hu-po/tatbot/README.md

<div align="center">
  <a href="https://tatbot.ai/">
    <picture>
      <source media="(prefers-color-scheme: dark)" srcset="docs/logos/dark.svg">
      tatbot
    </picture>
  </a>
</div>
<div align="center">
  
  
  <a href="https://poly.cam/capture/89a7df7a-9871-493c-aed9-289028c1e38e" target="_blank" rel="noopener noreferrer">
    
  </a>
  <a href="https://huggingface.co/tatbot/datasets">
    
  </a>
  <br>
  <a href="https://x.com/tatbots">
    
  </a>
  <a href="https://www.tiktok.com/@tatbottok">
    
  </a>
  <a href="https://www.instagram.com/tatbots/">
    
  </a>
  <a href="https://www.youtube.com/@tatbot">
    
  </a>
</div>

# **tatbot**: tattoo robot

Tatbot is an open robotics project exploring robot-assisted tattoo design and
placement. The repository contains the software, data formats, and examples
used by developers and artists contributing to the project.

📚 Read the [documentation](https://hu-po.github.io/tatbot/)

🎥 Watch the [livestream](https://youtube.com/live/ym27ZHPMaec)

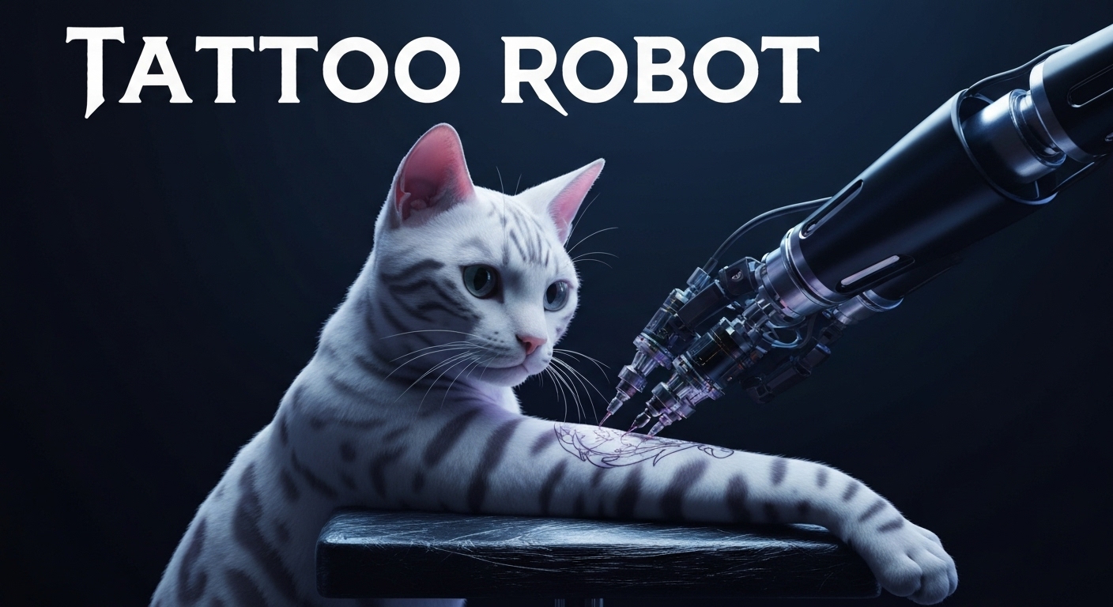
[picture p1: docs/images/thumbnail.jpg]
YouTube Video (https://youtube.com/live/ym27ZHPMaec)


## Citation

```
@misc{tatbot-2025,
  title={tatbot},
  author={Hugo Ponte},
  year={2025},
  url={https://github.com/hu-po/tatbot}
}
```
