hu-po/tatbot/scripts/vision/requirements-observer.txt

# The stencil observer's interpreter on the camera node (`stencild`).
#
# fleet_deploy.py builds `<release>/observer-venv` from this file for the
# node that runs tatbot-stencild.service. The observer runs
# scripts/vision/stencil_observer.py: the fiducial-tile reading
# (fiducials.stencil, numpy and OpenCV only) and the digest-bound capture
# readers under scripts/lib and scripts/vision. No RealSense wheel: distortion deprojection is the numpy
# port pinned by the checked-in SDK table. scipy is deliberately absent: only
# the session scan-binding path reaches it, and the fleet observer never
# binds a scan.
numpy==2.5.4
opencv-python-headless==5.0.0.93
