hu-po/tatbot/docs/index.md

---
summary: Public Tatbot developer and artist documentation
tags: [index, public]
updated: 2026-09-03
audience: [dev, artist, contributor]
---

# Tatbot

Tatbot is an open robotics project for exploring robot-assisted tattoo design
and placement. This site documents public technical interfaces:
teleoperation, vision concepts, Inkmap, contribution workflow, and safety scope.

```{admonition} Scope
:class: warning

The public project is a research and software collaboration, not a tattooing
service or a medical device. The drawing stack tattoos practice skin and human
skin behind the interlocks in [safety scope](safety.md); replay and the mock
arm are the quickest way to develop.
```

## Start here

- [Overview and installation](development.md)
- [For artists: design and placement data](design-format.md)
- [Turn placement words into a body location with InkLang](inklang.md)
- [For developers: architecture](architecture.md)
- [Contributing](contributing.md)
- [Work: worktrees, landing, the sweeper](work.md)

## Public systems

- [Robot model and kinematics](robot.md)
- [Teleoperation](teleop_tuning.md)
- [Vision and fiducials](vision.md)
- [The skin stencil: fiducial tiles](stencil-frames.md)
- [Rig sleep and wake](rig.md)
- [Fleet deploy, releases and services](fleet.md)
- [Imitation-learning interfaces](imitation_learning.md)
- [Inkmap preview](inkmap.md)
- [DrawingBotV3 stroke experiments](drawingbot.md)
- [Tools and configuration](tools.md)
- [Bill of materials](bill-of-materials.md)
- [Run-log format](run_logs.md)

## Safety and reference

- [Safety scope](safety.md)
- [Hardware e-stop contract](estop.md)
- [Command-line reference](cli.md)
- [Configuration](configuration.md)
- [Documentation style](style_guide.md)
- [Release notes](release-notes.md)

```{toctree}
:maxdepth: 2
:caption: Contents
:hidden:

development
design-format
architecture
contributing
work
robot
teleop_tuning
fleet
surface-formats
vision
stencil-frames
rig
demo-stack
fiducials
ordered_fiducials
ee_fiducial_tracking
imitation_learning
inkmap
human-representation
drawingbot
research
inklang
ink
palette
tools
bill-of-materials
run_logs
safety
estop
cli
configuration
style_guide
release-notes
logos/index
```
