hu-po/tatbot/docs/cli.md

# `tatbot` command reference

<!-- GENERATED by `scripts/tatbot schema --md > docs/cli.md`. Do not edit; `scripts/check cli` fails when stale. -->

Offline CLI workflows for public development and replay. Maintainers can inspect the complete machine-readable schema with `tatbot schema --json`.

```
tatbot [global flags] <noun> [verb] [args] [-- passthrough args]
```

Global flags may appear anywhere before the first `--`, as `--flag value` or `--flag=value`, unless a declared command option owns that spelling: `--json`, `--dry-run`, `--explain`, `-q`, `-v`. Stating one twice with different values is a usage error.

`--json` execution is supported only by commands declaring structured output in `schema --json`; all commands support JSON plans and explanations. Backend flags on structured commands require `--`; tokens after it are preserved.

CLI-owned exit codes are below. Executed backends and SSH retain their own exit codes and error output; backend failures are not remapped to 1.

## Exit codes

| code | meaning |
| --- | --- |
| 0 | ok |
| 1 | underlying tool failed |
| 2 | usage error |
| 3 | safety gate refused |
| 4 | wrong node for this verb |
| 5 | hardware unreachable |
| 6 | busy |

## Safety tiers

| tier | meaning | gates |
| --- | --- | --- |
| `offline` | files only | — |

## Verbs

### `tatbot completion` — generate opt-in shell completion

| verb | tier | runs on | wraps | summary |
| --- | --- | --- | --- | --- |
| `completion bash` | `offline` | this checkout | native | print Bash completion generated from canonical command metadata |

### `tatbot body` — immutable human body model assets and cache audit

| verb | tier | runs on | wraps | summary |
| --- | --- | --- | --- | --- |
| `body bootstrap` | `offline` | this checkout | native | copy a pinned, pre-downloaded MHR and SOMA allowlist into an explicit verified cache |
| `body audit` | `offline` | this checkout | native | read and hash every byte in an explicit MHR and SOMA cache without deserializing it |

### `tatbot teleop` — leader→follower teleoperation

| verb | tier | runs on | wraps | summary |
| --- | --- | --- | --- | --- |
| `teleop poses` | `offline` | this checkout | `scripts/vision/teleop_poses.py` | export measured follower tip poses and host read timestamps from a flight log (`--ee-tool`) |
| `teleop analyze` | `offline` | this checkout | `cpp/teleop/analyze_log.py` | loop-timing stats from a .wxtl without a GUI |

### `tatbot rollout` — offline checks of a trained policy: its contract, its action plausibility

| verb | tier | runs on | wraps | summary |
| --- | --- | --- | --- | --- |
| `rollout bench` | `offline` | this checkout | `scripts/eval/trajectory_plausibility.py` | no-robot plausibility check of a policy's action chunks (`--` → trajectory_plausibility.py) |
| `rollout contract` | `offline` | this checkout | `scripts/eval/checkpoint_contract.py` | the input/action contract stored with a checkpoint (`--` → checkpoint_contract.py) |

### `tatbot calib` — native arm measurements and retained overhead registration

| verb | tier | runs on | wraps | summary |
| --- | --- | --- | --- | --- |
| `calib register-fit` | `offline` | this checkout | `scripts/vision/native_registration.py` | fit an unadopted overhead registration from original native holds and shared geometry |

### `tatbot vision` — offline vision processing and calibration

| verb | tier | runs on | wraps | summary |
| --- | --- | --- | --- | --- |
| `vision depth compare` | `offline` | this checkout | `scripts/vision/depth_compare.py` | compare filters on a retained raw scan burst |
| `vision stencil generate` | `offline` | this checkout | `scripts/lib/stencil_generate.py`, `scripts/lib/stencil_tile.py` | generate the skin stencil: a fiducial tile of AprilTag 16h5 markers with its 300 dpi print |
| `vision stencil reference` | `offline` | this checkout | `scripts/lib/stencil_reference.py` | export a tracking manifest for a generated fiducial tile, and install it where the observer reads |
| `vision tags print` | `offline` | this checkout | `scripts/vision/generate_wrist_tags.py` | render the wrist-tag print sheet (`--` → generate_wrist_tags.py) |
| `vision handeye d405` | `offline` | this checkout | `scripts/vision/d405_handeye_plane.py` | plane-route hand-eye for the wrist D405s: fit depth planes against the touched-off paper (`--` → d405_handeye_plane.py) |

### `tatbot drawingbot` — DrawingBotV3 stroke experiments and preference review

| verb | tier | runs on | wraps | summary |
| --- | --- | --- | --- | --- |
| `drawingbot generate` | `offline` | this checkout | `scripts/drawingbot.sh`, `scripts/drawingbot.py`, `scripts/lib/drawing_python.sh`, `scripts/lib/drawing_python.py`, `scripts/lib/drawingbot/artifacts.py`, `scripts/lib/drawingbot/bridge.py`, `scripts/lib/drawingbot/replay.py`, `scripts/lib/drawingbot/recipe.py`, `scripts/lib/drawingbot/container.py`, `scripts/lib/drawingbot/job.py`, `scripts/lib/drawingbot/pens.py` | generate one physical DBV3 drawing with verified settings and a saved native recipe |
| `drawingbot export` | `offline` | this checkout | `scripts/drawingbot.sh`, `scripts/drawingbot.py`, `scripts/lib/drawing_python.sh`, `scripts/lib/drawing_python.py`, `scripts/lib/drawingbot/artifacts.py`, `scripts/lib/drawingbot/bridge.py`, `scripts/lib/drawingbot/replay.py`, `scripts/lib/drawingbot/recipe.py`, `scripts/lib/drawingbot/container.py` | verify and replay native SVG acquisition only, without ROS compilation |
| `drawingbot container` | `offline` | this checkout | `scripts/drawingbot.sh`, `scripts/drawingbot.py`, `scripts/lib/drawing_python.sh`, `scripts/lib/drawing_python.py`, `scripts/lib/drawingbot/artifacts.py`, `scripts/lib/drawingbot/bridge.py`, `scripts/lib/drawingbot/replay.py`, `scripts/lib/drawingbot/recipe.py`, `scripts/lib/drawingbot/container.py` | build, smoke-test or run the private mounted-app acquisition container |

### `tatbot inkmap` — ground InkLang placements and preview tattoos on canonical bodies

| verb | tier | runs on | wraps | summary |
| --- | --- | --- | --- | --- |
| `inkmap dev` | `offline` | this checkout | `scripts/inkmap_dev.sh`, `web/inkmap/package.json` | the tattoo preview app on this machine (`--` → inkmap_dev.sh) |
| `inkmap resolve` | `offline` | this checkout | `web/inkmap/tools/resolve.ts`, `config/inkmap/inklang-resolution.schema.json`, `web/inkmap/package.json` | resolve InkLang placement text to a canonical rest-surface anchor as JSON |
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
