hu-po/tatbot/docs/development.md

---
summary: Public setup and developer workflows
tags: [setup, development]
updated: 2026-08-31
audience: [dev, contributor]
---

# Development

Tatbot is a collection of independently buildable components. You can work
on the web app, replay tools or the mock arm without access to robot hardware.

## Prerequisites

- Git
- Python 3.12 and `uv`
- A C++ toolchain and CMake for teleoperation work
- Rust and Cargo for the vision service
- Node.js 22 or newer for Inkmap
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
