hu-po/tatbot/docs/assets/stencil-coded/1/stencil.png

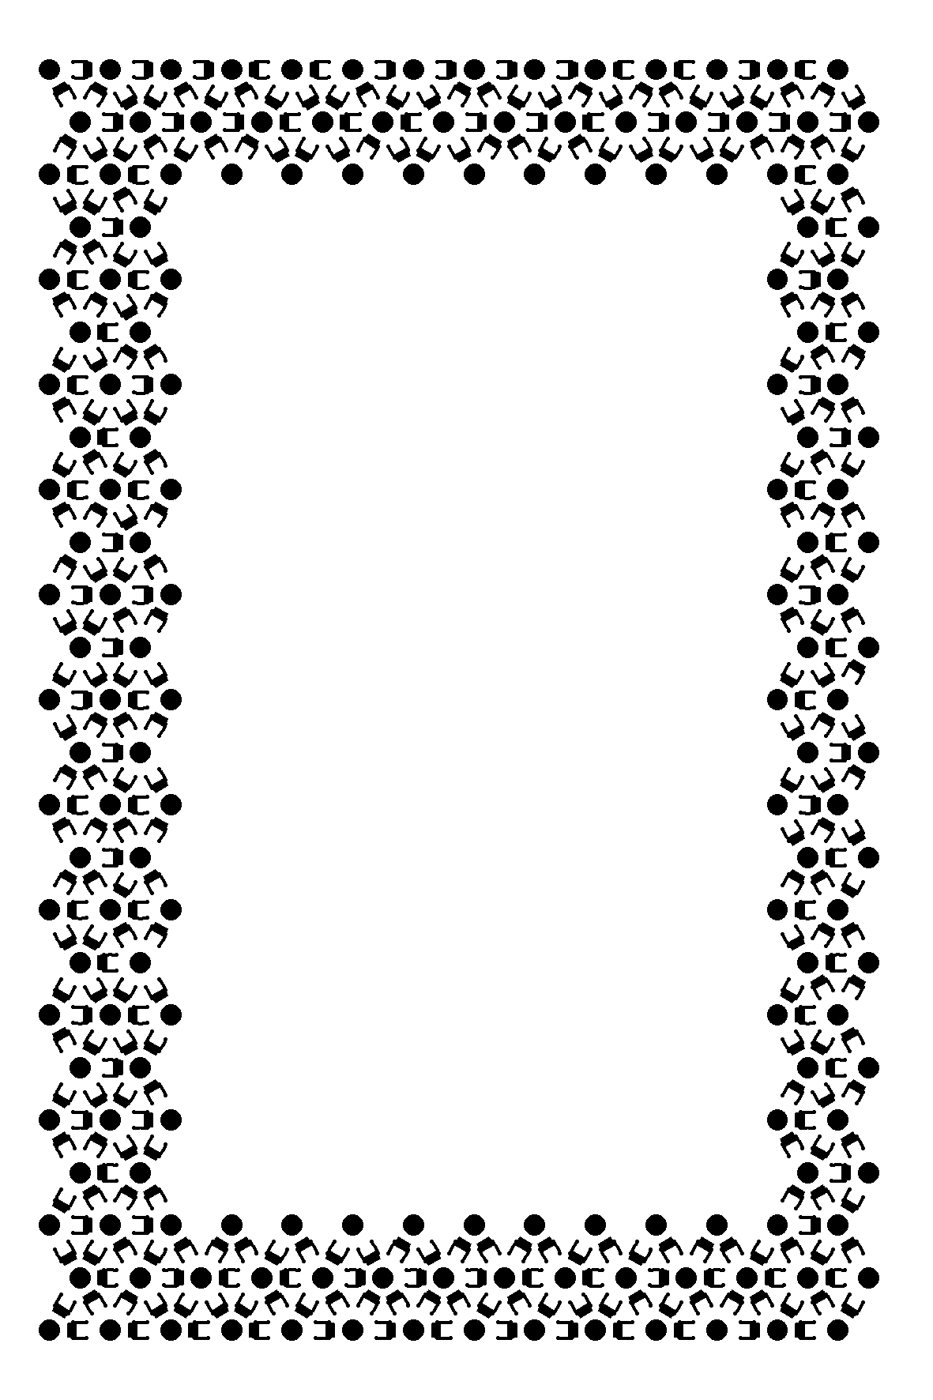
docs/assets/stencil-coded/1/stencil.png
