hu-po/tatbot/docs/assets/stencil-coded/3/stencil.png

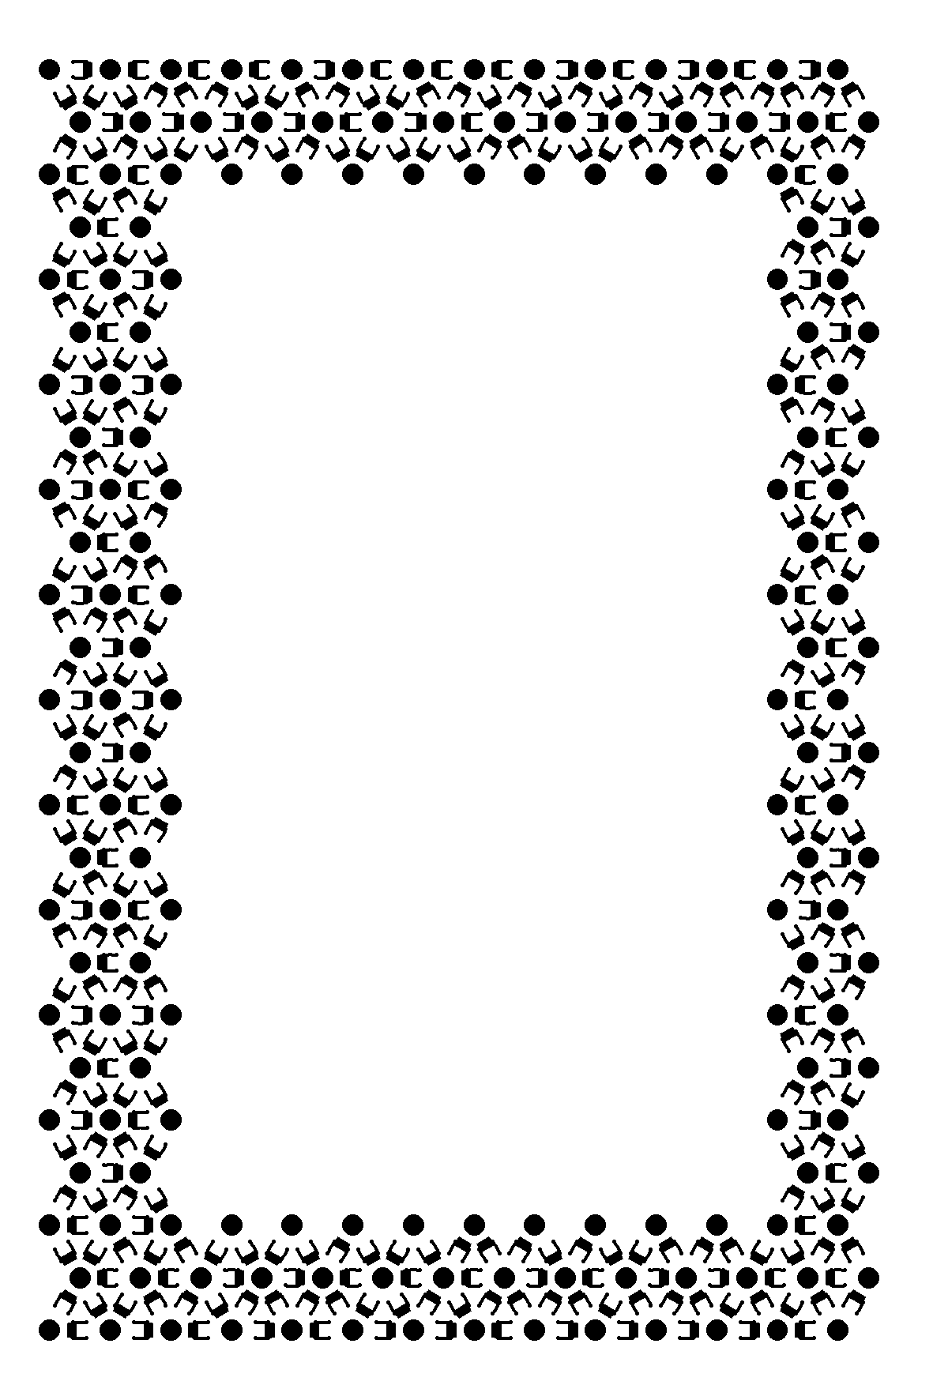
docs/assets/stencil-coded/3/stencil.png
