hu-po/tatbot/docs/assets/stencil-frames/tatbot-42/stencil.png

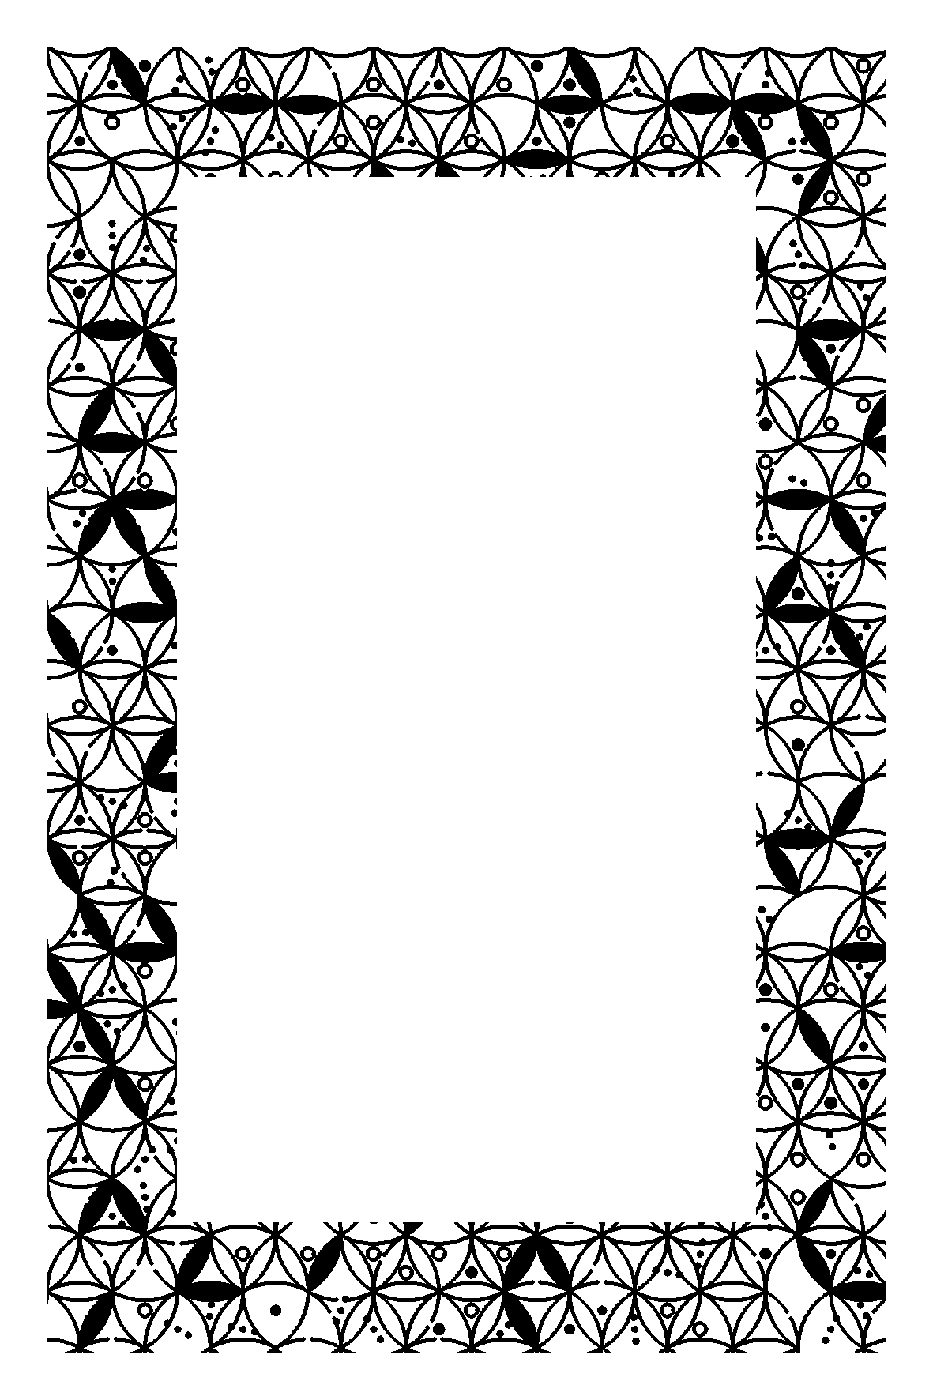
docs/assets/stencil-frames/tatbot-42/stencil.png
