hu-po/tatbot/docs/assets/stencil-frames/tatbot-43/stencil.png

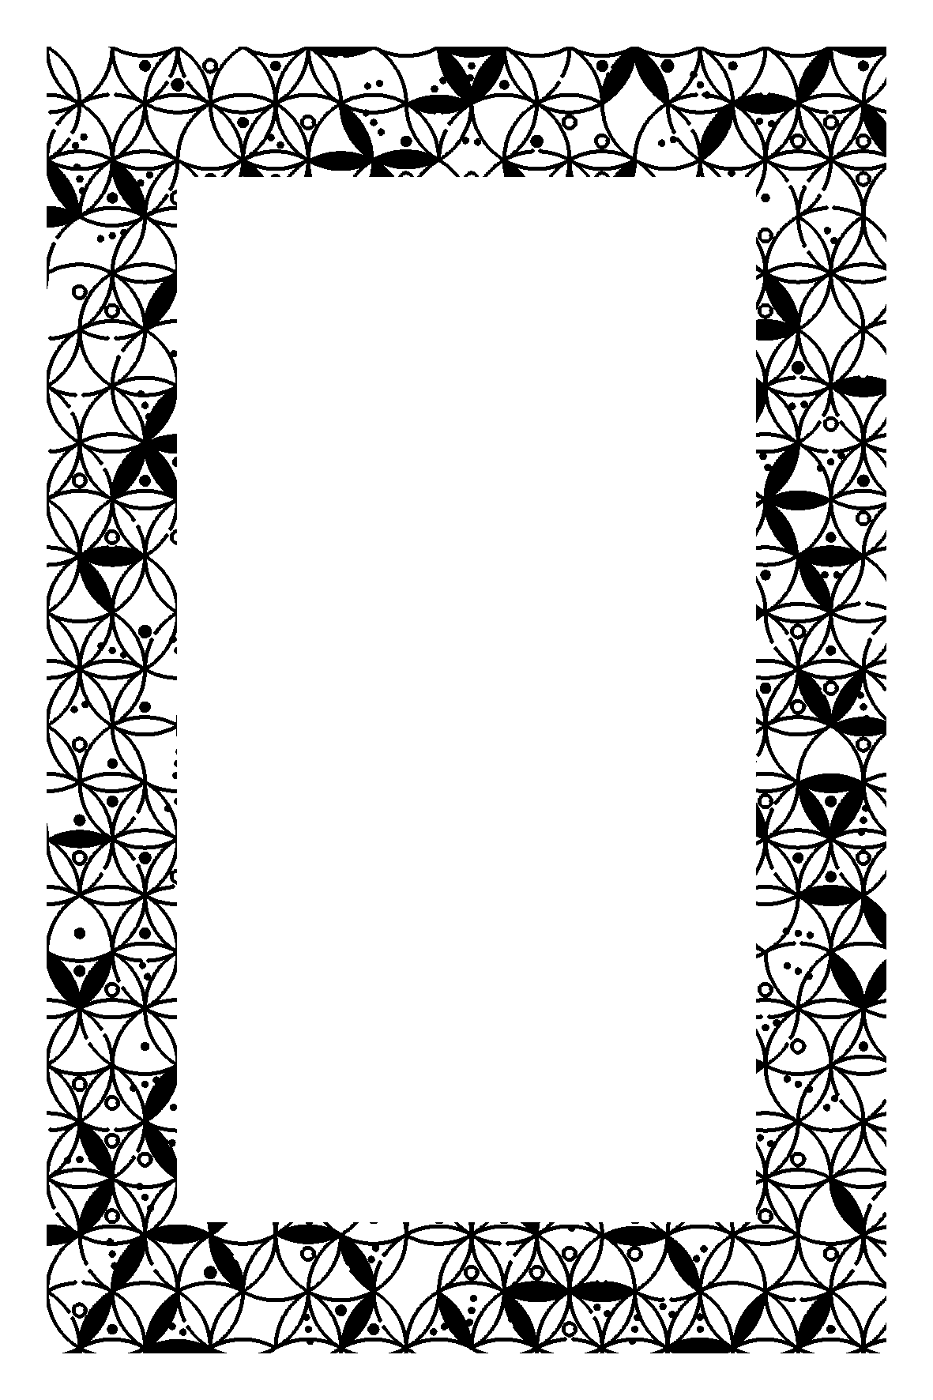
docs/assets/stencil-frames/tatbot-43/stencil.png
