hu-po/tatbot/docs/assets/stencil-frames/tatbot-44/stencil.png

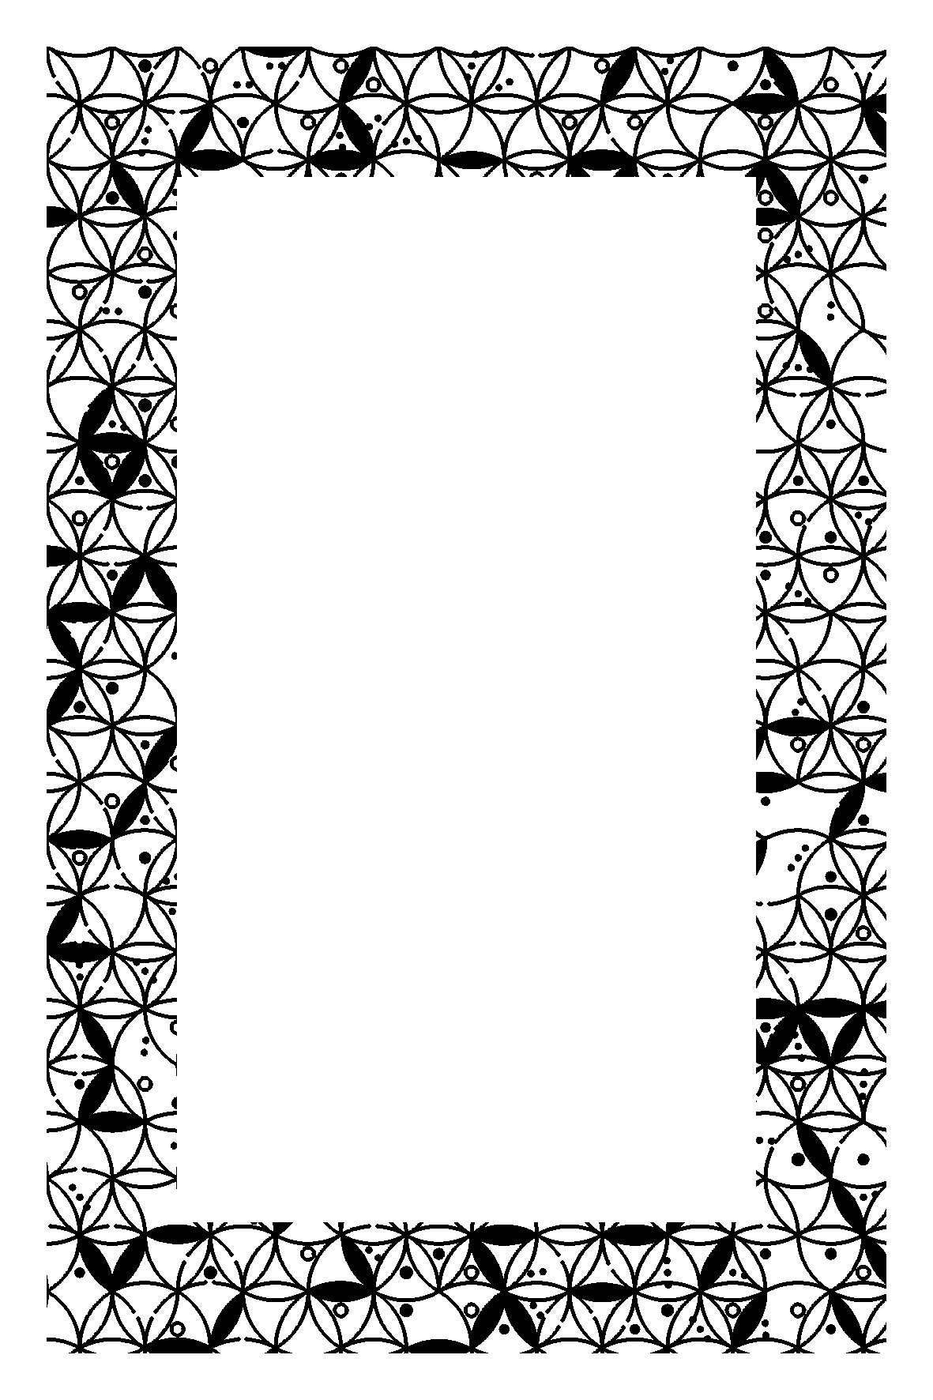
docs/assets/stencil-frames/tatbot-44/stencil.png
