hu-po/tatbot/docs/palette-tags-36h11.png

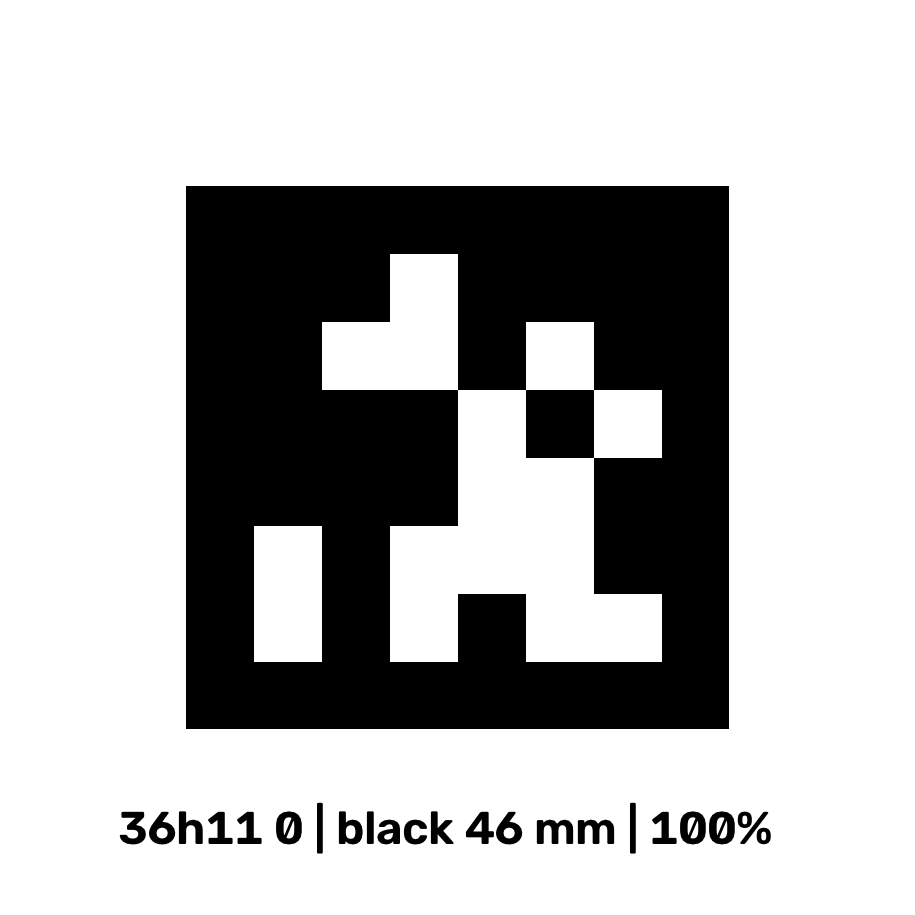
docs/palette-tags-36h11.png
