hu-po/tatbot/docs/wrist-tags-36h11.png

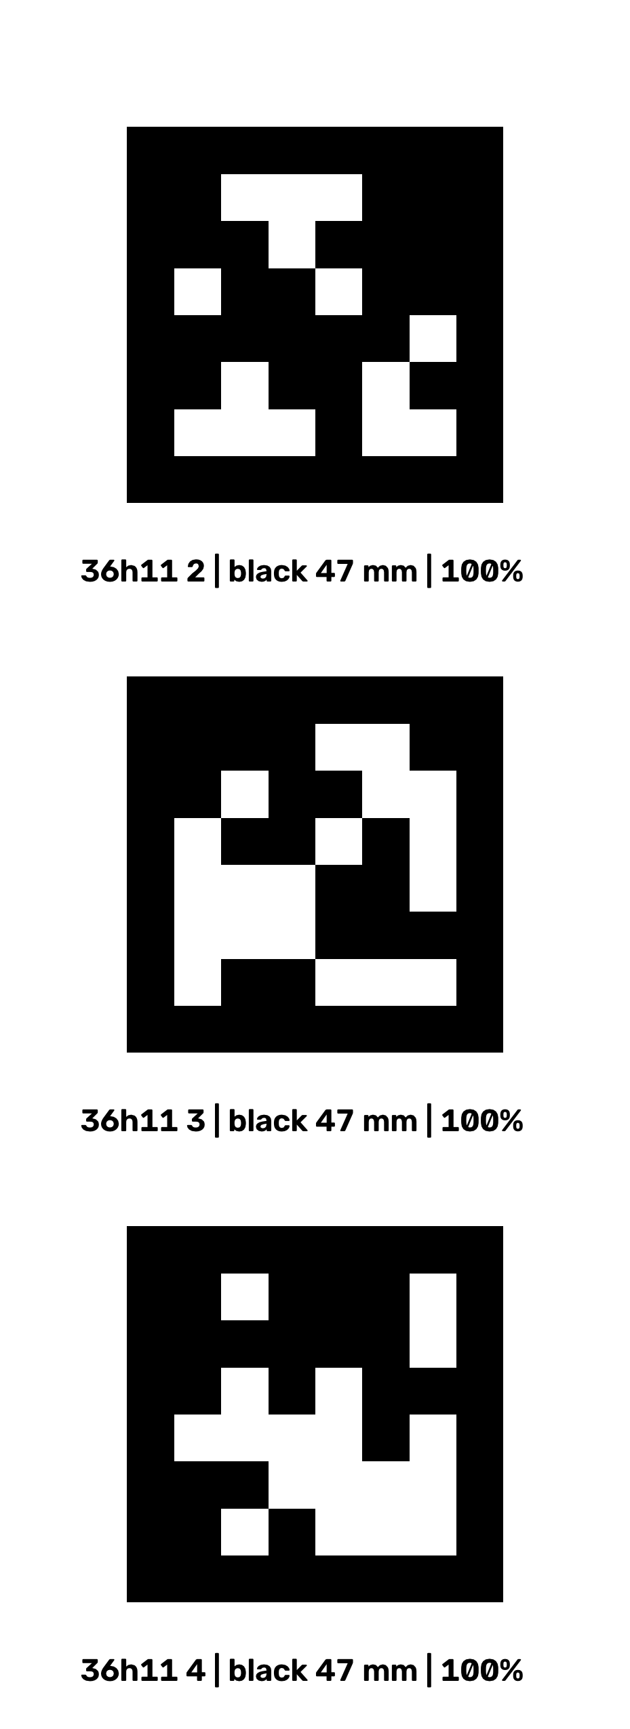
docs/wrist-tags-36h11.png
