hu-po/tatbot/docs/wrist_left-tags-36h11.png

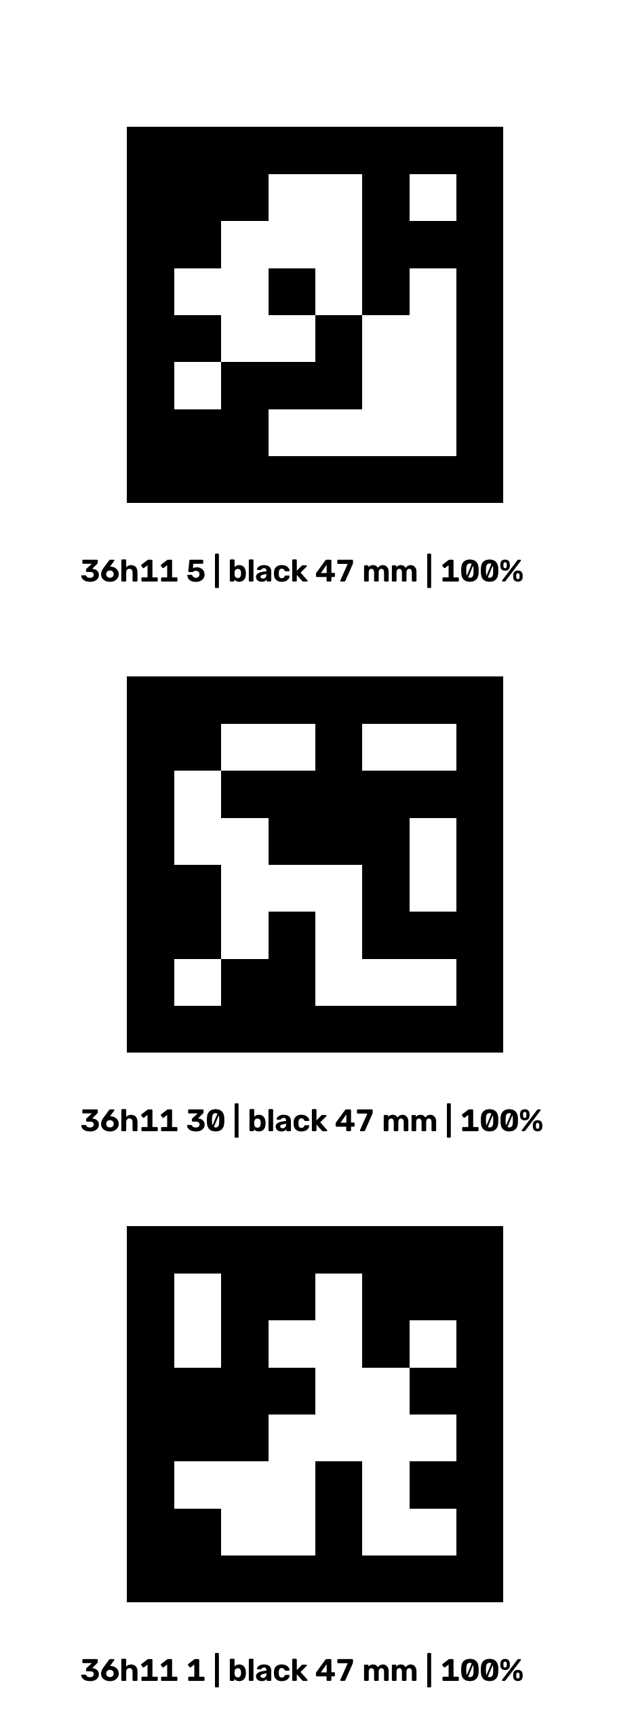
docs/wrist_left-tags-36h11.png
