hu-po/tatbot/python/tatbot_travel/src/tatbot_travel/data/selfview-left-a.png

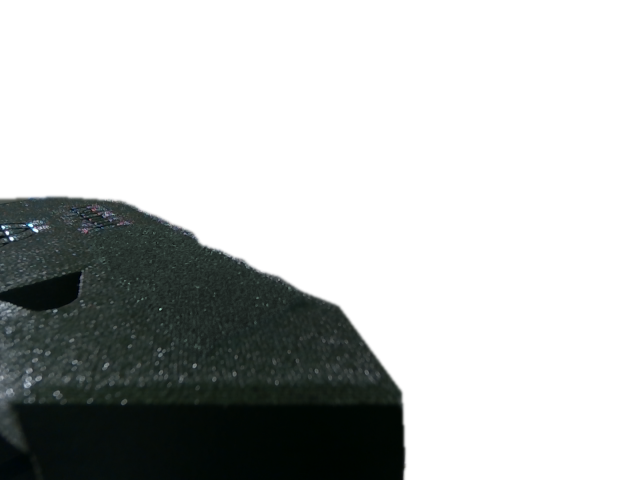
python/tatbot_travel/src/tatbot_travel/data/selfview-left-a.png
