hu-po/tatbot/python/tatbot_travel/src/tatbot_travel/data/selfview-left-b.png

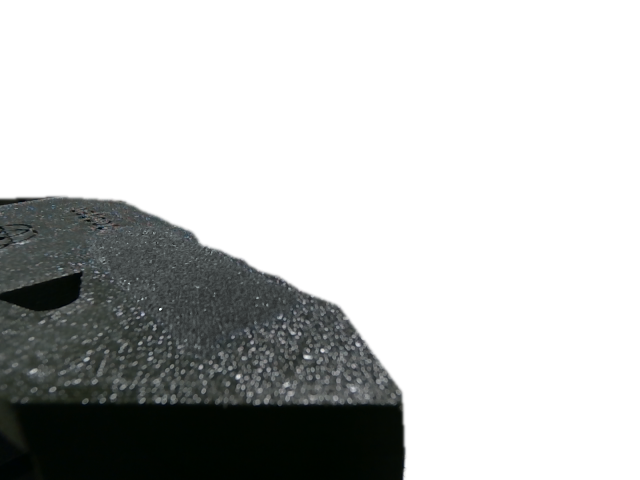
python/tatbot_travel/src/tatbot_travel/data/selfview-left-b.png
