hu-po/tatbot/urdf/meshes/tags/16h5_008_56mm/tag.png

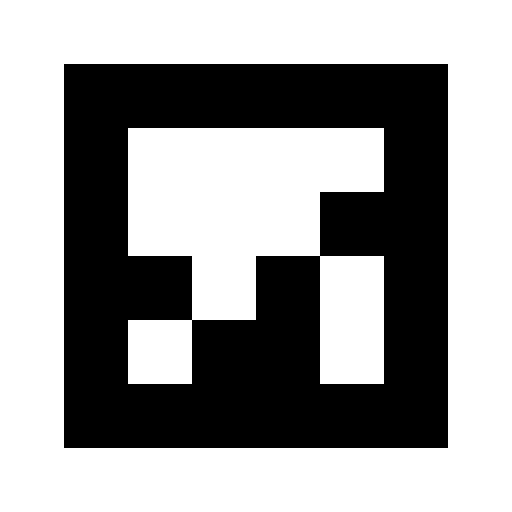
urdf/meshes/tags/16h5_008_56mm/tag.png
