hu-po/tatbot/urdf/meshes/tags/36h11_000_46mm/tag.png

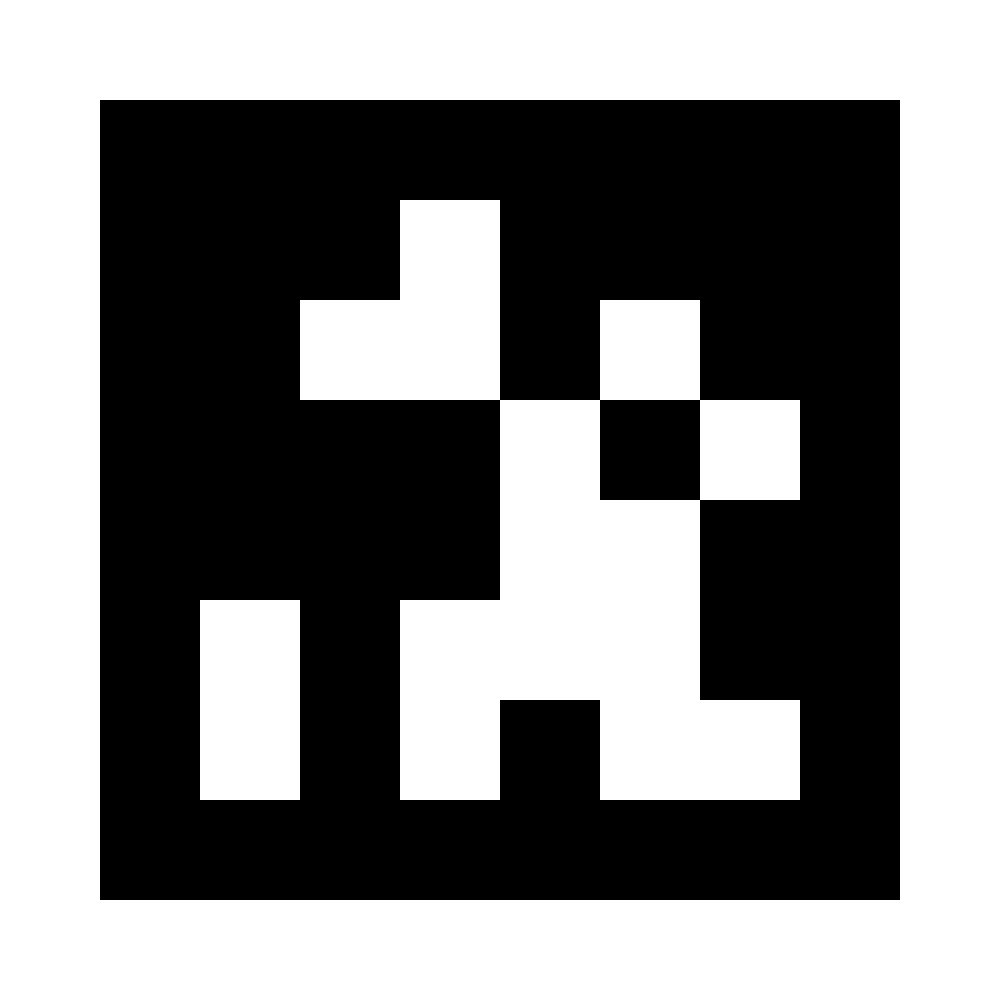
urdf/meshes/tags/36h11_000_46mm/tag.png
