hu-po/tatbot/urdf/meshes/tags/36h11_004_47mm/tag.png

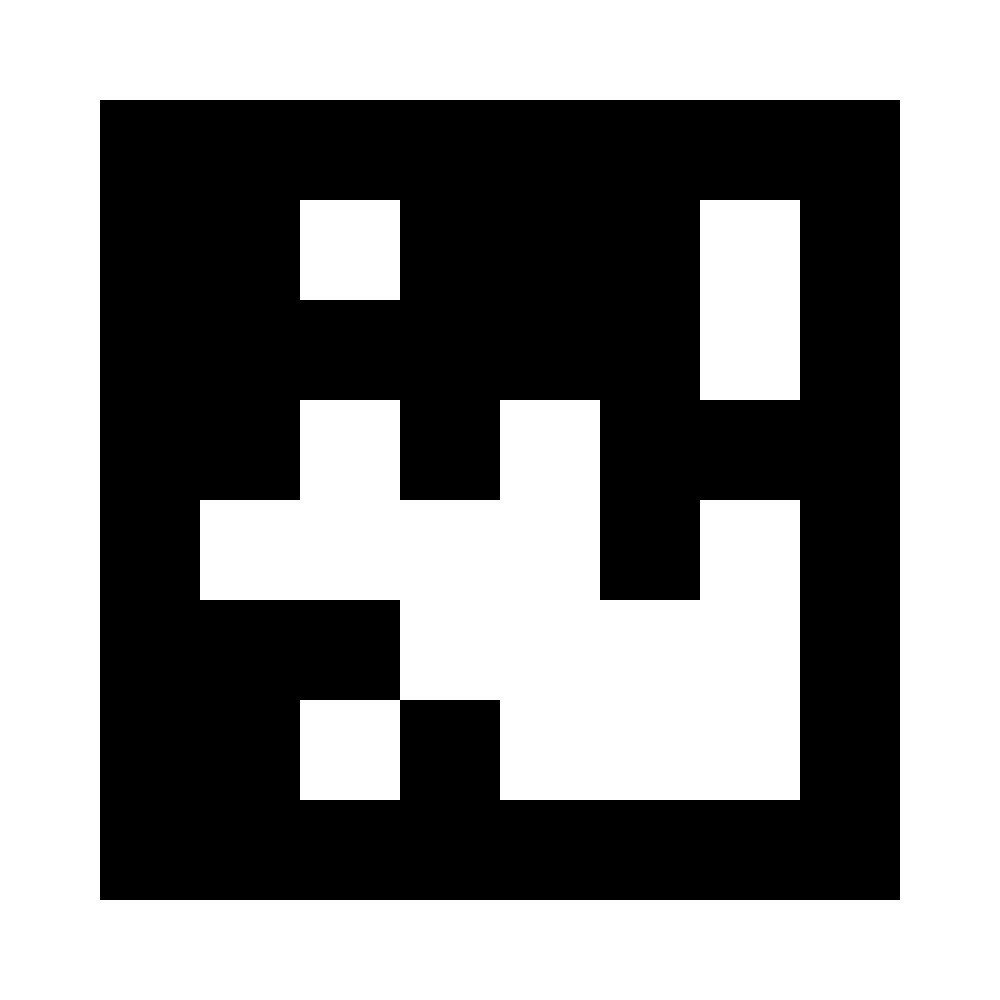
urdf/meshes/tags/36h11_004_47mm/tag.png
