hu-po/tatbot/urdf/meshes/tags/36h11_005_47mm/tag.png

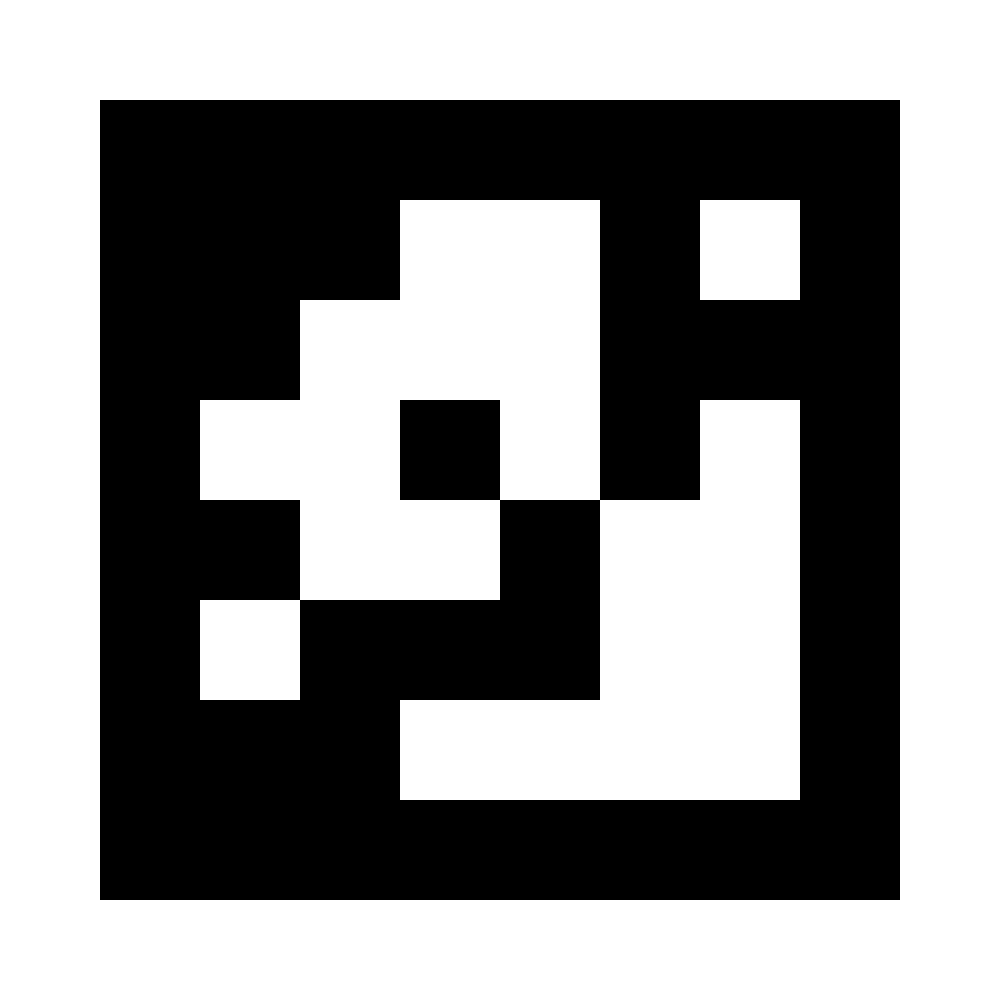
urdf/meshes/tags/36h11_005_47mm/tag.png
