hu-po/tatbot/urdf/meshes/tags/36h11_030_47mm/tag.png

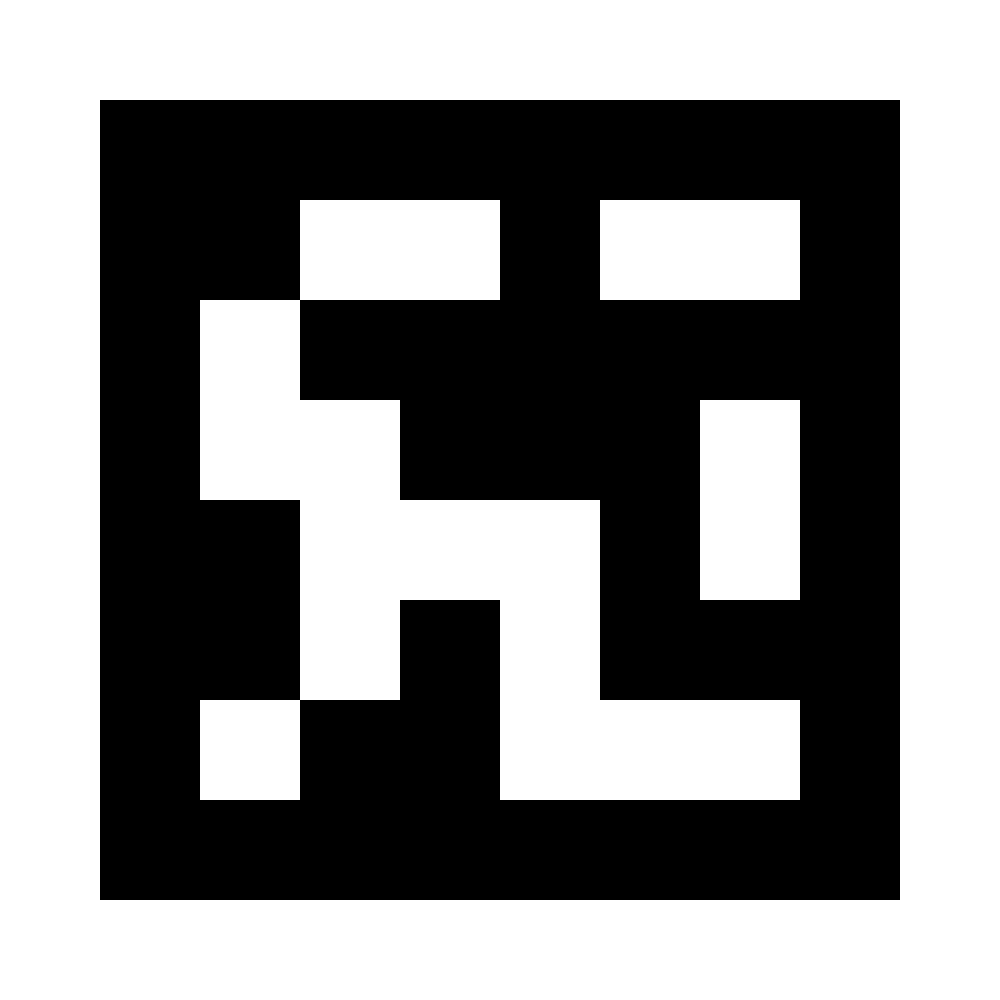
urdf/meshes/tags/36h11_030_47mm/tag.png
