hu-po/tatbot/docs/assets/ordered-fiducial-sheet.png

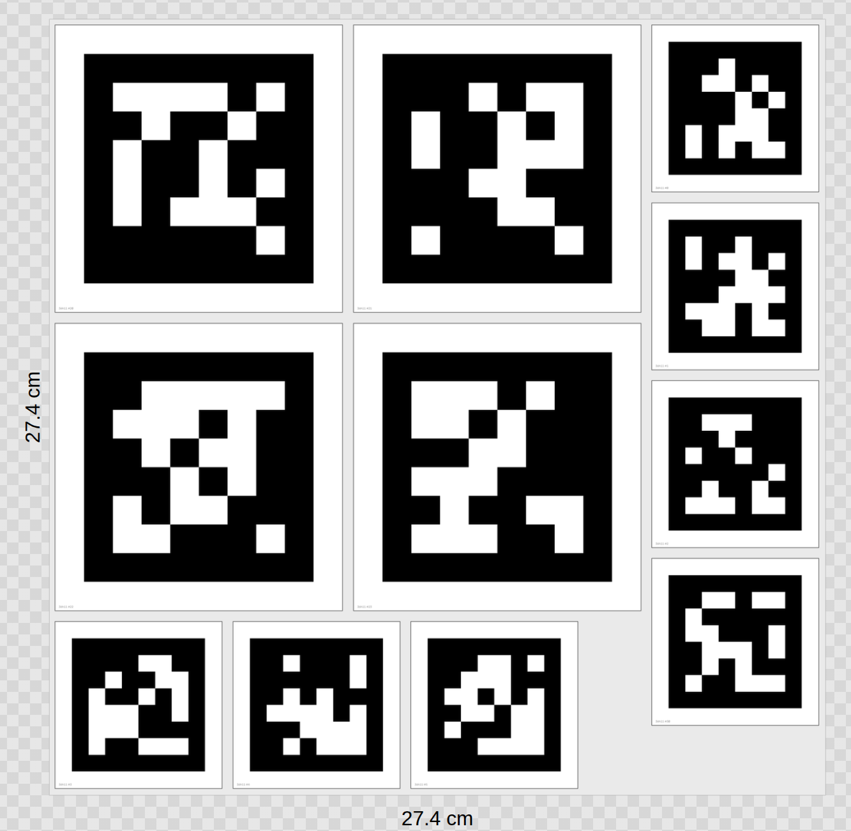
docs/assets/ordered-fiducial-sheet.png
