hu-po/tatbot/urdf/meshes/cameras/d405.stl

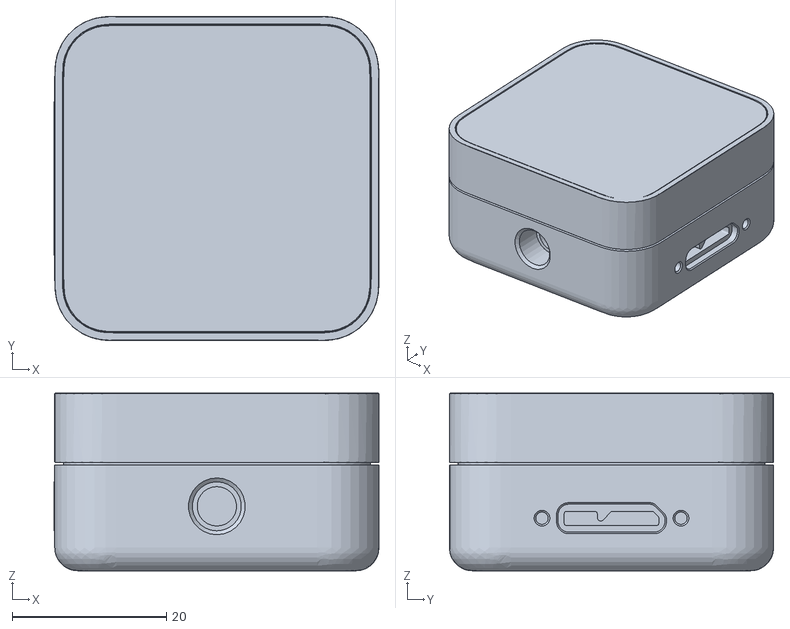
[picture p21: CAD file, 2026-09-01]
urdf/meshes/cameras/d405.stl
42.1 x 42.0 x 23.0
