hu-po/tatbot/urdf/meshes/ee/fiducial-cubes-47mm-rear/left_fiducial_cube_47mm.stl

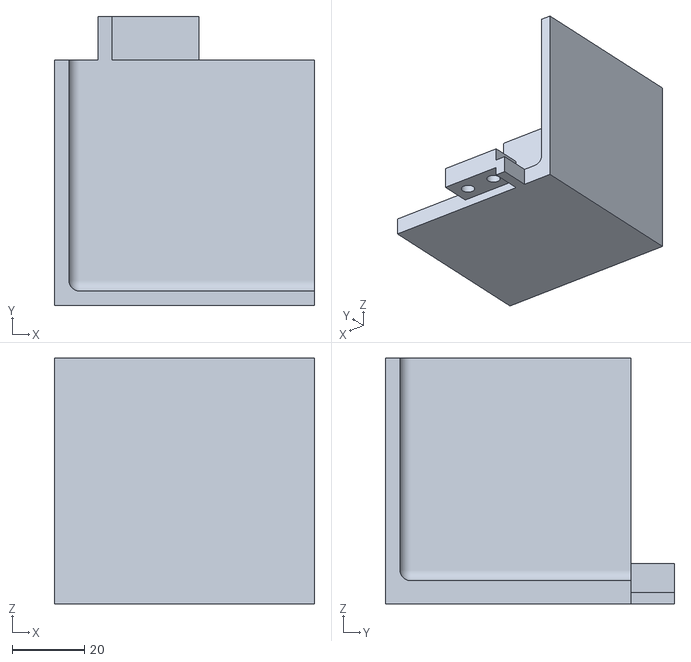
[picture p22: CAD file, 2026-10-06]
urdf/meshes/ee/fiducial-cubes-47mm-rear/left_fiducial_cube_47mm.stl
72.0 x 80.0 x 68.0
