hu-po/tatbot/urdf/meshes/ee/leader-laser-v5/02_oval_clamp_cap.stl

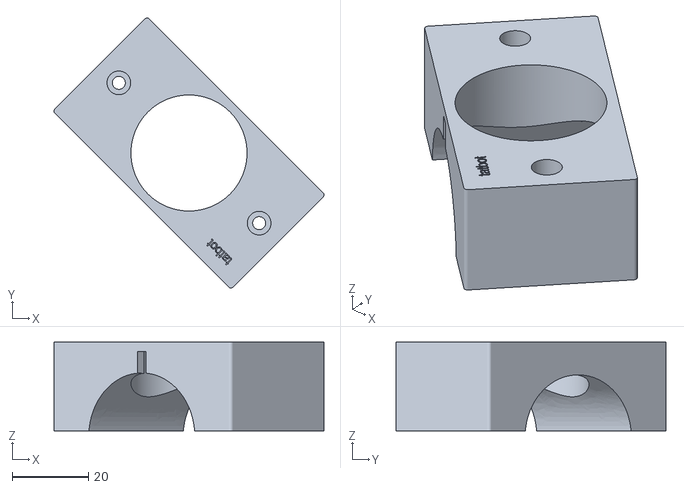
[picture p23: CAD file, 2026-10-06]
urdf/meshes/ee/leader-laser-v5/02_oval_clamp_cap.stl
70.8 x 70.8 x 23.2
