hu-po/tatbot/urdf/meshes/ee/pen_tip_v17.stl

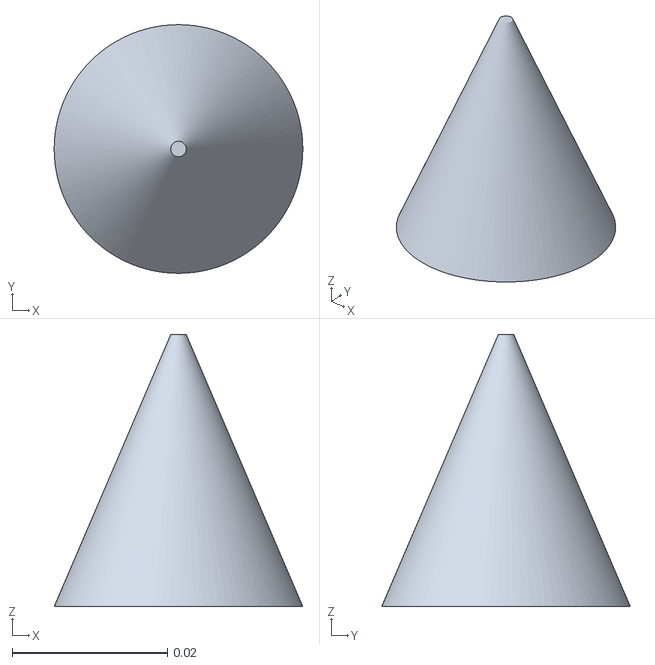
[picture p24: CAD file, 2026-10-06]
urdf/meshes/ee/pen_tip_v17.stl
0.032 x 0.032 x 0.035
