hu-po/tatbot/urdf/meshes/ee/v17/01_cradle_and_brace.stl

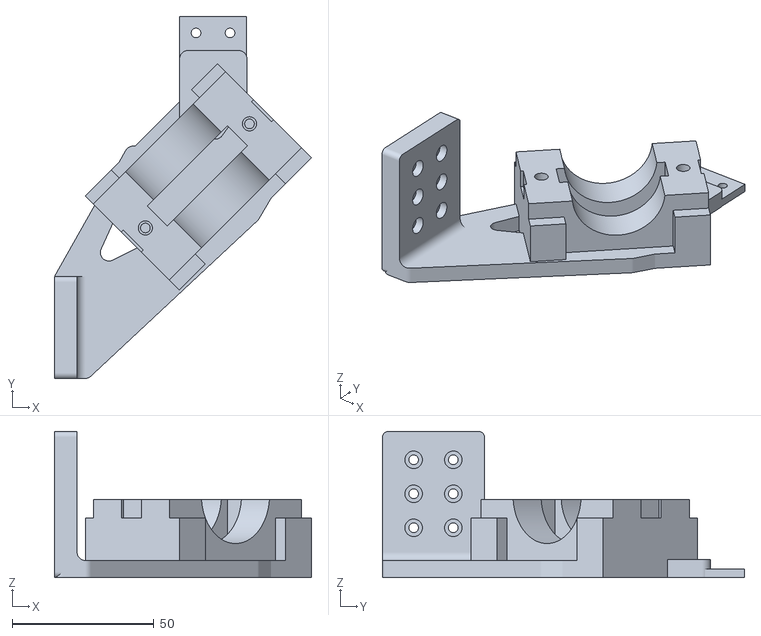
[picture p25: CAD file, 2026-10-06]
urdf/meshes/ee/v17/01_cradle_and_brace.stl
90.8 x 127.8 x 51.6
