hu-po/tatbot/urdf/meshes/frame/t2020_600mm.stl

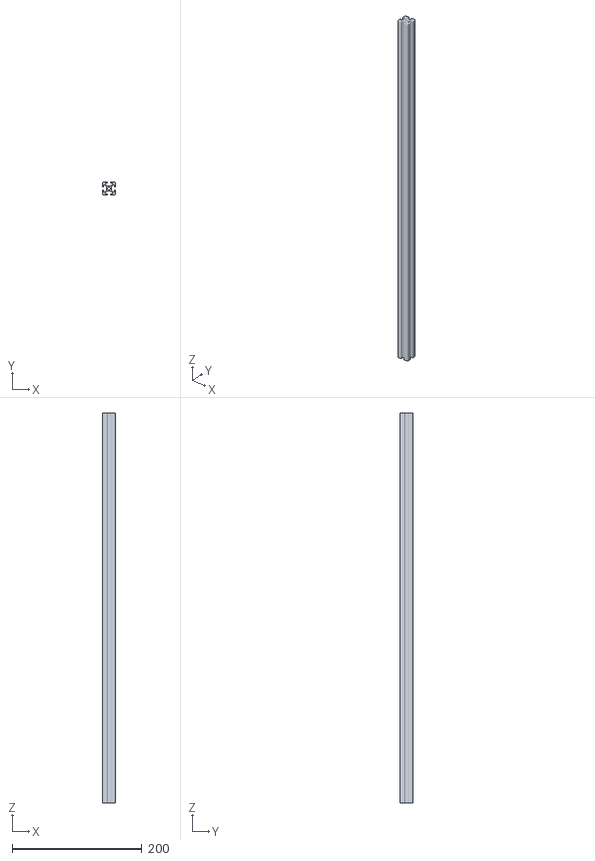
[picture p26: CAD file, 2026-09-01]
urdf/meshes/frame/t2020_600mm.stl
20.0 x 20.0 x 600.0
