hu-po/tatbot/urdf/meshes/palette/calibration_palette_v11.stl

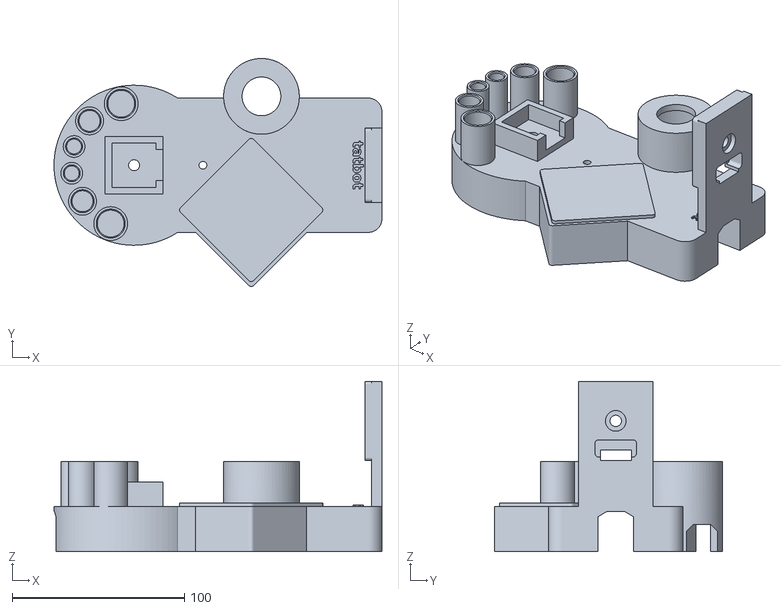
[picture p27: CAD file, 2026-10-06]
urdf/meshes/palette/calibration_palette_v11.stl
190.5 x 132.4 x 99.0
