hu-po/tatbot/urdf/meshes/tags/16h5_008_56mm/tag.obj

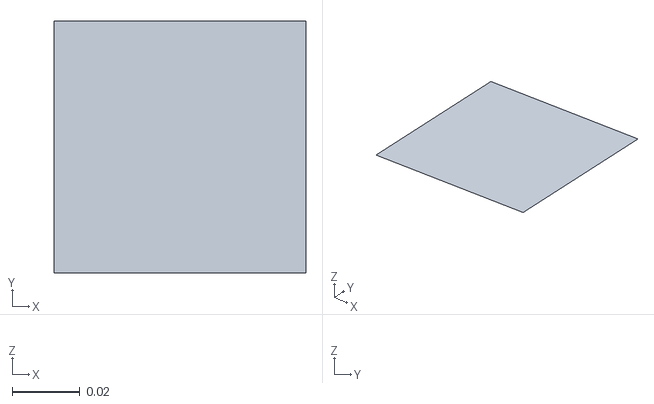
[picture p28: CAD file, 2026-10-06]
urdf/meshes/tags/16h5_008_56mm/tag.obj
0.0747 x 0.0747 x 0
