hu-po/tatbot/urdf/meshes/wxai/link_5.stl

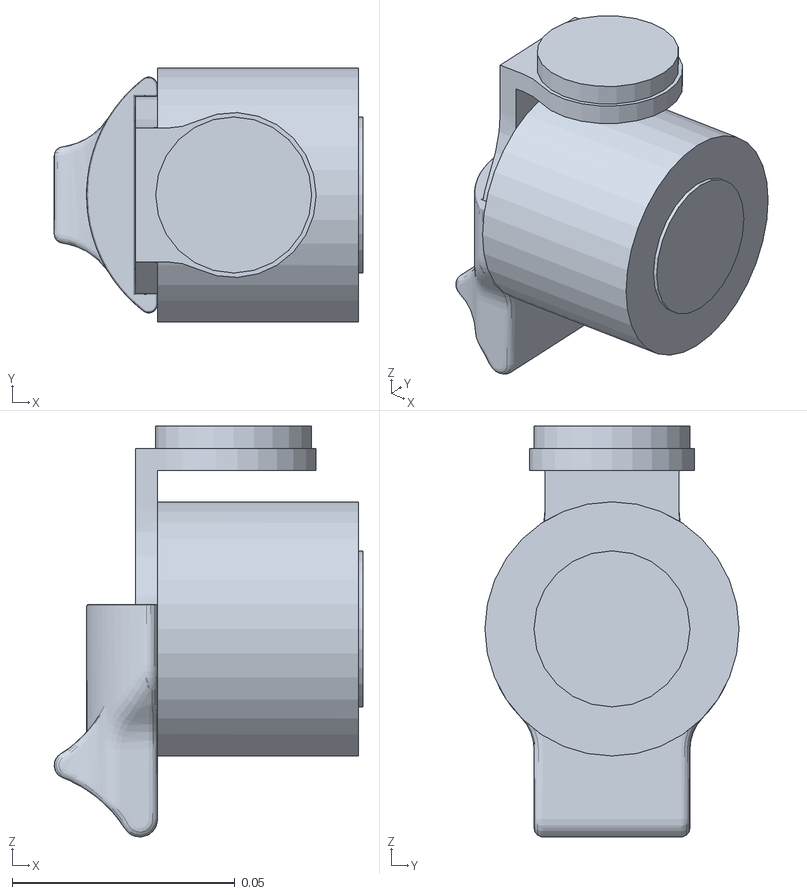
[picture p29: CAD file, 2026-09-01]
urdf/meshes/wxai/link_5.stl
0.0692 x 0.057 x 0.0922
