hu-po/tatbot/urdf/meshes/cameras/amcrest.stl

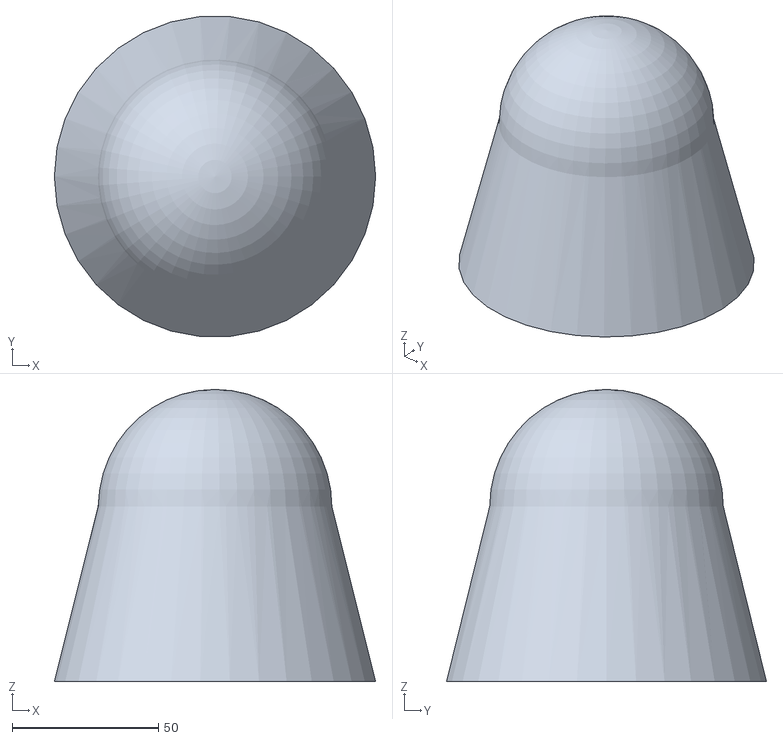
[picture p30: CAD file, 2026-09-01]
urdf/meshes/cameras/amcrest.stl
110.0 x 109.5 x 100.0
