hu-po/tatbot/urdf/meshes/ee/leader-laser-v5/01_leader_cradle.stl

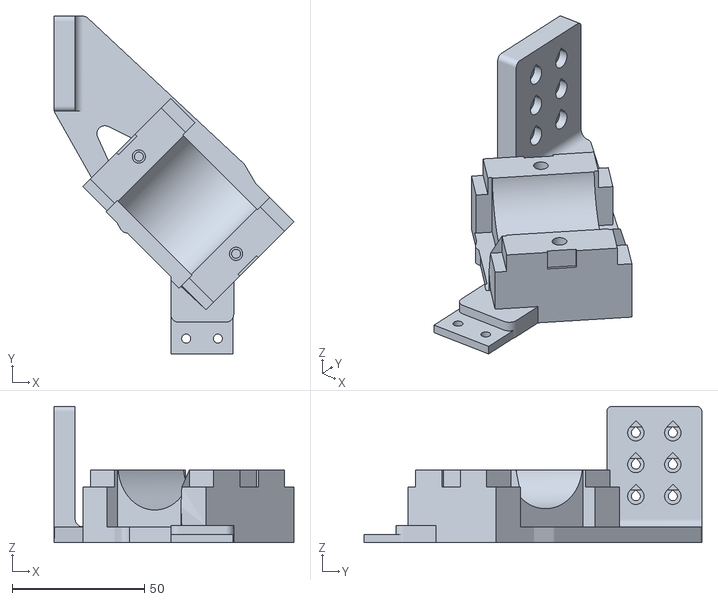
[picture p31: CAD file, 2026-10-06]
urdf/meshes/ee/leader-laser-v5/01_leader_cradle.stl
90.8 x 127.8 x 51.6
