hu-po/tatbot/urdf/meshes/ee/v17/02_clamp_cap.stl

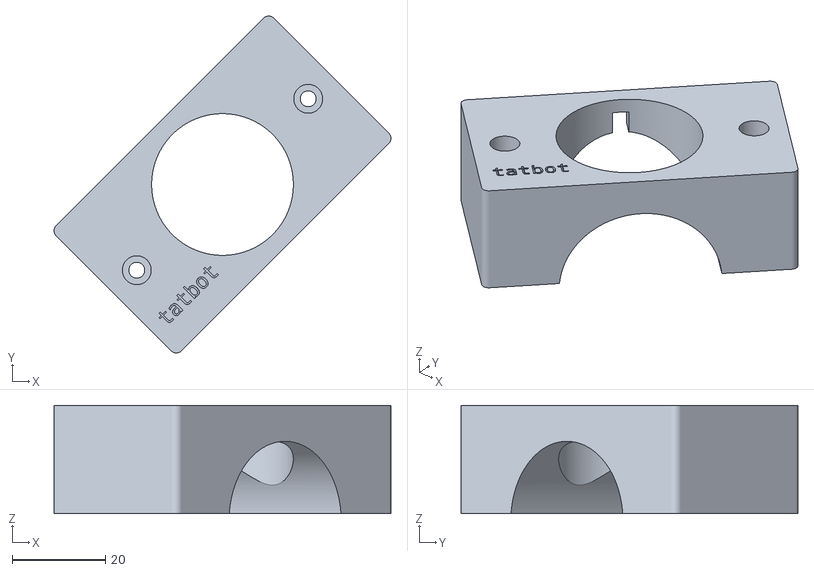
[picture p32: CAD file, 2026-10-06]
urdf/meshes/ee/v17/02_clamp_cap.stl
72.3 x 72.3 x 23.2
