hu-po/tatbot/urdf/meshes/frame/t2020_300mm.stl

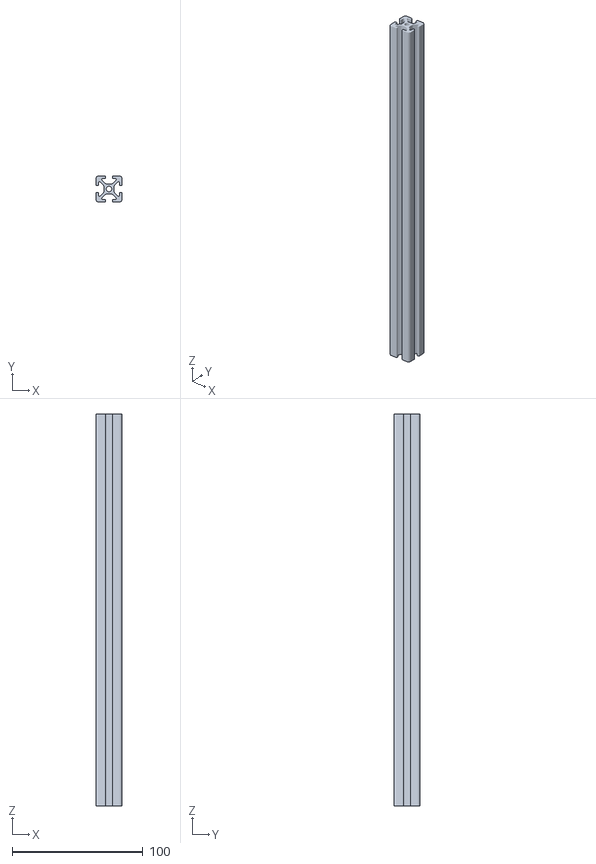
[picture p33: CAD file, 2026-09-01]
urdf/meshes/frame/t2020_300mm.stl
20.0 x 20.0 x 300.0
