hu-po/tatbot/urdf/meshes/wxai/link_6.stl

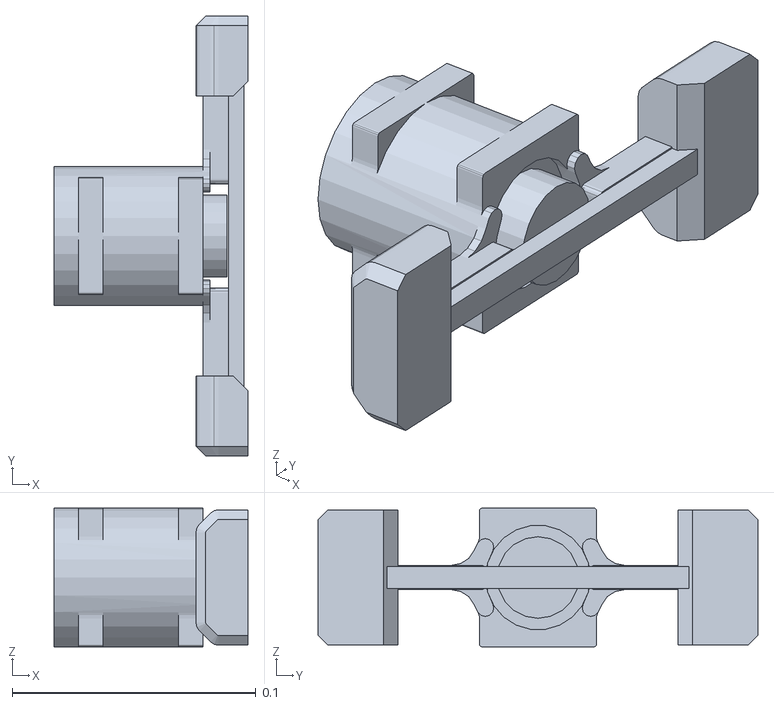
[picture p34: CAD file, 2026-09-01]
urdf/meshes/wxai/link_6.stl
0.0795 x 0.181 x 0.057
