hu-po/tatbot/urdf/meshes/ee/leader-laser-v5/03_mirrored_tag_carrier.stl

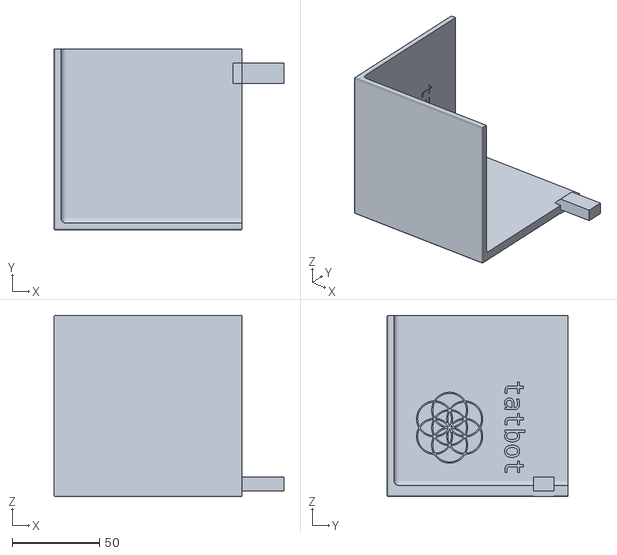
[picture p35: CAD file, 2026-10-06]
urdf/meshes/ee/leader-laser-v5/03_mirrored_tag_carrier.stl
132.0 x 104.0 x 104.0
