hu-po/tatbot/urdf/meshes/wxai/leader_finger_left_thumb.stl

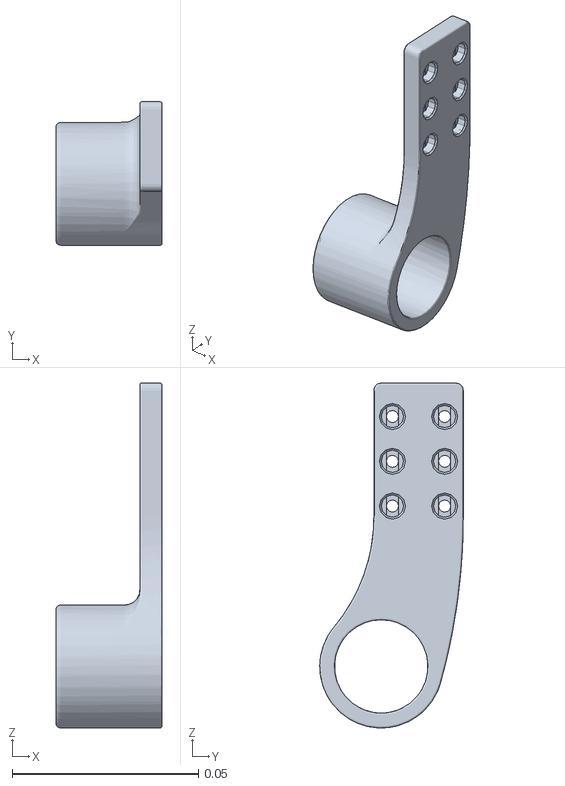
[picture p36: CAD file, 2026-09-01]
urdf/meshes/wxai/leader_finger_left_thumb.stl
0.0285 x 0.0385 x 0.0925
