hu-po/tatbot/urdf/meshes/wxai/carriage_left.stl

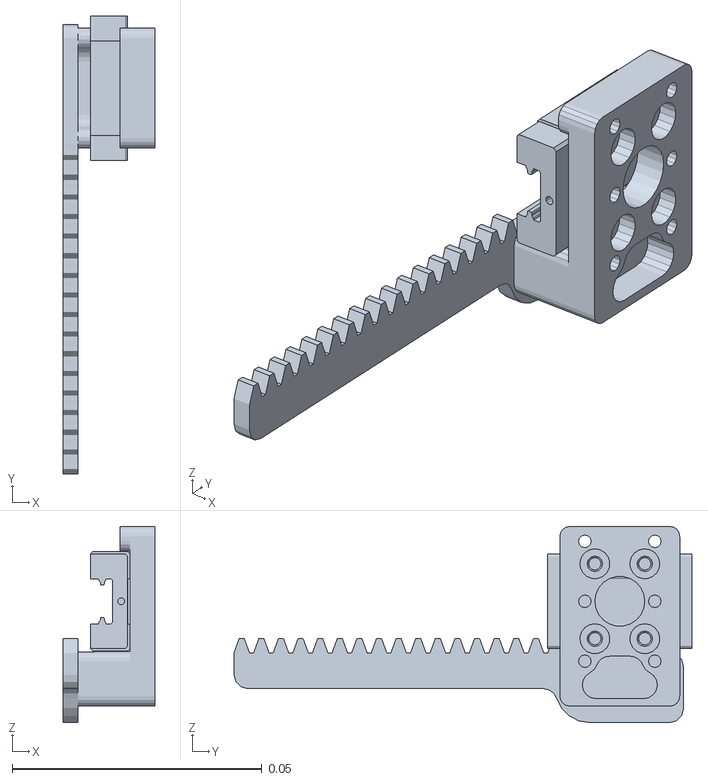
[picture p37: CAD file, 2026-09-01]
urdf/meshes/wxai/carriage_left.stl
0.0185 x 0.0917 x 0.0393
