hu-po/tatbot/urdf/meshes/wxai/camera_mount_d405.stl

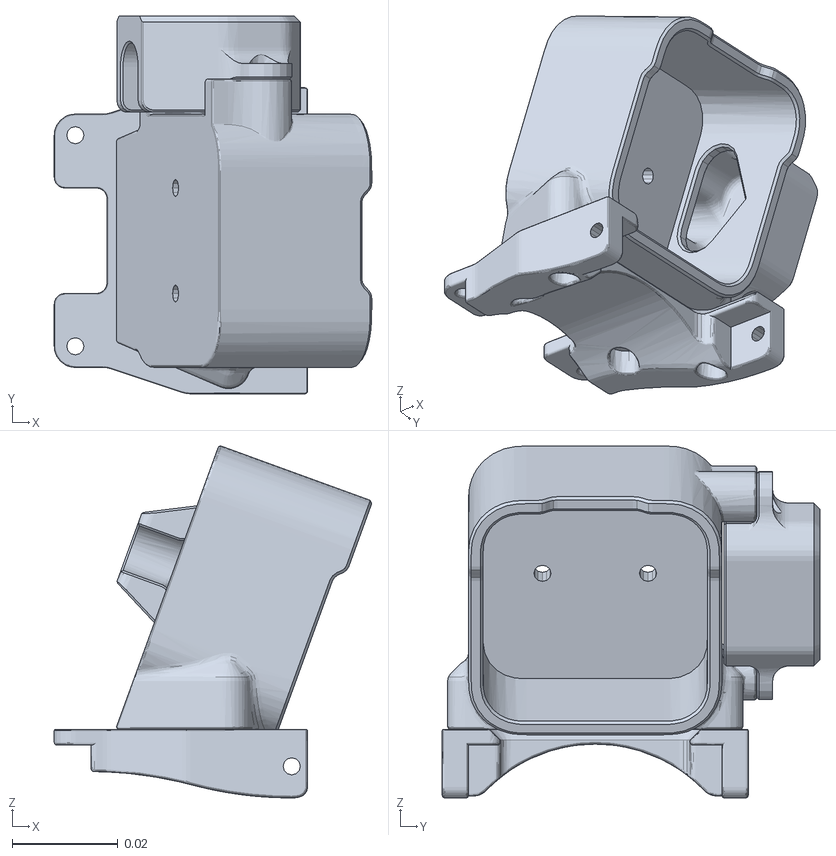
[picture p38: CAD file, 2026-09-01]
urdf/meshes/wxai/camera_mount_d405.stl
0.0602 x 0.0716 x 0.0667
