hu-po/tatbot/urdf/meshes/wxai/link_1.stl

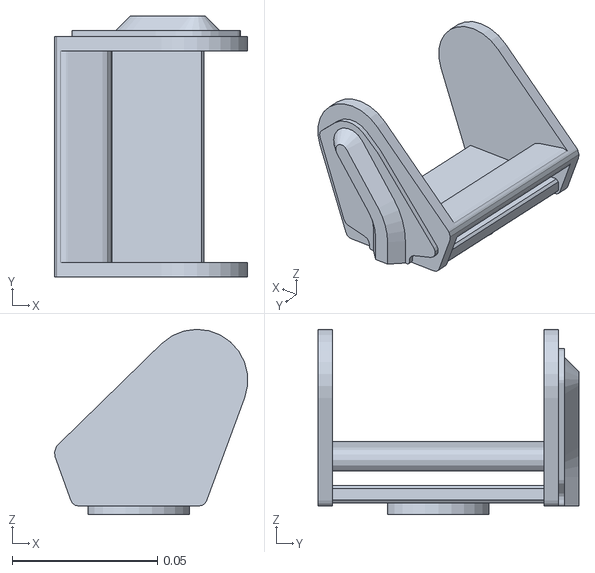
[picture p39: CAD file, 2026-09-01]
urdf/meshes/wxai/link_1.stl
0.0664 x 0.0896 x 0.0637
