hu-po/tatbot/urdf/meshes/wxai/link_4.stl

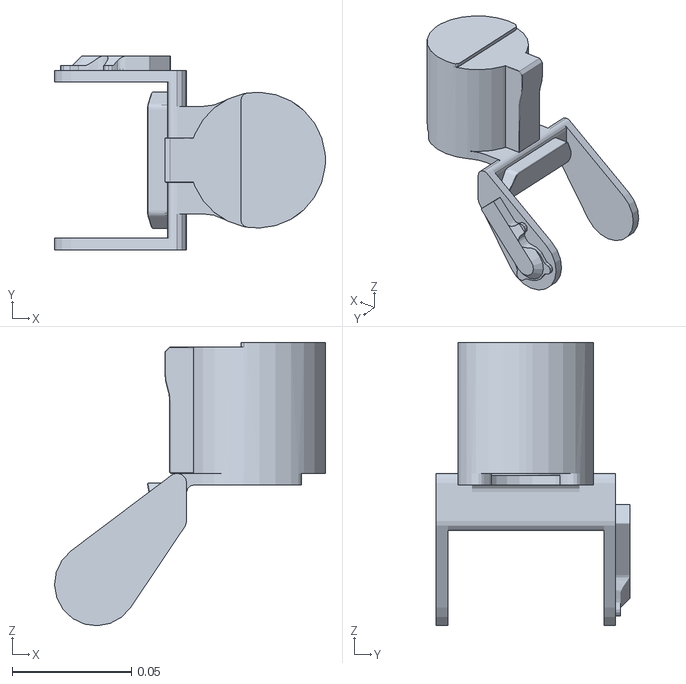
[picture p40: CAD file, 2026-09-01]
urdf/meshes/wxai/link_4.stl
0.114 x 0.0814 x 0.119
