hu-po/tatbot/urdf/meshes/wxai/link_3.stl

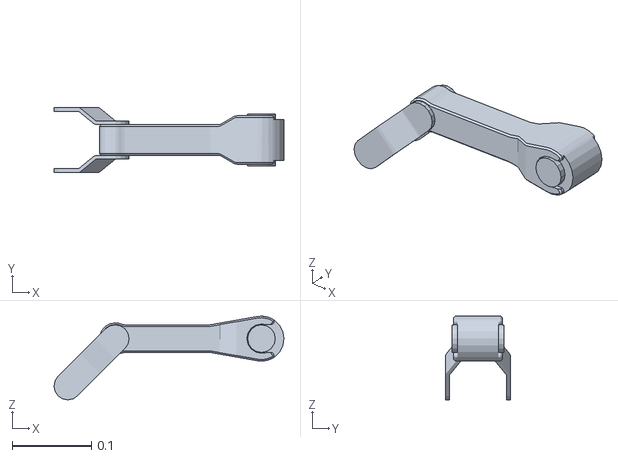
[picture p41: CAD file, 2026-09-01]
urdf/meshes/wxai/link_3.stl
0.291 x 0.0826 x 0.106
