hu-po/tatbot/urdf/meshes/wxai/base_link.stl

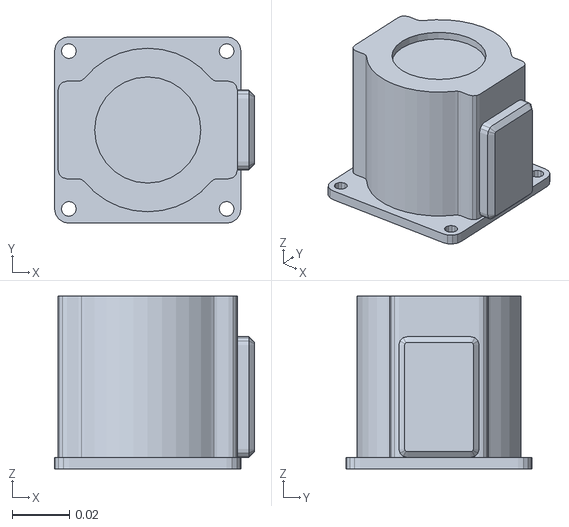
[picture p42: CAD file, 2026-09-01]
urdf/meshes/wxai/base_link.stl
0.0697 x 0.065 x 0.0602
