hu-po/tatbot/urdf/meshes/wxai/link_2.stl

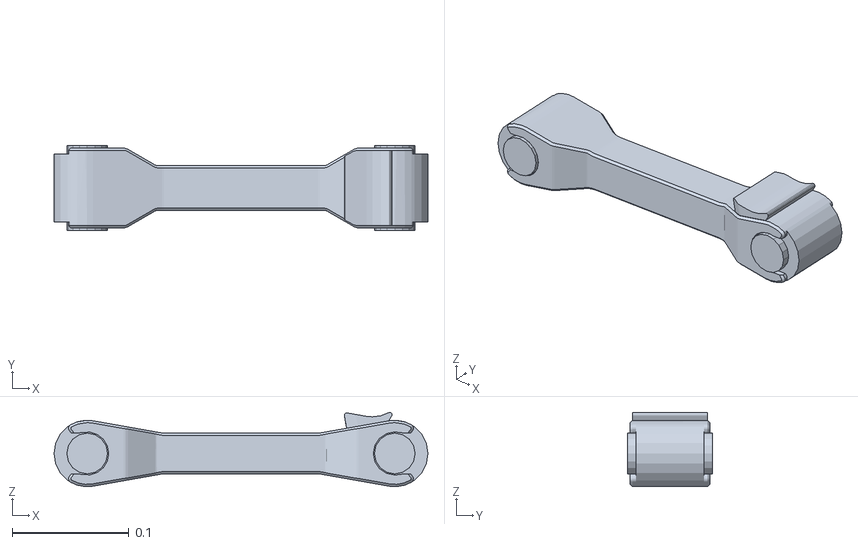
[picture p43: CAD file, 2026-09-01]
urdf/meshes/wxai/link_2.stl
0.321 x 0.0727 x 0.0638
