hu-po/tatbot/(list of files, cad)

Other CAD files:
urdf/meshes/ee/fiducial-cubes-47mm-rear/right_fiducial_cube_47mm.stl
urdf/meshes/ee/v17/03_raised_tag_carrier.stl
urdf/meshes/wxai/carriage_right.stl
urdf/meshes/ee/pen_tip.stl
