hu-po/tatbot/ros/tatbot_calib/test/data/palette-3rl-park-3942-1984.jpg

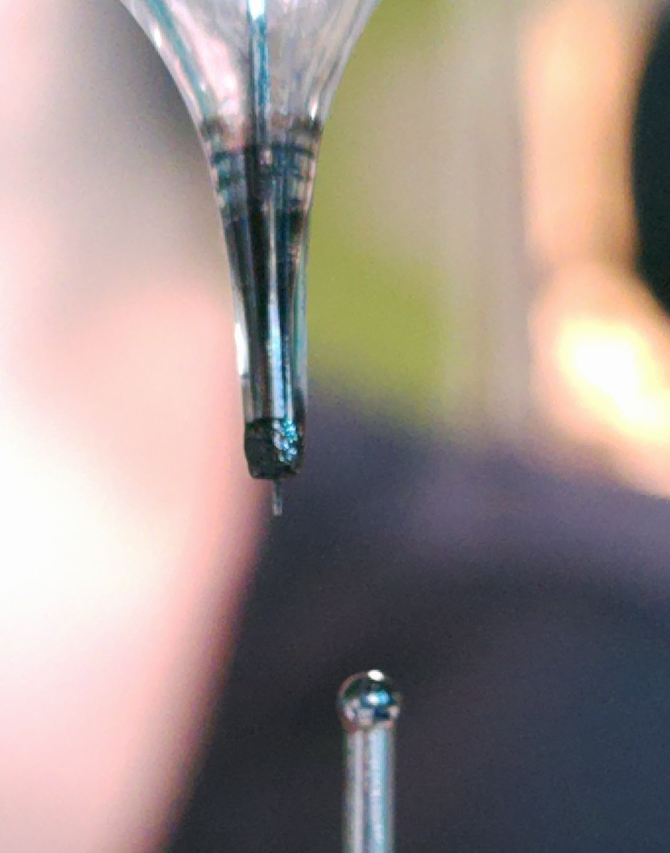
ros/tatbot_calib/test/data/palette-3rl-park-3942-1984.jpg
