hu-po/tatbot/ros/tatbot_calib/test/data/palette-darker-lifted-4000-2040.jpg

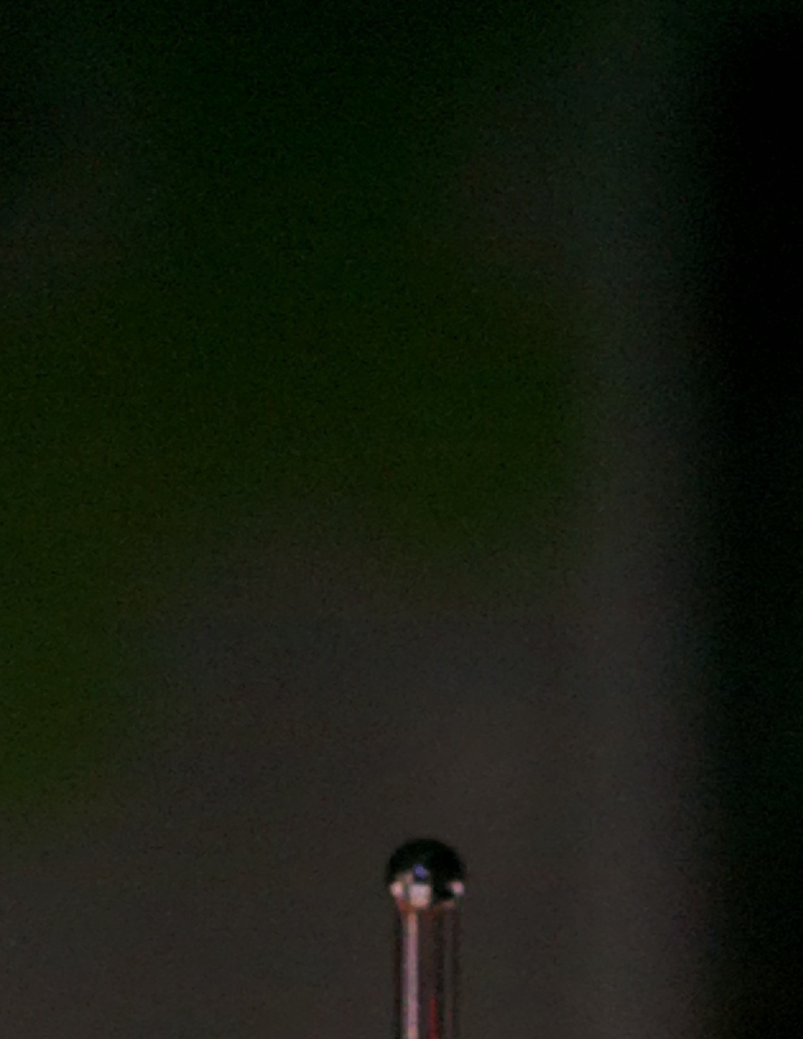
ros/tatbot_calib/test/data/palette-darker-lifted-4000-2040.jpg
