hu-po/tatbot/ros/tatbot_calib/test/data/palette-dim-lifted-3970-2020.jpg

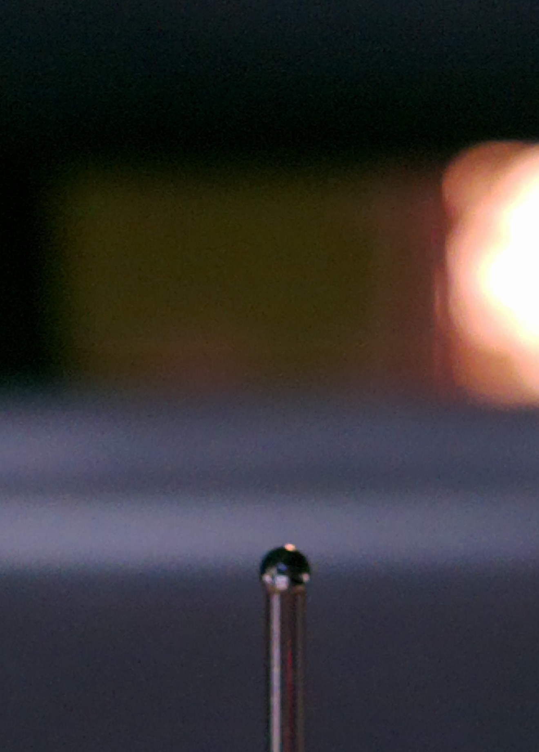
ros/tatbot_calib/test/data/palette-dim-lifted-3970-2020.jpg
