hu-po/tatbot/ros/tatbot_calib/test/data/palette-dim-park-3970-2020.jpg

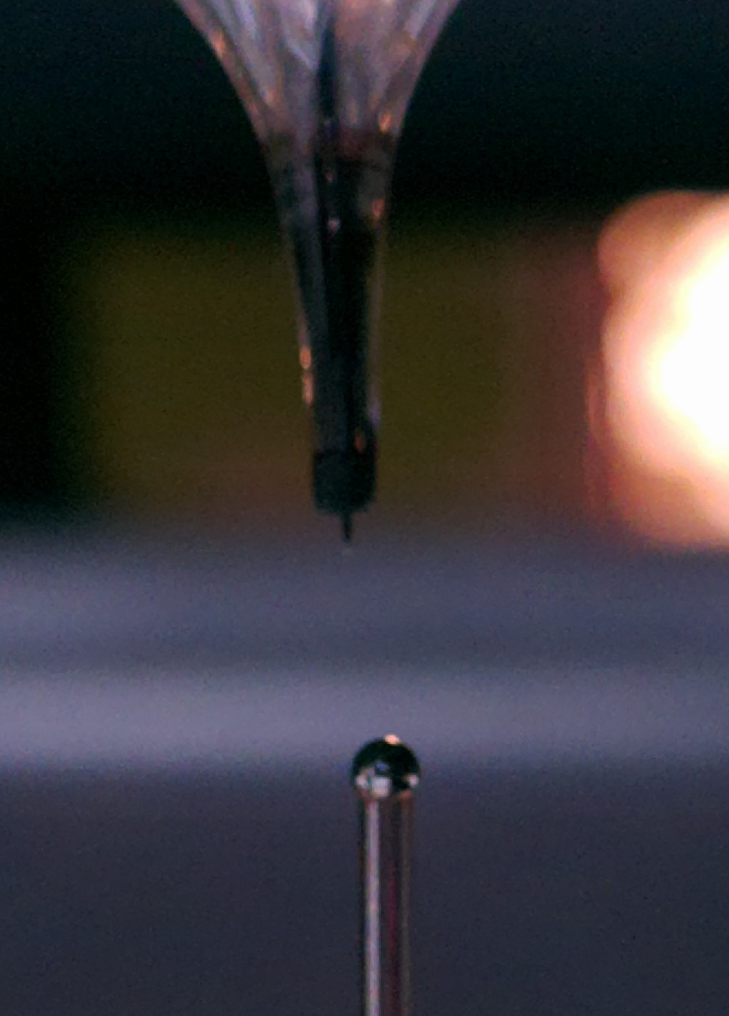
ros/tatbot_calib/test/data/palette-dim-park-3970-2020.jpg
