hu-po/tatbot/ros/tatbot_calib/test/data/palette-nopen-ball-4300-3100.jpg

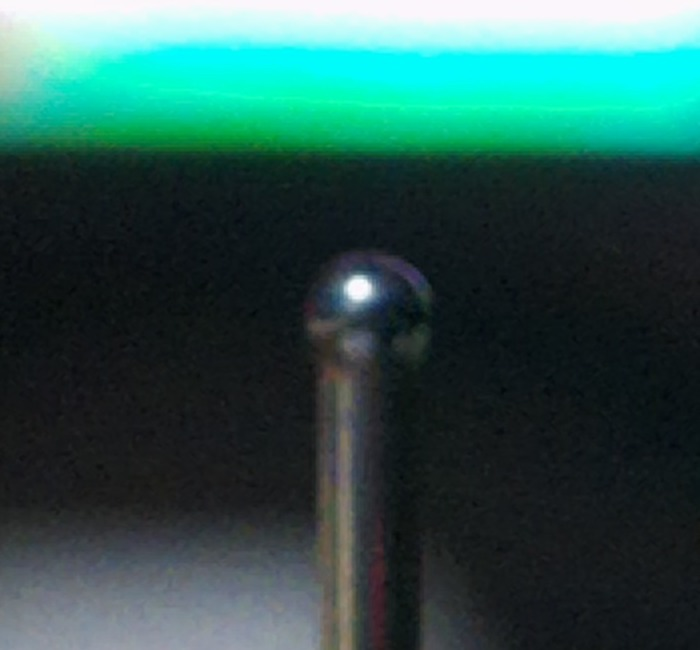
ros/tatbot_calib/test/data/palette-nopen-ball-4300-3100.jpg
