hu-po/tatbot/ros/tatbot_calib/test/data/palette-onball-lifted-4340-2940.jpg

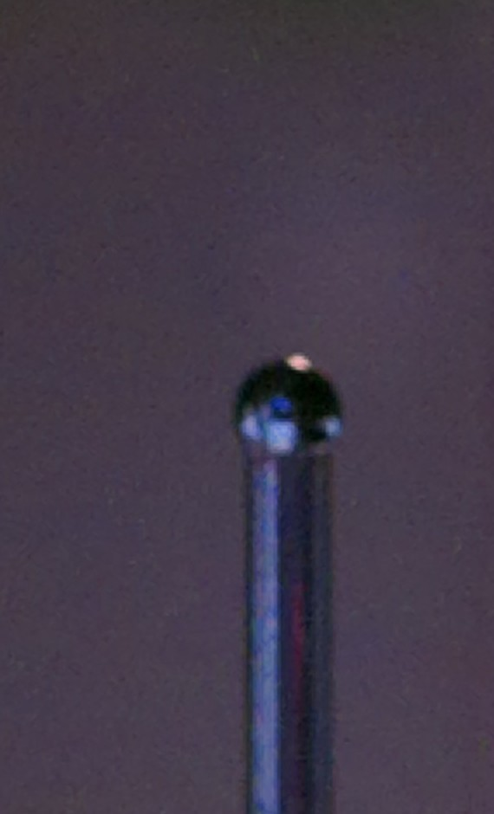
ros/tatbot_calib/test/data/palette-onball-lifted-4340-2940.jpg
