hu-po/tatbot/ros/tatbot_calib/test/data/palette-onball-park-4340-2940.jpg

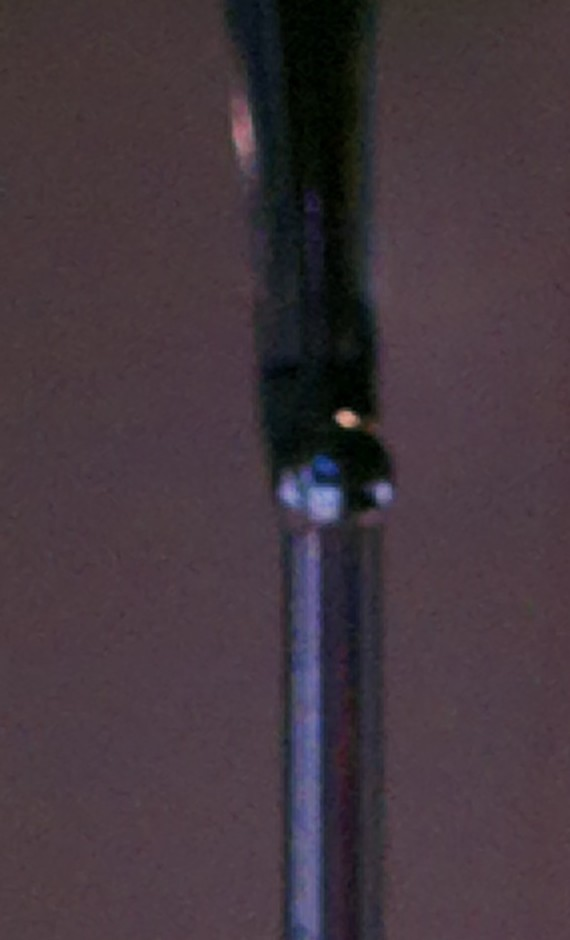
ros/tatbot_calib/test/data/palette-onball-park-4340-2940.jpg
