hu-po/tatbot/ros/tatbot_calib/test/data/palette-pen-tip-4280-1000.jpg

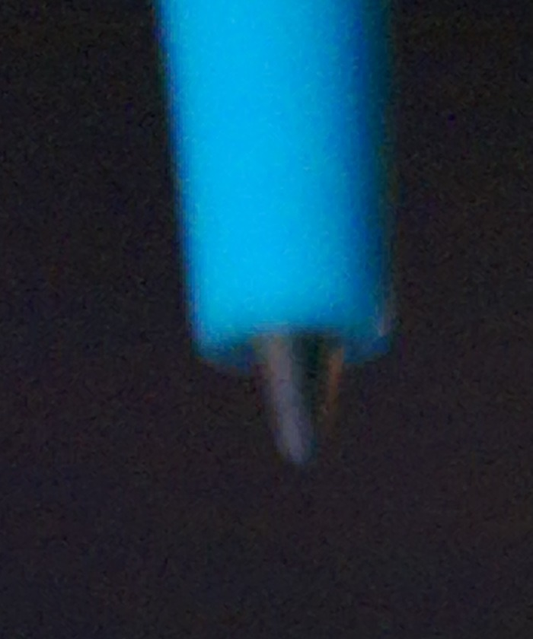
ros/tatbot_calib/test/data/palette-pen-tip-4280-1000.jpg
