hu-po/tatbot/scripts/tests/fixtures/fiducials/mixed.png

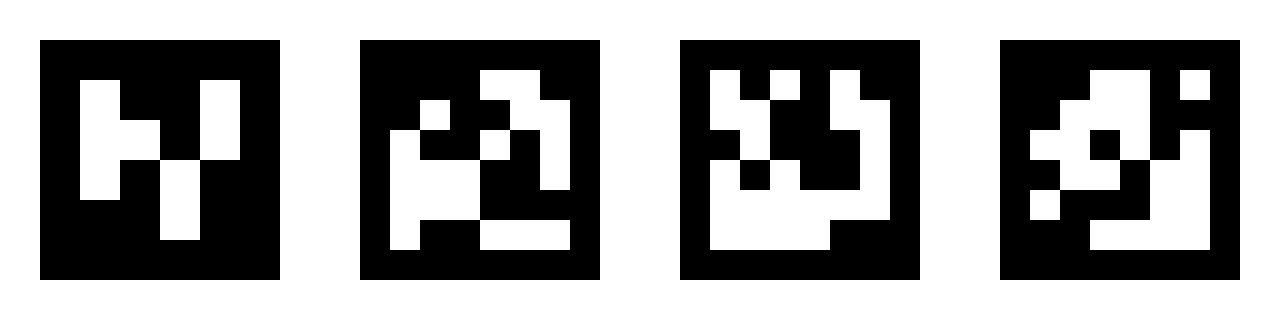
scripts/tests/fixtures/fiducials/mixed.png
