hu-po/tatbot/urdf/tatbot.urdf

<?xml version="1.0" ?>
<robot name="tatbot">
  <material name="black">
    <color rgba="0.1 0.1 0.1 1"/>
    <specular rgba="0.5 0.5 0.5 1"/>
  </material>
  <link name="root">
      <origin rpy="0 0 0" xyz="0 0 0"/>
  </link>

  <!-- Robot-centric axes: +X forward through the fixed cameras, +Y toward
       the robot's left hand, +Z up. Left/right never mean the observer's
       left/right when looking back at the robot. The aluminum frame stays
       centred on the root, midway between the two arm mounts; only the
       pink (right) arm is modelled, the left one being the teleop leader
       alone. A misidentified calibration wrist must be corrected in the
       registration, not hidden by shifting the rig. -->
  <link name="rig_center"/>
  <joint name="rig_center_joint" type="fixed">
    <origin rpy="0 0 0" xyz="0 0 0"/>
    <parent link="root"/>
    <child link="rig_center"/>
  </joint>

  <!-- Movable palette is a separate scene asset: palette.urdf. -->

  <!-- camera1 -->
  <joint name="camera1_mount_joint" type="fixed">
    <origin rpy="0 0 0" xyz="-0.074 0 0.085"/>
    <parent link="rig_center"/>
    <child link="camera1"/>
  </joint>
  <link name="camera1">
    <visual>
      <origin rpy="0 0 0" xyz="0 0 0"/>
      <geometry>
        <mesh filename="meshes/cameras/amcrest.stl" scale="0.001 0.001 0.001"/>
      </geometry>
      <material name="black"/>
    </visual>
    <collision>
      <origin rpy="0 0 0" xyz="0 0 0"/>
      <geometry>
        <mesh filename="meshes/cameras/amcrest.stl" scale="0.001 0.001 0.001"/>
      </geometry>
    </collision>
  </link>
  <joint name="camera1_frame_joint" type="fixed">
    <origin rpy="-1.5707963267948966 0 0" xyz="0 0 0.07"/>
    <parent link="camera1"/>
    <child link="camera1_frame"/>
  </joint>
  <link name="camera1_frame"/>
  <joint name="camera1_optical_joint" type="fixed">
    <origin rpy="-1.5707963267948966 1.5707963267948966 -0.7853981633974483" xyz="0 0 0"/>
    <parent link="camera1_frame"/>
    <child link="camera1_optical_frame"/>
  </joint>
  <link name="camera1_optical_frame"/>
  
  <!-- camera2 -->
  <joint name="camera2_mount_joint" type="fixed">
    <origin rpy="0 1.5707963267948966 0" xyz="-0.0275 0.27 0.6"/>
    <parent link="rig_center"/>
    <child link="camera2"/>
  </joint>
  <link name="camera2">
    <visual>
      <origin rpy="0 0 0" xyz="0 0 0"/>
      <geometry>
        <mesh filename="meshes/cameras/amcrest.stl" scale="0.001 0.001 0.001"/>
      </geometry>
      <material name="black"/>
    </visual>
    <collision>
      <origin rpy="0 0 0" xyz="0 0 0"/>
      <geometry>
        <mesh filename="meshes/cameras/amcrest.stl" scale="0.001 0.001 0.001"/>
      </geometry>
    </collision>
  </link>
  <joint name="camera2_frame_joint" type="fixed">
    <origin rpy="0 0 0" xyz="0 0 0.07"/>
    <parent link="camera2"/>
    <child link="camera2_frame"/>
  </joint>
  <link name="camera2_frame"/>
  <joint name="camera2_optical_joint" type="fixed">
    <origin rpy="-1.5707963267948966 0 -1.5707963267948966" xyz="0 0 0"/>
    <parent link="camera2_frame"/>
    <child link="camera2_optical_frame"/>
  </joint>
  <link name="camera2_optical_frame"/>
  
  <!-- camera3 -->
  <joint name="camera3_mount_joint" type="fixed">
    <origin rpy="0 1.5707963267948966 0" xyz="-0.0275 0.11 0.7"/>
    <parent link="rig_center"/>
    <child link="camera3"/>
  </joint>
  <link name="camera3">
    <visual>
      <origin rpy="0 0 0" xyz="0 0 0"/>
      <geometry>
        <mesh filename="meshes/cameras/amcrest.stl" scale="0.001 0.001 0.001"/>
      </geometry>
      <material name="black"/>
    </visual>
    <collision>
      <origin rpy="0 0 0" xyz="0 0 0"/>
      <geometry>
        <mesh filename="meshes/cameras/amcrest.stl" scale="0.001 0.001 0.001"/>
      </geometry>
    </collision>
  </link>
  <joint name="camera3_frame_joint" type="fixed">
    <origin rpy="0 0 0" xyz="0 0 0.07"/>
    <parent link="camera3"/>
    <child link="camera3_frame"/>
  </joint>
  <link name="camera3_frame"/>
  <joint name="camera3_optical_joint" type="fixed">
    <origin rpy="-1.5707963267948966 0 -1.5707963267948966" xyz="0 0 0"/>
    <parent link="camera3_frame"/>
    <child link="camera3_optical_frame"/>
  </joint>
  <link name="camera3_optical_frame"/>

  <!-- camera4 -->
  <joint name="camera4_mount_joint" type="fixed">
    <origin rpy="0 1.5707963267948966 0" xyz="-0.0275 -0.11 0.7"/>
    <parent link="rig_center"/>
    <child link="camera4"/>
  </joint>
  <link name="camera4">
    <visual>
      <origin rpy="0 0 0" xyz="0 0 0"/>
      <geometry>
        <mesh filename="meshes/cameras/amcrest.stl" scale="0.001 0.001 0.001"/>
      </geometry>
      <material name="black"/>
    </visual>
  </link>
  <joint name="camera4_frame_joint" type="fixed">
    <origin rpy="0 0 0" xyz="0 0 0.07"/>
    <parent link="camera4"/>
    <child link="camera4_frame"/>
  </joint>
  <link name="camera4_frame"/>
  <joint name="camera4_optical_joint" type="fixed">
    <origin rpy="-1.5707963267948966 0 -1.5707963267948966" xyz="0 0 0"/>
    <parent link="camera4_frame"/>
    <child link="camera4_optical_frame"/>
  </joint>
  <link name="camera4_optical_frame"/>

  <!-- camera5 -->
  <joint name="camera5_mount_joint" type="fixed">
    <origin rpy="0 1.5707963267948966 0" xyz="-0.0275 -0.27 0.6"/>
    <parent link="rig_center"/>
    <child link="camera5"/>
  </joint>
  <link name="camera5">
    <visual>
      <origin rpy="0 0 0" xyz="0 0 0"/>
      <geometry>
        <mesh filename="meshes/cameras/amcrest.stl" scale="0.001 0.001 0.001"/>
      </geometry>
      <material name="black"/>
    </visual>
  </link>
  <joint name="camera5_frame_joint" type="fixed">
    <origin rpy="0 0 0" xyz="0 0 0.07"/>
    <parent link="camera5"/>
    <child link="camera5_frame"/>
  </joint>
  <link name="camera5_frame"/>
  <joint name="camera5_optical_joint" type="fixed">
    <origin rpy="-1.5707963267948966 0 -1.5707963267948966" xyz="0 0 0"/>
    <parent link="camera5_frame"/>
    <child link="camera5_optical_frame"/>
  </joint>
  <link name="camera5_optical_frame"/>

  <!-- arm_r -->
  <joint name="right/mount_joint" type="fixed">
    <origin rpy="0 0 0" xyz="0 -0.2675 0"/>
    <parent link="root"/>
    <child link="right/base_link"/>
  </joint>
  <link name="right/base_link">
    <inertial>
      <origin rpy="0 0 0" xyz="-0.00014175 -0.00005228 0.03175177"/>
      <mass value="0.45969858"/>
      <inertia ixx="0.00041660" ixy="0.00000011" ixz="-0.00000454" iyy="0.00044896" iyz="-0.00000078" izz="0.00021403"/>
    </inertial>
    <visual>
      <origin rpy="0 0 0" xyz="0 0 0"/>
      <geometry>
        <mesh filename="meshes/wxai/base_link.stl"/>
      </geometry>
      <material name="black"/>
    </visual>
    <collision>
      <origin rpy="0 0 0" xyz="0 0 0"/>
      <geometry>
        <mesh filename="meshes/wxai/base_link.stl"/>
      </geometry>
    </collision>
  </link>
  <link name="right/link_1">
    <inertial>
      <origin rpy="0 0 0" xyz="-0.00011075 0.00171176 0.02044592"/>
      <mass value="0.15270428"/>
      <inertia ixx="0.00018509" ixy="-0.00000191" ixz="-0.00001436" iyy="0.00008358" iyz="-0.00000130" izz="0.00019219"/>
    </inertial>
    <visual>
      <origin rpy="0 0 0" xyz="0 0 0"/>
      <geometry>
        <mesh filename="meshes/wxai/link_1.stl"/>
      </geometry>
      <material name="black"/>
    </visual>
    <collision>
      <origin rpy="0 0 0" xyz="0 0 0"/>
      <geometry>
        <mesh filename="meshes/wxai/link_1.stl"/>
      </geometry>
    </collision>
  </link>
  <joint name="right/joint_0" type="revolute">
    <origin rpy="0 0 0" xyz="0 0 0.05725"/>
    <parent link="right/base_link"/>
    <child link="right/link_1"/>
    <axis xyz="0 0 1"/>
    <limit effort="27.0" lower="-3.0543261909900767" upper="3.0543261909900767" velocity="3.375"/>
  </joint>
  <link name="right/link_2">
    <inertial>
      <origin rpy="0 0 0" xyz="-0.13121451 -0.00292583 0.00021345"/>
      <mass value="1.15316319"/>
      <inertia ixx="0.00102632" ixy="-0.00000319" ixz="-0.00002679" iyy="0.01736118" iyz="-0.00000193" izz="0.01794489"/>
    </inertial>
    <visual>
      <origin rpy="0 0 0" xyz="0 0 0"/>
      <geometry>
        <mesh filename="meshes/wxai/link_2.stl"/>
      </geometry>
      <material name="black"/>
    </visual>
    <collision>
      <origin rpy="0 0 0" xyz="0 0 0"/>
      <geometry>
        <mesh filename="meshes/wxai/link_2.stl"/>
      </geometry>
    </collision>
  </link>
  <joint name="right/joint_1" type="revolute">
    <origin rpy="0 0 0" xyz="0.02 0 0.04625"/>
    <parent link="right/link_1"/>
    <child link="right/link_2"/>
    <axis xyz="0 1 0"/>
    <limit effort="27.0" lower="0.0" upper="3.141592653589793" velocity="3.375"/>
  </joint>
  <link name="right/link_3">
    <inertial>
      <origin rpy="0 0 0" xyz="0.18083602 -0.00094090 0.05554937"/>
      <mass value="0.68666638"/>
      <inertia ixx="0.00064876" ixy="0.00009128" ixz="-0.00052002" iyy="0.00547407" iyz="0.00001159" izz="0.00561509"/>
    </inertial>
    <visual>
      <origin rpy="0 0 0" xyz="0 0 0"/>
      <geometry>
        <mesh filename="meshes/wxai/link_3.stl"/>
      </geometry>
      <material name="black"/>
    </visual>
    <collision>
      <origin rpy="0 0 0" xyz="0 0 0"/>
      <geometry>
        <mesh filename="meshes/wxai/link_3.stl"/>
      </geometry>
    </collision>
  </link>
  <joint name="right/joint_2" type="revolute">
    <origin rpy="0 0 0" xyz="-0.264 0 0"/>
    <parent link="right/link_2"/>
    <child link="right/link_3"/>
    <axis xyz="0 -1 0"/>
    <limit effort="27.0" lower="0.0" upper="2.356194490192345" velocity="3.375"/>
  </joint>
  <link name="right/link_4">
    <inertial>
      <origin rpy="0 0 0" xyz="0.05797842 0.00027145 0.05884447"/>
      <mass value="0.45789905"/>
      <inertia ixx="0.00053839" ixy="0.00000690" ixz="-0.00018164" iyy="0.00066138" iyz="0.00000724" izz="0.00042116"/>
    </inertial>
    <visual>
      <origin rpy="0 0 0" xyz="0 0 0"/>
      <geometry>
        <mesh filename="meshes/wxai/link_4.stl"/>
      </geometry>
      <material name="black"/>
    </visual>
    <collision>
      <origin rpy="0 0 0" xyz="0 0 0"/>
      <geometry>
        <mesh filename="meshes/wxai/link_4.stl"/>
      </geometry>
    </collision>
  </link>
  <joint name="right/joint_3" type="revolute">
    <origin rpy="0 0 0" xyz="0.245 0 0.06"/>
    <parent link="right/link_3"/>
    <child link="right/link_4"/>
    <axis xyz="0 -1 0"/>
    <limit effort="7.0" lower="-1.5707963267948966" upper="1.5707963267948966" velocity="7.0"/>
  </joint>
  <link name="right/link_5">
    <inertial>
      <origin rpy="0 0 0" xyz="0.00412447 -0.00001138 -0.04283184"/>
      <mass value="0.36693910"/>
      <inertia ixx="0.00018912" ixy="-0.00000045" ixz="0.00000090" iyy="0.00032062" iyz="0.00000003" izz="0.00026750"/>
    </inertial>
    <visual>
      <origin rpy="0 0 0" xyz="0 0 0"/>
      <geometry>
        <mesh filename="meshes/wxai/link_5.stl"/>
      </geometry>
      <material name="black"/>
    </visual>
    <collision>
      <origin rpy="0 0 0" xyz="0 0 0"/>
      <geometry>
        <mesh filename="meshes/wxai/link_5.stl"/>
      </geometry>
    </collision>
  </link>
  <joint name="right/joint_4" type="revolute">
    <origin rpy="0 0 0" xyz="0.06775 0 0.0455"/>
    <parent link="right/link_4"/>
    <child link="right/link_5"/>
    <axis xyz="0 0 -1"/>
    <limit effort="7.0" lower="-1.5707963267948966" upper="1.5707963267948966" velocity="7.0"/>
  </joint>
  <link name="right/link_6">
    <inertial>
      <origin rpy="0 0 0" xyz="0.04572768 -0.00000726 0.00001402"/>
      <mass value="0.55469347"/>
      <inertia ixx="0.00082429" ixy="-0.00000051" ixz="0.00000010" iyy="0.00048759" iyz="0.00000004" izz="0.00108600"/>
    </inertial>
    <visual>
      <origin rpy="0 0 0" xyz="0 0 0"/>
      <geometry>
        <mesh filename="meshes/wxai/link_6.stl"/>
      </geometry>
      <material name="black"/>
    </visual>
    <collision>
      <origin rpy="0 0 0" xyz="0 0 0"/>
      <geometry>
        <mesh filename="meshes/wxai/link_6.stl"/>
      </geometry>
    </collision>
  </link>
  <joint name="right/joint_5" type="revolute">
    <origin rpy="0 0 0" xyz="0.02895 0 -0.0455"/>
    <parent link="right/link_5"/>
    <child link="right/link_6"/>
    <axis xyz="1 0 0"/>
    <limit effort="7.0" lower="-3.141592653589793" upper="3.141592653589793" velocity="7.0"/>
  </joint>

  <!-- right realsense -->
  <link name="right/realsense_mount_d405">
    <inertial>
      <origin rpy="0 0 0" xyz="0.03023383 0.00679835 0.05006687"/>
      <mass value="0.04518012"/>
      <inertia ixx="0.00003426" ixy="-0.00000027" ixz="-0.00000309" iyy="0.00001980" iyz="-0.00000319" izz="0.00002470"/>
    </inertial>
    <visual>
      <origin rpy="0 0 0" xyz="0 0 0"/>
      <geometry>
        <mesh filename="meshes/wxai/camera_mount_d405.stl"/>
      </geometry>
      <material name="black"/>
    </visual>
    <collision>
      <origin rpy="0 0 0" xyz="0 0 0"/>
      <geometry>
        <mesh filename="meshes/wxai/camera_mount_d405.stl"/>
      </geometry>
    </collision>
  </link>
  <joint name="right/realsense_mount_joint" type="fixed">
    <origin rpy="0 0 0" xyz="0.012 0 0"/>
    <parent link="right/link_6"/>
    <child link="right/realsense_mount_d405"/>
  </joint>
  <joint name="right/realsense_joint" type="fixed">
    <origin rpy="0 0.3490658503988659 0" xyz="0.02927207801 0 0.03824951197"/>
    <parent link="right/realsense_mount_d405"/>
    <child link="right/realsense_bottom_screw_frame"/>
  </joint>
  <link name="right/realsense_bottom_screw_frame"/>
  <joint name="right/realsense_link_joint" type="fixed">
    <origin rpy="0 0 0" xyz="0.01085 0.009 0.021"/>
    <parent link="right/realsense_bottom_screw_frame"/>
    <child link="right/realsense_link"/>
  </joint>
  <link name="right/realsense_link">
    <visual>
      <origin rpy="1.5707963267948966 0 1.5707963267948966" xyz="0.0038 -0.009 0"/>
      <geometry>
        <mesh filename="meshes/cameras/d405.stl" scale="0.001 0.001 0.001"/>
      </geometry>
      <material name="black"/>
    </visual>
    <collision>
      <origin rpy="0 0 0" xyz="-0.0078 -0.009 0"/>
      <geometry>
        <box size="0.023 0.042 0.042"/>
      </geometry>
    </collision>
    <inertial>
      <mass value="0.072"/>
      <origin xyz="0 0 0"/>
      <inertia ixx="0.00002117" ixy="0.0" ixz="0.0" iyy="0.000013758" iyz="0.0" izz="0.000013758"/>
    </inertial>
  </link>

  <!-- BEGIN GENERATED WRIST FIDUCIALS layout_sha256=3e5df17ddc64364642285bf62333b73a44b94214c3a30ab9352d974b0fae86c0 -->
  <!-- status=calibrated; generated by scripts/vision/export_wrist_tags.py -->
  <link name="right/wrist_tag2">
    <visual>
      <origin rpy="0 0 0" xyz="0 0 0.0002"/>
      <geometry><mesh filename="meshes/tags/36h11_002_47mm/tag.glb"/></geometry>
      <material name="fiducial_2"><color rgba="1 1 1 1"/></material>
    </visual>
  </link>
  <joint name="right/wrist_tag2_joint" type="fixed">
    <origin rpy="-1.16134632 1.56314399 0.39138579" xyz="0.06511021 0.17725353 0.00279946"/>
    <parent link="right/gripper_left"/>
    <child link="right/wrist_tag2"/>
  </joint>
  <link name="right/wrist_tag3">
    <visual>
      <origin rpy="0 0 0" xyz="0 0 0.0002"/>
      <geometry><mesh filename="meshes/tags/36h11_003_47mm/tag.glb"/></geometry>
      <material name="fiducial_3"><color rgba="1 1 1 1"/></material>
    </visual>
  </link>
  <joint name="right/wrist_tag3_joint" type="fixed">
    <origin rpy="-1.56601669 -0.00691598 1.56466469" xyz="0.03006740 0.14215985 0.00518638"/>
    <parent link="right/gripper_left"/>
    <child link="right/wrist_tag3"/>
  </joint>
  <link name="right/wrist_tag4">
    <visual>
      <origin rpy="0 0 0" xyz="0 0 0.0002"/>
      <geometry><mesh filename="meshes/tags/36h11_004_47mm/tag.glb"/></geometry>
      <material name="fiducial_4"><color rgba="1 1 1 1"/></material>
    </visual>
  </link>
  <joint name="right/wrist_tag4_joint" type="fixed">
    <origin rpy="3.13393546 0.01172946 1.56286620" xyz="0.06852751 0.14303955 -0.02861336"/>
    <parent link="right/gripper_left"/>
    <child link="right/wrist_tag4"/>
  </joint>
  <!-- END GENERATED WRIST FIDUCIALS -->
  <joint name="right/realsense_depth_joint" type="fixed">
    <origin rpy="0 0 0" xyz="0 0 0"/>
    <parent link="right/realsense_link"/>
    <child link="right/realsense_depth_frame"/>
  </joint>
  <link name="right/realsense_depth_frame"/>
  <joint name="right/realsense_depth_optical_joint" type="fixed">
    <origin rpy="-1.5707963267948966 0 -1.5707963267948966" xyz="0 0 0"/>
    <parent link="right/realsense_depth_frame"/>
    <child link="right/realsense_depth_optical_frame"/>
  </joint>
  <link name="right/realsense_depth_optical_frame"/>
  <joint name="right/realsense_infra1_joint" type="fixed">
    <origin rpy="0 0 0" xyz="0 0.0 0"/>
    <parent link="right/realsense_link"/>
    <child link="right/realsense_infra1_frame"/>
  </joint>
  <link name="right/realsense_infra1_frame"/>
  <joint name="right/realsense_infra1_optical_joint" type="fixed">
    <origin rpy="-1.5707963267948966 0 -1.5707963267948966" xyz="0 0 0"/>
    <parent link="right/realsense_infra1_frame"/>
    <child link="right/realsense_infra1_optical_frame"/>
  </joint>
  <link name="right/realsense_infra1_optical_frame"/>
  <joint name="right/realsense_infra2_joint" type="fixed">
    <origin rpy="0 0 0" xyz="0 -0.018 0"/>
    <parent link="right/realsense_link"/>
    <child link="right/realsense_infra2_frame"/>
  </joint>
  <link name="right/realsense_infra2_frame"/>
  <joint name="right/realsense_infra2_optical_joint" type="fixed">
    <origin rpy="-1.5707963267948966 0 -1.5707963267948966" xyz="0 0 0"/>
    <parent link="right/realsense_infra2_frame"/>
    <child link="right/realsense_infra2_optical_frame"/>
  </joint>
  <link name="right/realsense_infra2_optical_frame"/>
  <joint name="right/realsense_color_joint" type="fixed">
    <origin rpy="0 0 0" xyz="0 0.0 0"/>
    <parent link="right/realsense_link"/>
    <child link="right/realsense_color_frame"/>
  </joint>
  <link name="right/realsense_color_frame"/>
  <joint name="right/realsense_color_optical_joint" type="fixed">
    <origin rpy="-1.5707963267948966 0 -1.5707963267948966" xyz="0 0 0"/>
    <parent link="right/realsense_color_frame"/>
    <child link="right/realsense_color_optical_frame"/>
  </joint>
  <link name="right/realsense_color_optical_frame"/>

  <!-- right lower realsense: a second D405 on its own stock Trossen mount, the
       chain above rolled 180 degrees about link_6's x axis (owner, 2026-10-23):
       under the wrist, looking along link_6's x axis from below as the upper
       one does from above. Its mount joint is measured, not CAD: the pose to
       the upper camera from both cameras' reads of one print at 80 stops of
       two runs (internal/evidence/wrist_pair.py), which agreed to 0.2 deg and
       0.8 mm; 1.76 deg and 1.96 mm off the stock bracket rolled pi. The rest
       of the chain is the stock one. -->
  <link name="right/realsense_lower_mount_d405">
    <inertial>
      <origin rpy="0 0 0" xyz="0.03023383 0.00679835 0.05006687"/>
      <mass value="0.04518012"/>
      <inertia ixx="0.00003426" ixy="-0.00000027" ixz="-0.00000309" iyy="0.00001980" iyz="-0.00000319" izz="0.00002470"/>
    </inertial>
    <visual>
      <origin rpy="0 0 0" xyz="0 0 0"/>
      <geometry>
        <mesh filename="meshes/wxai/camera_mount_d405.stl"/>
      </geometry>
      <material name="black"/>
    </visual>
    <collision>
      <origin rpy="0 0 0" xyz="0 0 0"/>
      <geometry>
        <mesh filename="meshes/wxai/camera_mount_d405.stl"/>
      </geometry>
    </collision>
  </link>
  <joint name="right/realsense_lower_mount_joint" type="fixed">
    <origin rpy="-3.12656 0.02674 -0.00122" xyz="0.01287 0.00091 0.0015"/>
    <parent link="right/link_6"/>
    <child link="right/realsense_lower_mount_d405"/>
  </joint>
  <joint name="right/realsense_lower_joint" type="fixed">
    <origin rpy="0 0.3490658503988659 0" xyz="0.02927207801 0 0.03824951197"/>
    <parent link="right/realsense_lower_mount_d405"/>
    <child link="right/realsense_lower_bottom_screw_frame"/>
  </joint>
  <link name="right/realsense_lower_bottom_screw_frame"/>
  <joint name="right/realsense_lower_link_joint" type="fixed">
    <origin rpy="0 0 0" xyz="0.01085 0.009 0.021"/>
    <parent link="right/realsense_lower_bottom_screw_frame"/>
    <child link="right/realsense_lower_link"/>
  </joint>
  <link name="right/realsense_lower_link">
    <visual>
      <origin rpy="1.5707963267948966 0 1.5707963267948966" xyz="0.0038 -0.009 0"/>
      <geometry>
        <mesh filename="meshes/cameras/d405.stl" scale="0.001 0.001 0.001"/>
      </geometry>
      <material name="black"/>
    </visual>
    <collision>
      <origin rpy="0 0 0" xyz="-0.0078 -0.009 0"/>
      <geometry>
        <box size="0.023 0.042 0.042"/>
      </geometry>
    </collision>
    <inertial>
      <mass value="0.072"/>
      <origin xyz="0 0 0"/>
      <inertia ixx="0.00002117" ixy="0.0" ixz="0.0" iyy="0.000013758" iyz="0.0" izz="0.000013758"/>
    </inertial>
  </link>
  <joint name="right/realsense_lower_depth_joint" type="fixed">
    <origin rpy="0 0 0" xyz="0 0 0"/>
    <parent link="right/realsense_lower_link"/>
    <child link="right/realsense_lower_depth_frame"/>
  </joint>
  <link name="right/realsense_lower_depth_frame"/>
  <joint name="right/realsense_lower_depth_optical_joint" type="fixed">
    <origin rpy="-1.5707963267948966 0 -1.5707963267948966" xyz="0 0 0"/>
    <parent link="right/realsense_lower_depth_frame"/>
    <child link="right/realsense_lower_depth_optical_frame"/>
  </joint>
  <link name="right/realsense_lower_depth_optical_frame"/>
  <joint name="right/realsense_lower_infra1_joint" type="fixed">
    <origin rpy="0 0 0" xyz="0 0.0 0"/>
    <parent link="right/realsense_lower_link"/>
    <child link="right/realsense_lower_infra1_frame"/>
  </joint>
  <link name="right/realsense_lower_infra1_frame"/>
  <joint name="right/realsense_lower_infra1_optical_joint" type="fixed">
    <origin rpy="-1.5707963267948966 0 -1.5707963267948966" xyz="0 0 0"/>
    <parent link="right/realsense_lower_infra1_frame"/>
    <child link="right/realsense_lower_infra1_optical_frame"/>
  </joint>
  <link name="right/realsense_lower_infra1_optical_frame"/>
  <joint name="right/realsense_lower_infra2_joint" type="fixed">
    <origin rpy="0 0 0" xyz="0 -0.018 0"/>
    <parent link="right/realsense_lower_link"/>
    <child link="right/realsense_lower_infra2_frame"/>
  </joint>
  <link name="right/realsense_lower_infra2_frame"/>
  <joint name="right/realsense_lower_infra2_optical_joint" type="fixed">
    <origin rpy="-1.5707963267948966 0 -1.5707963267948966" xyz="0 0 0"/>
    <parent link="right/realsense_lower_infra2_frame"/>
    <child link="right/realsense_lower_infra2_optical_frame"/>
  </joint>
  <link name="right/realsense_lower_infra2_optical_frame"/>
  <joint name="right/realsense_lower_color_joint" type="fixed">
    <origin rpy="0 0 0" xyz="0 0.0 0"/>
    <parent link="right/realsense_lower_link"/>
    <child link="right/realsense_lower_color_frame"/>
  </joint>
  <link name="right/realsense_lower_color_frame"/>
  <joint name="right/realsense_lower_color_optical_joint" type="fixed">
    <origin rpy="-1.5707963267948966 0 -1.5707963267948966" xyz="0 0 0"/>
    <parent link="right/realsense_lower_color_frame"/>
    <child link="right/realsense_lower_color_optical_frame"/>
  </joint>
  <link name="right/realsense_lower_color_optical_frame"/>

  <!-- right arm carriage -->
  <link name="right/carriage_left">
    <inertial>
      <origin rpy="0 0 0" xyz="-0.00889602 -0.00403515 -0.00457908"/>
      <mass value="0.05036313"/>
      <inertia ixx="0.00001736" ixy="-0.00000165" ixz="-0.00000104" iyy="0.00000591" iyz="-0.00000172" izz="0.00001378"/>
    </inertial>
    <visual>
      <origin rpy="0 0 0" xyz="0 0 0"/>
      <geometry>
        <mesh filename="meshes/wxai/carriage_left.stl"/>
      </geometry>
      <material name="black"/>
    </visual>
    <collision>
      <origin rpy="0 0 0" xyz="0 0 0"/>
      <geometry>
        <mesh filename="meshes/wxai/carriage_left.stl"/>
      </geometry>
    </collision>
  </link>
  <joint name="right/left_carriage_joint" type="prismatic">
    <origin rpy="0 0 0" xyz="0.0865 0.023 0"/>
    <parent link="right/link_6"/>
    <child link="right/carriage_left"/>
    <axis xyz="0 1 0"/>
    <limit effort="400.0" lower="0.0" upper="0.044" velocity="0.0875"/>
  </joint>
  <!-- right/gripper_left is a FRAME only since 2026-08-30: both fingertips are
       physically removed. It is kept because the wrist fiducials and the EE
       mount chain are parented to it (its origin is the carriage's 2x3 M3
       pattern centre; +x the pattern's normal). No geometry. -->
  <link name="right/gripper_left"/>
  <joint name="right/left_gripper_joint" type="fixed">
    <origin rpy="0 0 0" xyz="0 0 0"/>
    <parent link="right/carriage_left"/>
    <child link="right/gripper_left"/>
  </joint>
  <!-- Installed V17, 2026-09-07. Assembly meshes are in carriage coordinates,
       millimetres; identity placement in right/gripper_left. The compact rear-facing
       carrier replaces the V17 carrier; its datums are nominal.
       See meshes/ee/fiducial-cubes-47mm-rear/provenance.json. -->
  <link name="right/ee_mount">
    <visual>
      <origin rpy="0 0 0" xyz="0 0 0"/>
      <geometry><mesh filename="meshes/ee/v17/01_cradle_and_brace.stl" scale="0.001 0.001 0.001"/></geometry>
      <material name="v17_01_cradle_and_brace"><color rgba="0.12 0.12 0.13 1"/></material>
    </visual>
    <visual>
      <origin rpy="0 0 0" xyz="0 0 0"/>
      <geometry><mesh filename="meshes/ee/v17/02_clamp_cap.stl" scale="0.001 0.001 0.001"/></geometry>
      <material name="v17_02_clamp_cap"><color rgba="0.12 0.12 0.13 1"/></material>
    </visual>
    <visual>
      <origin rpy="0 0 0" xyz="0 0 0"/>
      <geometry><mesh filename="meshes/ee/fiducial-cubes-47mm-rear/right_fiducial_cube_47mm.stl" scale="0.001 0.001 0.001"/></geometry>
      <material name="v17_03_raised_tag_carrier"><color rgba="0.12 0.12 0.13 1"/></material>
    </visual>
  </link>
  <joint name="right/ee_mount_joint" type="fixed">
    <origin rpy="0 0 0" xyz="0 0 0"/>
    <parent link="right/gripper_left"/>
    <child link="right/ee_mount"/>
  </joint>
  <!-- V17 tool_mount: first clamp bore band at CAD station 73 mm from nominal tip.
       +z toward tip, +x carriage +z. Nominal CAD datum; fresh touch-off required. -->
  <link name="right/tool_mount"/>
  <joint name="right/tool_mount_joint" type="fixed">
    <origin rpy="2.356194490192345 -1.570796326794897 0" xyz="0.0639202049734 0.0400977950266 -0.000564"/>
    <parent link="right/gripper_left"/>
    <child link="right/tool_mount"/>
  </joint>
  <joint name="right/ee_gripper" type="fixed">
    <origin rpy="0 0 0" xyz="0.156062 0 0"/>
    <parent link="right/link_6"/>
    <child link="right/ee_gripper_link"/>
  </joint>
  <link name="right/ee_gripper_link"/>

  <!-- horizontal aluminum framing -->
  <link name="600mm_front_horizontal">
    <visual>
      <origin rpy="1.57079632679 0 0" xyz="0 0 0"/>
      <geometry>
        <mesh filename="meshes/frame/t2020_600mm.stl" scale="0.001 0.001 0.001"/>
      </geometry>
      <material name="black"/>
    </visual>
  </link>
  <joint name="600mm_front_horizontal_joint" type="fixed">
    <origin rpy="0 0 0" xyz="0.0275 0 -0.01"/>
    <parent link="rig_center"/>
    <child link="600mm_front_horizontal"/>
  </joint>
  <link name="600mm_back_horizontal">
    <visual>
      <origin rpy="1.57079632679 0 0" xyz="0 0 0"/>
      <geometry>
        <mesh filename="meshes/frame/t2020_600mm.stl" scale="0.001 0.001 0.001"/>
      </geometry>
      <material name="black"/>
    </visual>
  </link>
  <joint name="600mm_back_horizontal_joint" type="fixed">
    <origin rpy="0 0 0" xyz="-0.0275 0 -0.01"/>
    <parent link="rig_center"/>
    <child link="600mm_back_horizontal"/>
  </joint>

  <!-- vertical aluminum framing -->
  <link name="600mm_vertical_left">
    <visual>
      <origin rpy="0 0 0" xyz="0 0 0"/>
      <geometry>
        <mesh filename="meshes/frame/t2020_600mm.stl" scale="0.001 0.001 0.001"/>
      </geometry>
      <material name="black"/>
    </visual>
  </link>
  <joint name="600mm_vertical_left_joint" type="fixed">
    <origin rpy="0 0 0" xyz="-0.0275 0.1 0.30"/>
    <parent link="rig_center"/>
    <child link="600mm_vertical_left"/>
  </joint>
  <link name="600mm_vertical_right">
    <visual>
      <origin rpy="0 0 0" xyz="0 0 0"/>
      <geometry>
        <mesh filename="meshes/frame/t2020_600mm.stl" scale="0.001 0.001 0.001"/>
      </geometry>
      <material name="black"/>
    </visual>
  </link>
  <joint name="600mm_vertical_right_joint" type="fixed">
    <origin rpy="0 0 0" xyz="-0.0275 -0.1 0.30"/>
    <parent link="rig_center"/>
    <child link="600mm_vertical_right"/>
  </joint>
  <link name="600mm_vertical_top">
    <visual>
      <origin rpy="1.57079632679 0 0" xyz="0 0 0"/>
      <geometry>
        <mesh filename="meshes/frame/t2020_600mm.stl" scale="0.001 0.001 0.001"/>
      </geometry>
      <material name="black"/>
    </visual>
  </link>
  <joint name="600mm_vertical_top_joint" type="fixed">
    <origin rpy="0 0 0" xyz="-0.0275 0 0.61"/>
    <parent link="rig_center"/>
    <child link="600mm_vertical_top"/>
  </joint>

  <!-- front rails -->
  <link name="300mm_front_rail_left">
    <visual>
      <origin rpy="1.57079632679 0 1.57079632679" xyz="0 0 0"/>
      <geometry>
        <mesh filename="meshes/frame/t2020_300mm.stl" scale="0.001 0.001 0.001"/>
      </geometry>
      <material name="black"/>
    </visual>
  </link>
  <joint name="300mm_front_rail_left_joint" type="fixed">
    <origin rpy="0 0 0" xyz="0.08 0.1 -0.01"/>
    <parent link="rig_center"/>
    <child link="300mm_front_rail_left"/>
  </joint>
  <link name="300mm_front_rail_right">
    <visual>
      <origin rpy="1.57079632679 0 1.57079632679" xyz="0 0 0"/>
      <geometry>
        <mesh filename="meshes/frame/t2020_300mm.stl" scale="0.001 0.001 0.001"/>
      </geometry>
      <material name="black"/>
    </visual>
  </link>
  <joint name="300mm_front_rail_right_joint" type="fixed">
    <origin rpy="0 0 0" xyz="0.08 -0.1 -0.01"/>
    <parent link="rig_center"/>
    <child link="300mm_front_rail_right"/>
  </joint>

  <!-- BEGIN generated tool block — scripts/gen_tool_urdf.py, do not edit -->
  <!-- Ambition Lutin + HAWINK 3RL bugpin X-taper (lutin-3rl-bugpin), datasheet config/tools/lutin-3rl-bugpin.yaml sha256 ff241c2eeaf4.
       Body profile and TCP resolve from the same measured touch-off,
       62.24 mm out along an axis 2.5 deg
       off the mount's nominal +z (datasheet nominal 73 mm;
       source touch-axis-inferred; visual/TCP error 0.000 mm).
       Regenerate with scripts/gen_tool_urdf.py. -->
  <link name="right/tattoo_pen">
    <visual>
      <origin rpy="0 0 0" xyz="0 0 -0.0185"/>
      <geometry>
        <cylinder length="0.047" radius="0.0165"/>
      </geometry>
    </visual>
    <visual>
      <origin rpy="0 0 0" xyz="0 0 0.00525"/>
      <geometry>
        <cylinder length="0.0005" radius="0.016484375"/>
      </geometry>
    </visual>
    <visual>
      <origin rpy="0 0 0" xyz="0 0 0.00575"/>
      <geometry>
        <cylinder length="0.0005" radius="0.016453125"/>
      </geometry>
    </visual>
    <visual>
      <origin rpy="0 0 0" xyz="0 0 0.00625"/>
      <geometry>
        <cylinder length="0.0005" radius="0.016421875"/>
      </geometry>
    </visual>
    <visual>
      <origin rpy="0 0 0" xyz="0 0 0.00675"/>
      <geometry>
        <cylinder length="0.0005" radius="0.016390625"/>
      </geometry>
    </visual>
    <visual>
      <origin rpy="0 0 0" xyz="0 0 0.00725"/>
      <geometry>
        <cylinder length="0.0005" radius="0.016359375"/>
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
    <origin rpy="0 0.0431755603 1.53989369" xyz="-1.43536644e-05 -0.000464332396 -0.0107529699"/>
    <parent link="right/tool_mount"/>
    <child link="right/tattoo_pen"/>
  </joint>
  <link name="right/tattoo_needle">
    <collision>
      <origin rpy="0 0 0" xyz="0 0 -0.0005"/>
      <geometry>
        <sphere radius="0.0005"/>
      </geometry>
    </collision>
  </link>
  <joint name="right/tattoo_needle_joint" type="fixed">
    <origin rpy="0 0 0" xyz="0 0 0.073"/>
    <parent link="right/tattoo_pen"/>
    <child link="right/tattoo_needle"/>
  </joint>
  <!-- END generated tool block -->

</robot>
