hu-po/tatbot/cpp/teleop/teleop_mapping.hpp

#pragma once

#include <algorithm>
#include <cmath>
#include <cstddef>
#include <vector>

namespace tatbot::teleop
{
// Startup alignment (see the header comment). The follower's target is the
// leader's angle plus an offset that starts at whatever mismatch the two arms
// powered on with and fades to zero over a speed-bounded smoothstep ramp;
// afterwards the mapping is absolute, independent of how either arm was parked
// before power-on.
// In --relative mode the offset never fades, which is the old delta mapping.
class Alignment
{
public:
  Alignment(bool absolute, double rate)
  : absolute_(absolute), rate_(rate) {}

  // Begin a ramp from a fresh pair of baselines (startup, and every resume).
  void restart(
    const std::vector<double> & leader_start,
    const std::vector<double> & follower_start)
  {
    offset_.assign(leader_start.size(), 0.0);
    largest_ = 0.0;
    largest_joint_ = 0;
    for (size_t i = 0; i < offset_.size(); ++i) {
      offset_[i] = follower_start[i] - leader_start[i];
      // The last joint is the follower's tool carriage, which never follows
      // the leader; its offset is never applied, so it must not size the
      // ramp either.
      if (i + 1 < offset_.size() && std::abs(offset_[i]) > largest_) {
        largest_ = std::abs(offset_[i]);
        largest_joint_ = i;
      }
    }
    elapsed_ = 0.0;
    // smoothstep's slope peaks at 1.5x its average, so stretch the ramp by the
    // same factor to keep the fastest instant under `rate`. Below a tenth of a
    // degree there is nothing to ramp and the offset is dropped outright.
    duration_ = (absolute_ && largest_ > already_aligned_rad) ?
      1.5 * largest_ / rate_ : 0.0;
    if (duration_ == 0.0 && absolute_) {
      std::fill(offset_.begin(), offset_.end(), 0.0);
    }
  }

  void advance(double dt) {elapsed_ += dt;}

  // Fraction of the startup offset still applied: 1 at the start of the ramp,
  // 0 once aligned. Always 1 in relative mode.
  double residual() const
  {
    if (!absolute_) {return 1.0;}
    if (elapsed_ >= duration_) {return 0.0;}
    const double u = elapsed_ / duration_;
    return 1.0 - u * u * (3.0 - 2.0 * u);
  }

  bool aligning() const {return absolute_ && elapsed_ < duration_;}
  double position(double leader, size_t joint) const
  {return leader + residual() * offset_[joint];}
  double offset(size_t joint) const {return offset_[joint];}
  double duration() const {return duration_;}
  double largest_rad() const {return largest_;}
  size_t largest_joint() const {return largest_joint_;}

private:
  static constexpr double already_aligned_rad = 0.0017;  // 0.1 deg
  bool absolute_;
  double rate_;
  std::vector<double> offset_;
  double elapsed_ = 0.0;
  double duration_ = 0.0;
  double largest_ = 0.0;
  size_t largest_joint_ = 0;
};

}  // namespace tatbot::teleop
