hu-po/tatbot/rust/tatbot-arm/src/worker.rs

//! One backend owner per arm. A bounded command mailbox cannot stall heartbeat
//! checks; results use a bounded latest-value cell, never a blocking publisher.
use crate::{
    ArmBackend, Control, Error, Measured, OfflineArmBackend, Result, Sample, estop,
    motion_guard::MotionGuard,
    offline_clock::{CONTROL_PERIOD, Clock, OfflineClock},
};
use std::sync::{
    Arc, Mutex,
    atomic::{AtomicBool, AtomicU8, AtomicUsize, Ordering},
    mpsc::{self, SyncSender, TryRecvError},
};
use std::thread::{self, JoinHandle};
use std::time::{Duration, Instant};

/// One-use authorization for a prefix of one continuous stream. The caller
/// grants only after graph guards pass. A missed boundary faults; it never waits
/// with a resumable queue or silently inserts a hold into a planned trajectory.
enum GateDecision {
    Grant(usize),
    Hold,
}
type PhaseGate = Box<dyn FnMut(usize, &Status) -> Result<GateDecision> + Send>;
type StartGuard = Box<dyn Fn(&Status) -> Result<()> + Send + Sync>;

/// The most samples one stream or permit may carry: the planner's tick budget
/// (`planner.max_ticks` in config/motion_constants.json, 625 s at 400 Hz). Every
/// task or hover plan passes `path_plan_check` before dispatch. E-stop,
/// contact and joint watchdogs bound it during execution. The former
/// 24000 (60 s) refused the native scan's 66 s first leg after every guard had
/// passed (run 9616).
pub const MAX_STREAM_SAMPLES: usize = 250_000;
/// While the six rotary joints are in zero-commanded external effort the
/// measured-velocity guard only bounds what a hand can do to the arm; the
/// profile limit tuned for commanded motion tripped on a wrist flick at
/// 2.01 rad/s. A dropped arm still crosses twice that limit within a fraction
/// of a radian, so the trip remains a protective catch.
pub const HAND_GUIDING_VELOCITY_FACTOR: f64 = 2.0;
/// Attended carriage moves: at most 50 mm/s, verified against the target
/// within this tolerance after the goal time.
pub const CARRIAGE_MOVE_TOLERANCE_M: f64 = 0.0005;
/// The bound every timed carriage move honours (`trossen::move_carriage`
/// refuses faster): a 32 mm return to rest takes 0.64 s at this rate, and
/// the 3 s Sleep phase moves it at a third of it.
pub const CARRIAGE_MOVE_MAX_M_PER_S: f64 = 0.05;

pub struct StreamPermit {
    total: usize,
    granted: AtomicUsize,
    claimed: AtomicBool,
    gate: Option<Mutex<PhaseGate>>,
    start_guard: Option<StartGuard>,
    start_guard_refused: AtomicBool,
    stopped_at: AtomicUsize,
    check_every_sample: bool,
    starts_at: Option<Instant>,
}
impl StreamPermit {
    pub fn new(total: usize) -> Result<Arc<Self>> {
        if total == 0 || total > MAX_STREAM_SAMPLES {
            return Err(Error("stream permit length".into()));
        }
        Ok(Arc::new(Self {
            total,
            granted: AtomicUsize::new(0),
            claimed: AtomicBool::new(false),
            gate: None,
            start_guard: None,
            start_guard_refused: AtomicBool::new(false),
            stopped_at: AtomicUsize::new(usize::MAX),
            check_every_sample: false,
            starts_at: None,
        }))
    }
    /// The owner invokes this bounded, nonblocking pure guard at a prefix edge.
    /// It must not perform I/O, wait for a journal, or authorize a later edge.
    pub fn with_phase_gate(
        total: usize,
        mut gate: impl FnMut(usize, &Status) -> Result<usize> + Send + 'static,
    ) -> Result<Arc<Self>> {
        if total == 0 || total > MAX_STREAM_SAMPLES {
            return Err(Error("stream permit length".into()));
        }
        Ok(Arc::new(Self {
            total,
            granted: AtomicUsize::new(0),
            claimed: AtomicBool::new(false),
            gate: Some(Mutex::new(Box::new(move |index, status| {
                gate(index, status).map(GateDecision::Grant)
            }))),
            start_guard: None,
            start_guard_refused: AtomicBool::new(false),
            stopped_at: AtomicUsize::new(usize::MAX),
            check_every_sample: false,
            starts_at: None,
        }))
    }
    /// Evaluate a pure measured stop condition before every sample. A true
    /// result discards the remaining queue and holds measured state. The owner
    /// publishes the stopping index only after that hold succeeds. This does
    /// not classify contact; the caller retains its own measured evidence.
    pub fn with_stop_guard(
        total: usize,
        guard: impl FnMut(usize, &Status) -> Result<bool> + Send + 'static,
    ) -> Result<Arc<Self>> {
        Self::scheduled_stop_guard(total, None, guard)
    }
    /// A shared monotonic start for preloaded streams. Only the initial sample
    /// waits; later missed permits still fault instead of pausing trajectories.
    pub fn scheduled_stop_guard(
        total: usize,
        starts_at: Option<Instant>,
        mut guard: impl FnMut(usize, &Status) -> Result<bool> + Send + 'static,
    ) -> Result<Arc<Self>> {
        let now = Instant::now();
        if starts_at.is_some_and(|start| {
            start <= now || start.duration_since(now) > Duration::from_secs(30)
        }) {
            return Err(Error(
                "scheduled stream start must be within the next 30 seconds".into(),
            ));
        }
        if total == 0 || total > MAX_STREAM_SAMPLES {
            return Err(Error("stream permit length".into()));
        }
        Ok(Arc::new(Self {
            total,
            granted: AtomicUsize::new(0),
            claimed: AtomicBool::new(false),
            gate: Some(Mutex::new(Box::new(move |index, status| {
                Ok(if guard(index, status)? {
                    GateDecision::Hold
                } else {
                    GateDecision::Grant(index + 1)
                })
            }))),
            start_guard: None,
            start_guard_refused: AtomicBool::new(false),
            stopped_at: AtomicUsize::new(usize::MAX),
            check_every_sample: true,
            starts_at,
        }))
    }
    pub fn stopped_at(&self) -> Option<usize> {
        let index = self.stopped_at.load(Ordering::Acquire);
        (index != usize::MAX).then_some(index)
    }
    /// Bind a one-shot, bounded, nonblocking validity check before sharing the
    /// permit. The worker evaluates it at sample zero, even when the initial
    /// approach prefix was already granted by the session owner.
    pub fn bind_start_guard(
        permit: &mut Arc<Self>,
        guard: impl Fn(&Status) -> Result<()> + Send + Sync + 'static,
    ) -> Result<()> {
        let unique = Arc::get_mut(permit)
            .ok_or_else(|| Error("stream start guard requires unshared permit".into()))?;
        if unique.start_guard.is_some() || unique.claimed.load(Ordering::Acquire) {
            return Err(Error("stream start guard already bound or claimed".into()));
        }
        unique.start_guard = Some(Box::new(guard));
        Ok(())
    }
    fn authorize(&self, index: usize, status: &Status) -> Result<bool> {
        if index == 0
            && let Some(guard) = &self.start_guard
            && let Err(error) = guard(status)
        {
            self.start_guard_refused.store(true, Ordering::Release);
            return Err(error);
        }
        if !self.check_every_sample && index < self.granted.load(Ordering::Acquire) {
            return Ok(true);
        }
        if let Some(gate) = &self.gate {
            let mut gate = gate
                .try_lock()
                .map_err(|_| Error("phase gate busy".into()))?;
            let next = match gate(index, status)? {
                GateDecision::Grant(next) => next,
                GateDecision::Hold => return Ok(false),
            };
            if next <= index {
                return Err(Error("phase gate did not authorize next prefix".into()));
            }
            self.grant(next)?;
        }
        Ok(true)
    }
    // Rust 1.99 renamed fetch_update to try_update; the fleet's toolchain is older.
    #[allow(deprecated)]
    pub fn grant(&self, prefix: usize) -> Result<()> {
        if prefix > self.total {
            return Err(Error("stream permit exceeds plan".into()));
        }
        self.granted
            .fetch_update(Ordering::Release, Ordering::Relaxed, |old| {
                (prefix >= old).then_some(prefix)
            })
            .map_err(|_| Error("stream permit cannot move backward".into()))?;
        Ok(())
    }
}
#[derive(Clone, Copy)]
enum TimedHold {
    Measured(Instant),
    Commanded(Instant),
}
impl TimedHold {
    fn due(self, now: Instant) -> bool {
        match self {
            Self::Measured(until) | Self::Commanded(until) => now >= until,
        }
    }
    fn finish<B: ArmBackend>(self, backend: &mut B) -> Result<()> {
        match self {
            Self::Measured(_) => backend.hold(),
            Self::Commanded(_) => backend.finish_joint_stream(),
        }
    }
}
pub enum Primitive {
    TripRetract,
    Reconnect(crate::ArmConfig),
    /// Load the frozen controller profile while idle, before attended takeover.
    LoadConfig(std::path::PathBuf),
    ClearError,
    Reseed,
    Takeover,
    RecoveryMove(crate::recovery::Phase),
    PrepareRecovery {
        staged: [f64; 7],
    },
    /// Release only after landing; ordinary motion requires a new measured re-seed.
    Idle,
    Inject(crate::Faults),
    Stream(Vec<Sample>),
    StreamJoint {
        seed: [f64; 7],
        expected_sequence: u64,
        permit: Option<Arc<StreamPermit>>,
        samples: Vec<crate::JointSample>,
    },
    /// Air-only carriage positioning with all rotary targets held fixed.
    /// The session must separately admit the complete tool sweep in free air.
    StreamCarriage {
        seed: [f64; 7],
        expected_sequence: u64,
        samples: Vec<crate::JointSample>,
    },
    MoveJ {
        target: Vec<f64>,
        goal_time_s: f64,
    },
    Hold,
    Freeze,
    /// Six rotary joints to zero-commanded external effort, carriage held in
    /// position control at the confirmed measured datum. Requires a healthy
    /// position-mode arm with an armed carriage contact baseline.
    HandGuide {
        carriage_m: f64,
    },
    /// Leave hand guiding: measured hold, then fresh position-mode readback.
    GuideStop,
    /// Timed carriage-only move in position control (rotary targets held at
    /// their measured values), verified by readback after the goal time.
    /// Refused while hand guiding or latched.
    CarriageTo {
        target_m: f64,
        goal_time_s: f64,
    },
    /// Read the configured end-effector payload into `Status::payload`.
    ReadPayload,
}
enum QueuedSample {
    Angular(Sample),
    Joint(crate::JointSample, Option<Arc<StreamPermit>>, usize, bool),
}
impl QueuedSample {
    fn joints(&self) -> Vec<f64> {
        match self {
            Self::Angular(s) => s.joints.clone(),
            Self::Joint(s, ..) => s.positions[..6].to_vec(),
        }
    }
    fn execute<B: ArmBackend>(&self, control: &mut Control<B>) -> Result<()> {
        match self {
            Self::Angular(s) => control.stream(s),
            Self::Joint(s, permit, index, transfer) => {
                if permit
                    .as_ref()
                    .is_some_and(|p| *index >= p.granted.load(Ordering::Acquire))
                {
                    return Err(Error(format!(
                        "stream phase not authorized before sample {index}"
                    )));
                }
                if *transfer {
                    control.stream_carriage(s)
                } else {
                    control.stream_joint(s)
                }
            }
        }
    }
}
#[derive(Clone, Debug, serde::Serialize)]
pub struct StreamSeedReceipt {
    pub requested: [f64; 7],
    pub measured: Option<Measured>,
    pub expected_sequence: u64,
    pub previous_sequence: u64,
    pub accepted: bool,
    pub error: Option<String>,
}
/// Counts successful backend submissions, not measured arrival. The sequence
/// binds the counter to one request; a stopped stream never credits its tail.
#[derive(Clone, Debug, serde::Serialize)]
pub struct StreamProgress {
    pub sequence: u64,
    pub total: usize,
    pub submitted: usize,
    pub last_pen: Option<bool>,
    /// Deadline misses only while this stream is executing, including its
    /// final submission and hold. Startup and recovery are counted separately.
    pub late_ticks: u64,
    pub max_late_us: u64,
}
/// An invalid material target stops the stream inside its backend owner. This
/// receipt is retained in Status for the session journal to persist off the
/// control thread; no stroke completion or resumption is implied.
#[derive(Clone, Copy, Debug, PartialEq, Eq, serde::Serialize)]
#[serde(rename_all = "snake_case")]
pub enum TargetAbortOutcome {
    Held,
    Retracted,
    Uncertain,
}
#[derive(Clone, Debug, serde::Serialize)]
pub struct TargetAbortReceipt {
    pub schema: &'static str,
    pub kind: &'static str,
    pub sequence: u64,
    pub stream_progress: Option<StreamProgress>,
    pub requested_wall_ns: u64,
    pub completed_wall_ns: Option<u64>,
    pub outcome: TargetAbortOutcome,
    pub hold_confirmed: bool,
    pub retract_commanded: bool,
    pub contact_armed: bool,
    pub contact_assessable: bool,
    pub contact_age_ms: Option<f64>,
    pub stop_measured: Option<Measured>,
    pub final_measured: Option<Measured>,
    pub reason: String,
    pub motion_authority: bool,
}
/// What the hand-guiding entry and exit actually did, from fresh readbacks.
#[derive(Clone, Debug, serde::Serialize)]
pub struct GuideReceipt {
    pub carriage_datum_m: f64,
    pub entered_wall_ns: u64,
    pub entered_measured: Measured,
    pub stopped_wall_ns: Option<u64>,
    /// The measured pose submitted as the position target on stop.
    pub stop_submitted: Option<[f64; 7]>,
    pub stop_measured: Option<Measured>,
    pub stop_error: Option<String>,
}
/// One control tick's feedback, forwarded to a recorder off the owner thread.
#[derive(Clone, Debug)]
pub struct TelemetrySample {
    pub tick: u64,
    pub wall_ns: u64,
    pub since_start: Duration,
    pub measured: Measured,
    pub estop: i32,
    pub guiding: bool,
    pub latched: bool,
}
#[derive(Clone, Debug, Default)]
pub struct Status {
    /// The owner believes the six rotary joints are in hand guiding.
    pub guiding: bool,
    pub guide: Option<GuideReceipt>,
    /// Telemetry samples the recorder could not accept in time.
    pub telemetry_dropped: u64,
    /// The controller's configured end-effector payload, when read.
    pub payload: Option<serde_json::Value>,
    /// Freshness uses the worker's source clock. Live hardware always uses
    /// monotonic host time; offline world time pauses between requested steps.
    pub clock: Clock,
    /// Mock fault-injection acknowledgement, retained independently of the
    /// controller fault it deliberately causes. Reset on the next request.
    pub injection_result: Option<std::result::Result<(), String>>,
    pub contact: Option<crate::contact::ContactEvaluation>,
    pub contact_at: Option<Instant>,
    pub watchdog_ok: bool,
    pub retract_verified: Option<bool>,
    /// One-shot target-invalid abort outcome. The session persists this
    /// serializable receipt after observing it; the worker performs no I/O.
    pub target_abort: Option<TargetAbortReceipt>,
    /// What the backend's last connect waited for (`Reconnect`, and the
    /// reconnect inside `ClearError`); the session journals it.
    pub connect_wait: Option<crate::ConnectWait>,
    pub recovery_targets: Option<crate::recovery::Targets>,
    pub stream_seed: Option<StreamSeedReceipt>,
    pub stream_progress: Option<StreamProgress>,
    /// The one-shot sample-zero validity check refused after queue admission.
    /// This is an explicit owner signal, separate from ordinary phase faults.
    pub stream_start_guard_refused: bool,
    pub commands: u64,
    pub sequence: u64,
    pub completed: bool,
    pub fault: Option<String>,
    /// The exact worker fault for which a recovery class was established.
    /// Replacing the fault text (for example with a failed retract) invalidates
    /// this class rather than lending the old trip's retry policy to a new fault.
    pub recovery_fault: Option<(String, RecoveryFaultCategory)>,
    pub measured: Option<Measured>,
    /// Host receipt time of this measured sample, never the subscriber poll time.
    pub measured_wall_ns: u64,
    /// Start of the SDK read corresponding to measured_wall_ns.
    pub measured_started_wall_ns: u64,
    /// Offline world timestamp; absent on live workers. Host receipt timestamps
    /// above remain wall time and must not be used as simulation source time.
    pub measured_simulation_ns: Option<u64>,
    /// Local freshness cannot be extended by a wall-clock adjustment.
    pub measured_at: Option<Instant>,
    /// Control ticks that started after their 2.5 ms slot. A stream is paced
    /// by the loop, so late ticks stretch it; the runtime judges completion by
    /// progress and retains these counts as evidence of a loop that could not
    /// keep the period (an unoptimised build on the arm node did not).
    pub late_ticks: u64,
    pub max_late_us: u64,
}
#[derive(Clone, Copy, Debug, PartialEq, Eq)]
pub enum RecoveryFaultCategory {
    Trip,
}
impl Status {
    pub fn recovery_category(&self) -> Option<&'static str> {
        match self.recovery_fault.as_ref() {
            Some((message, RecoveryFaultCategory::Trip))
                if self.fault.as_ref() == Some(message) && self.retract_verified != Some(false) =>
            {
                Some("trip")
            }
            _ => None,
        }
    }
    fn record_lateness(&mut self, late_us: u64, joint_stream_tick: bool) {
        self.late_ticks += 1;
        self.max_late_us = self.max_late_us.max(late_us);
        if joint_stream_tick && let Some(progress) = &mut self.stream_progress {
            progress.late_ticks += 1;
            progress.max_late_us = progress.max_late_us.max(late_us);
        }
    }
    /// A missing, unarmed, unassessable or stale contact meter never grants a
    /// contact transition. This is carriage evidence, not a calibrated pen-tip
    /// contact classification or proof of fixture contact.
    pub fn contact_is_valid(&self, max_age: Duration) -> bool {
        self.fault.is_none()
            && self.measurement_is_fresh(max_age)
            && self.contact.is_some_and(|c| c.armed && c.assessable)
            && self
                .contact_at
                .and_then(|stamp| self.clock.now().checked_duration_since(stamp))
                .is_some_and(|age| age <= max_age)
    }
    pub fn measurement_is_fresh(&self, max_age: Duration) -> bool {
        self.clock.running()
            && self.measured.is_some()
            && self
                .measured_at
                .and_then(|stamp| self.clock.now().checked_duration_since(stamp))
                .is_some_and(|age| age <= max_age)
    }
    /// Why `contact_is_valid(max_age)` does not hold, naming the channel, or
    /// None when it holds. A consumer that refuses on staleness says this
    /// instead of "stale": on 2026-09-18 a paper search faulted at 49 mm with
    /// every measurement under 17 ms old, and the fault did not say that it
    /// was the contact estimate that had lapsed.
    pub fn staleness(&self, max_age: Duration) -> Option<String> {
        let limit_ms = max_age.as_secs_f64() * 1e3;
        let age_ms = |stamp: Option<Instant>| {
            stamp
                .and_then(|stamp| self.clock.now().checked_duration_since(stamp))
                .map(|age| age.as_secs_f64() * 1e3)
        };
        if let Some(fault) = &self.fault {
            return Some(format!("worker fault: {fault}"));
        }
        if !self.clock.running() {
            return Some("worker clock not running".into());
        }
        if self.measured.is_none() {
            return Some("no measurement yet".into());
        }
        match age_ms(self.measured_at) {
            None => return Some("measurement receipt time missing or in the future".into()),
            Some(age) if age > limit_ms => {
                return Some(format!(
                    "measurement {age:.1} ms old, limit {limit_ms:.0} ms"
                ));
            }
            Some(_) => {}
        }
        let Some(contact) = self.contact else {
            return Some("no contact meter".into());
        };
        if !contact.armed {
            return Some("contact meter not armed (baseline re-arming)".into());
        }
        if !contact.assessable {
            return Some("contact meter not assessable (arm moving)".into());
        }
        match age_ms(self.contact_at) {
            None => Some("contact estimate receipt time missing or in the future".into()),
            Some(age) if age > limit_ms => Some(format!(
                "contact estimate {age:.1} ms old, limit {limit_ms:.0} ms"
            )),
            Some(_) => None,
        }
    }
}
struct Request {
    sequence: u64,
    primitive: Primitive,
    joint_queue: Option<std::collections::VecDeque<QueuedSample>>,
}
pub struct Worker {
    pub software_stop: Arc<AtomicBool>,
    target_abort: Arc<AtomicU8>,
    sender: SyncSender<Request>,
    status: Arc<Mutex<Status>>,
    shutdown: Arc<AtomicBool>,
    idle_on_shutdown: Arc<AtomicBool>,
    shutdown_receipt: Arc<Mutex<Option<Result<crate::Measured>>>>,
    thread: Option<JoinHandle<()>>,
    sequence: u64,
    native_shutdown_timeout: Option<Duration>,
    clock: Clock,
}
impl Worker {
    pub fn spawn<B: ArmBackend + Send + 'static>(
        control: Control<B>,
        period: Duration,
        guard: MotionGuard,
    ) -> Result<Self> {
        Self::spawn_with(move || Ok(control), period, guard)
    }

    /// Construct and destroy a backend on its sole owning thread. Vendor
    /// objects need not be Send, and never receive an unsafe Send promise.
    /// Construction failures are published as completed faults; no tick runs.
    /// Construction must not arm motion: the tick-level protections begin
    /// only after it returns. Connection timeouts remain the factory's duty.
    pub fn spawn_with<B, F>(construct: F, period: Duration, guard: MotionGuard) -> Result<Self>
    where
        B: ArmBackend + 'static,
        F: FnOnce() -> Result<Control<B>> + Send + 'static,
    {
        Self::spawn_timed(
            construct,
            period,
            guard,
            Clock::Live,
            None,
            Arc::new(AtomicBool::new(false)),
            None,
        )
    }

    /// A live worker that forwards every tick's feedback to `telemetry` with
    /// a non-blocking send: the hand-guiding owner records it off this thread.
    pub fn spawn_recording<B, F>(
        construct: F,
        guard: MotionGuard,
        telemetry: SyncSender<TelemetrySample>,
    ) -> Result<Self>
    where
        B: ArmBackend + 'static,
        F: FnOnce() -> Result<Control<B>> + Send + 'static,
    {
        Self::spawn_timed(
            construct,
            CONTROL_PERIOD,
            guard,
            Clock::Live,
            None,
            Arc::new(AtomicBool::new(false)),
            Some(telemetry),
        )
    }

    /// Run the same guards and commands against one explicitly offline world.
    /// Its caller grants 2.5 ms ticks through the clock and receives an
    /// acknowledgement only after world advancement and feedback publication.
    /// Hardware adapters cannot enter this path through `ArmBackend` alone.
    pub fn spawn_offline_with<B, F>(
        construct: F,
        clock: Arc<OfflineClock>,
        guard: MotionGuard,
    ) -> Result<Self>
    where
        B: OfflineArmBackend + 'static,
        F: FnOnce() -> Result<Control<B>> + Send + 'static,
    {
        Self::spawn_offline_with_stop(construct, clock, guard, Arc::new(AtomicBool::new(false)))
    }

    /// Retain the launcher's stop token while replacing its unstarted mock
    /// worker with an offline world. Signals can cancel world construction and
    /// still stop the selected worker after construction succeeds.
    pub fn spawn_offline_with_stop<B, F>(
        construct: F,
        clock: Arc<OfflineClock>,
        guard: MotionGuard,
        software_stop: Arc<AtomicBool>,
    ) -> Result<Self>
    where
        B: OfflineArmBackend + 'static,
        F: FnOnce() -> Result<Control<B>> + Send + 'static,
    {
        clock.claim_worker()?;
        Self::spawn_timed(
            construct,
            CONTROL_PERIOD,
            guard,
            Clock::Offline(clock),
            Some(B::advance_world),
            software_stop,
            None,
        )
    }

    fn spawn_timed<B, F>(
        construct: F,
        period: Duration,
        mut guard: MotionGuard,
        clock: Clock,
        advance_world: Option<fn(&mut B, Duration) -> Result<()>>,
        software_stop: Arc<AtomicBool>,
        telemetry: Option<SyncSender<TelemetrySample>>,
    ) -> Result<Self>
    where
        B: ArmBackend + 'static,
        F: FnOnce() -> Result<Control<B>> + Send + 'static,
    {
        if period != CONTROL_PERIOD {
            return Err(Error(
                "control period must be 2.5ms for the carried contact-cap contract".into(),
            ));
        }
        let (sender, receiver) = mpsc::sync_channel::<Request>(1);
        let status = Arc::new(Mutex::new(Status {
            guiding: false,
            guide: None,
            telemetry_dropped: 0,
            payload: None,
            clock: clock.clone(),
            injection_result: None,
            contact: None,
            contact_at: None,
            watchdog_ok: false,
            retract_verified: None,
            target_abort: None,
            connect_wait: None,
            recovery_targets: None,
            stream_seed: None,
            stream_progress: None,
            stream_start_guard_refused: false,
            commands: 0,
            sequence: 0,
            completed: false,
            fault: None,
            recovery_fault: None,
            measured: None,
            measured_wall_ns: 0,
            measured_started_wall_ns: 0,
            measured_simulation_ns: None,
            measured_at: None,
            late_ticks: 0,
            max_late_us: 0,
        }));
        let published = status.clone();
        let shutdown = Arc::new(AtomicBool::new(false));
        let idle_on_shutdown = Arc::new(AtomicBool::new(false));
        let terminal_idle = idle_on_shutdown.clone();
        let shutdown_receipt = Arc::new(Mutex::new(None));
        let terminal_receipt = shutdown_receipt.clone();
        let stop = shutdown.clone();
        let emergency = software_stop.clone();
        let target_abort = Arc::new(AtomicU8::new(0));
        let target_abort_requested = target_abort.clone();
        let owner_clock = clock.clone();
        let thread = thread::spawn(move || {
            let clock = owner_clock;
            let _offline_owner = match &clock {
                Clock::Offline(clock) => Some(clock.owner_guard()),
                Clock::Live => None,
            };
            let mut control = match construct() {
                Ok(control) => control,
                Err(error) => {
                    let mut state = published.lock().unwrap();
                    state.fault = Some(format!("backend construction: {error}"));
                    state.completed = true;
                    state.watchdog_ok = false;
                    if let Clock::Offline(clock) = &clock {
                        clock.close(state.fault.as_ref().unwrap().clone());
                    }
                    return;
                }
            };
            let start = clock.now();
            let mut next = clock.now();
            let mut pending = std::collections::VecDeque::new();
            let mut state = Status {
                guiding: false,
                guide: None,
                telemetry_dropped: 0,
                payload: None,
                clock: clock.clone(),
                injection_result: None,
                contact: None,
                contact_at: None,
                watchdog_ok: true,
                retract_verified: None,
                target_abort: None,
                connect_wait: None,
                recovery_targets: None,
                stream_seed: None,
                stream_progress: None,
                stream_start_guard_refused: false,
                commands: 0,
                sequence: 0,
                completed: true,
                fault: None,
                recovery_fault: None,
                measured: None,
                measured_wall_ns: 0,
                measured_started_wall_ns: 0,
                measured_simulation_ns: None,
                measured_at: None,
                late_ticks: 0,
                max_late_us: 0,
            };
            let mut latched = false;
            let mut emergency_seen = false;
            let mut parked = false;
            let mut watchdog = crate::tracking_watchdog::TrackingWatchdog::default();
            let mut commanded: Option<Vec<f64>> = None;
            let mut contact = crate::contact::ContactCap::default();
            let mut retract_started: Option<Instant> = None;
            let mut carriage_move: Option<(Instant, f64, f64)> = None;
            // An air carriage transfer (`StreamCarriage`: rotary targets held,
            // the free-air sweep admitted by the session with a clearance
            // receipt) is judged by its deflection screen only, like the
            // hand-guide's timed carriage move: at 1 mm/s the carriage's own
            // stick-slip reads 17-24 N against a baseline armed elsewhere,
            // the cap's own magnitude, with no displacement (seven transfers,
            // 2026-09-13 to 09-16). Half a second after its last sample the
            // baseline re-arms where the carriage now rests.
            let mut transfer_until: Option<Instant> = None;
            let mut motion_until: Option<TimedHold> = None;
            let mut guiding = false;
            let base_velocity_limit = guard.velocity_limit;
            // The carriage's effort channel counts as contact, and a trip
            // retracts along it, only for a contact tool on a qualified
            // carriage; a standoff tool or an unqualified carriage keeps the
            // deflection screen and holds on a trip.
            let carriage_contact = control.backend.contact_policy()
                == crate::ContactPolicy::Contact
                && control.backend.carriage_qualified();
            let mut feedback = FeedbackChange::default();
            let mut tick: u64 = 0;
            while !stop.load(Ordering::Acquire) {
                tick += 1;
                if let Clock::Offline(clock) = &clock
                    && !clock.wait_tick(&stop, || {
                        let active = control.estop.load(Ordering::SeqCst) != estop::OK
                            || emergency.load(Ordering::Acquire)
                            || target_abort_requested.load(Ordering::Acquire) == 1;
                        if !active {
                            emergency_seen = false;
                        }
                        active && !emergency_seen
                    })
                {
                    break;
                }
                let target_abort_now = target_abort_requested
                    .compare_exchange(1, 2, Ordering::AcqRel, Ordering::Acquire)
                    .is_ok();
                let mut joint_stream_tick = state.stream_progress.is_some() && !state.completed;
                // No FSM, journal, bus or viewer code executes on this thread.
                emergency_seen = control.estop.load(Ordering::SeqCst) != estop::OK
                    || emergency.load(Ordering::Acquire);
                if emergency_seen {
                    if let Some(receipt) = &mut state.target_abort
                        && receipt.retract_commanded
                        && receipt.completed_wall_ns.is_none()
                    {
                        receipt.outcome = TargetAbortOutcome::Uncertain;
                        receipt.completed_wall_ns = Some(wall_ns());
                        receipt.reason =
                            "physical or software stop interrupted target retract".into();
                    }
                    parked = false;
                    pending.clear();
                    retract_started = None;
                    carriage_move = None;
                    motion_until = None;
                    latched = true;
                    let hold = control.backend.hold();
                    if hold.is_ok() {
                        guiding = false;
                    }
                    state.fault = Some(match hold {
                        Ok(()) => "e-stop".into(),
                        Err(e) => format!("e-stop hold failed: {e}"),
                    });
                    state.completed = true;
                }
                if target_abort_now {
                    let prior_latch = latched;
                    let prior_retract = retract_started.take().is_some();
                    let contact_age_ms = state
                        .contact_at
                        .and_then(|at| clock.now().checked_duration_since(at))
                        .map(|age| age.as_secs_f64() * 1e3);
                    let contact_armed = state.contact.is_some_and(|c| c.armed);
                    let contact_assessable = state.contact.is_some_and(|c| c.assessable);
                    let prior_measurement_fresh =
                        state.measurement_is_fresh(Duration::from_millis(20));
                    let pen_submitted =
                        state.stream_progress.as_ref().and_then(|p| p.last_pen) == Some(true);
                    let active_stream = !state.completed
                        && state
                            .stream_progress
                            .as_ref()
                            .is_some_and(|p| p.submitted > 0);
                    let mut receipt = TargetAbortReceipt {
                        schema: "tatbot.receipt/1",
                        kind: "target-abort",
                        sequence: state.sequence,
                        stream_progress: state.stream_progress.clone(),
                        requested_wall_ns: wall_ns(),
                        completed_wall_ns: None,
                        outcome: TargetAbortOutcome::Uncertain,
                        hold_confirmed: false,
                        retract_commanded: false,
                        contact_armed,
                        contact_assessable,
                        contact_age_ms,
                        stop_measured: None,
                        final_measured: None,
                        reason: "target abort pending measured hold".into(),
                        motion_authority: false,
                    };
                    pending.clear();
                    motion_until = None;
                    carriage_move = None;
                    commanded = None;
                    watchdog.reset();
                    latched = true;
                    parked = false;
                    state.completed = true;
                    state.retract_verified = None;
                    // The higher-priority stop already issued its hold above.
                    // Never add a controller query or command to that path.
                    let hold = (!emergency_seen).then(|| control.backend.hold());
                    let stopped = hold
                        .as_ref()
                        .filter(|result| result.is_ok())
                        .and_then(|_| control.backend.measured_fresh().ok());
                    let healthy = stopped.as_ref().is_some_and(|m| {
                        m.mode == crate::Mode::Position
                            && m.error.is_empty()
                            && m.joints.len() == 6
                            && m.joints.iter().all(|q| q.is_finite())
                            && m.velocities.len() >= 6
                            && m.velocities[..6]
                                .iter()
                                .all(|speed| speed.is_finite() && speed.abs() < 0.3)
                            && m.carriage.as_ref().is_some_and(|c| {
                                c.position_m.is_finite()
                                    && c.target_m.is_some_and(f64::is_finite)
                                    && c.effort_n.is_finite()
                            })
                    });
                    receipt.hold_confirmed = hold.as_ref().is_some_and(Result::is_ok) && healthy;
                    receipt.stop_measured = stopped.clone();
                    let basic_retract_ready = !emergency_seen
                        && !prior_latch
                        && !prior_retract
                        && receipt.hold_confirmed
                        && carriage_contact
                        && active_stream
                        && pen_submitted
                        && prior_measurement_fresh
                        && contact_armed
                        && contact_age_ms.is_some_and(|age| age <= 20.0);
                    let carriage_in_limits = basic_retract_ready
                        && stopped
                            .as_ref()
                            .and_then(|m| m.carriage.as_ref())
                            .zip(control.backend.recovery_limits().ok())
                            .is_some_and(|(carriage, limits)| {
                                let limit = limits[6];
                                carriage.position_m >= limit.min
                                    && carriage.position_m <= limit.max
                                    && (limit.min..=limit.max).contains(&0.032)
                                    && carriage.position_m <= 0.032
                            });
                    // A backend hold, fresh readback, or live-limit query may
                    // block. The pre-stop evidence must still be current at
                    // the actual retract decision, not only at abort entry.
                    let decision_contact_age_ms = state
                        .contact_at
                        .and_then(|at| clock.now().checked_duration_since(at))
                        .map(|age| age.as_secs_f64() * 1e3);
                    receipt.contact_age_ms = decision_contact_age_ms;
                    let feedback_still_fresh = state
                        .measurement_is_fresh(Duration::from_millis(20))
                        && decision_contact_age_ms.is_some_and(|age| age <= 20.0);
                    let stop_now = control.estop.load(Ordering::SeqCst) != estop::OK
                        || emergency.load(Ordering::Acquire);
                    let refusal = if emergency_seen || stop_now {
                        Some("physical or software stop has priority")
                    } else if prior_latch || prior_retract {
                        Some("another fault or retract was already latched")
                    } else if !receipt.hold_confirmed {
                        Some("measured position hold is unverified")
                    } else if !carriage_contact {
                        Some("contact carriage retract is unqualified")
                    } else if !active_stream || !pen_submitted {
                        Some("no active submitted pen-contact stream")
                    } else if !prior_measurement_fresh {
                        Some("pre-stop controller feedback is stale")
                    } else if !contact_armed || contact_age_ms.is_none_or(|age| age > 20.0) {
                        Some("armed contact feedback is missing or stale")
                    } else if !carriage_in_limits {
                        Some("carriage feedback outside live recovery limits")
                    } else if !feedback_still_fresh {
                        Some("contact or controller feedback aged during target abort")
                    } else {
                        None
                    };
                    if let Some(reason) = refusal {
                        receipt.outcome = if receipt.hold_confirmed
                            && !prior_retract
                            && !emergency_seen
                            && !stop_now
                        {
                            TargetAbortOutcome::Held
                        } else {
                            TargetAbortOutcome::Uncertain
                        };
                        receipt.completed_wall_ns = Some(wall_ns());
                        receipt.final_measured = stopped;
                        receipt.reason = reason.into();
                    } else {
                        // The fixed trip-retract command is already qualified by
                        // this backend. The worker verifies its readback below;
                        // neither the caller nor the session clears a stop.
                        if control.estop.load(Ordering::SeqCst) != estop::OK
                            || emergency.load(Ordering::Acquire)
                        {
                            receipt.completed_wall_ns = Some(wall_ns());
                            receipt.reason = "stop arrived before target retract".into();
                        } else {
                            match control.backend.retract_carriage(0.032, 0.6) {
                                Ok(()) => {
                                    retract_started = Some(clock.now());
                                    state.completed = false;
                                    receipt.retract_commanded = true;
                                    receipt.reason =
                                        "retract commanded; awaiting measured readback".into();
                                }
                                Err(error) => {
                                    state.retract_verified = Some(false);
                                    receipt.completed_wall_ns = Some(wall_ns());
                                    receipt.reason =
                                        format!("target retract command failed: {error}");
                                }
                            }
                        }
                    }
                    if !emergency_seen {
                        state.fault = Some(format!("target invalid; {}", receipt.reason));
                    }
                    state.target_abort = Some(receipt);
                }
                let measured_started_wall_ns = wall_ns();
                match control.backend.measured() {
                    Ok(m) => {
                        if parked && (m.mode != crate::Mode::Idle || !m.error.is_empty()) {
                            parked = false;
                            state.fault =
                                Some(format!("idle mode lost; hold={:?}", control.backend.hold()));
                        }
                        let expected_mode = if guiding {
                            crate::Mode::HandGuiding
                        } else {
                            crate::Mode::Position
                        };
                        // Measured joints may rest inside the controller's
                        // feedback tolerance past the nominal envelope (a wrist
                        // rolled to 3.148 rad against a pi bound while guiding).
                        let measured_envelope =
                            control.envelope + crate::FEEDBACK_POSITION_TOLERANCE_RAD;
                        if !latched
                            && (m.mode != expected_mode
                                || !m.error.is_empty()
                                || m.joints.is_empty()
                                || m.joints
                                    .iter()
                                    .any(|q| !q.is_finite() || q.abs() > measured_envelope))
                        {
                            pending.clear();
                            latched = true;
                            state.completed = true;
                            let hold = control.backend.hold();
                            guiding = guiding && hold.is_err();
                            state.fault = Some(format!(
                                "controller/envelope (mode {:?}, expected {:?}); hold={hold:?}",
                                m.mode, expected_mode
                            ));
                        }
                        // The SDK returns cached UDP output after feedback stops.
                        // An entirely unchanged seven-axis tuple for 250 ms is
                        // refused while hand guiding; this is a conservative
                        // screen, not a measured packet age.
                        if !latched
                            && guiding
                            && feedback.observe(&m, clock.now()) >= Duration::from_millis(250)
                        {
                            pending.clear();
                            latched = true;
                            state.completed = true;
                            let hold = control.backend.hold();
                            guiding = guiding && hold.is_err();
                            state.fault = Some(format!(
                                "feedback unchanged for 250 ms; controller feedback unverified; hold={hold:?}"
                            ));
                        }
                        if !latched
                            && let Some(target) = &commanded
                            && let Err(error) = watchdog.observe(
                                target,
                                &m.joints,
                                clock.since(start).as_secs_f64(),
                            )
                        {
                            pending.clear();
                            latched = true;
                            state.watchdog_ok = false;
                            state.completed = true;
                            let hold = control.backend.hold();
                            state.fault = Some(format!("{error}; hold={hold:?}"));
                            state.recovery_fault = hold.is_ok().then(|| {
                                (state.fault.clone().unwrap(), RecoveryFaultCategory::Trip)
                            });
                        }
                        let mut trip = None;
                        state.contact = None;
                        state.contact_at = None;
                        guard.velocity_limit = if guiding {
                            base_velocity_limit * HAND_GUIDING_VELOCITY_FACTOR
                        } else {
                            base_velocity_limit
                        };
                        if !latched {
                            trip = guard
                                .observe(
                                    clock.since(start).as_secs_f64(),
                                    &m.velocities,
                                    &m.efforts,
                                )
                                .map(|t| {
                                    format!(
                                        "{}: joint={} observed={} limit={}",
                                        t.reason, t.joint, t.observed, t.limit
                                    )
                                });
                            // A commanded carriage move is not contact: its
                            // position lags its target by the whole travel. The
                            // cap resumes on the measured hold that ends the move.
                            // An unqualified carriage's effort is never a
                            // contact signal, guided or streamed: about -110 N
                            // at rest, swinging 20 N with posture in free space
                            // (measured while guiding; streamed motion changes
                            // posture the same way). Only its deflection screen
                            // judges contact, and its trip holds; so does a
                            // standoff tool's, which never touches the work.
                            if let Some(until) = transfer_until
                                && clock.now() >= until
                            {
                                transfer_until = None;
                                contact.rearm();
                            }
                            if let Some(carriage) = &m.carriage
                                && let Some(target_m) = carriage.target_m
                                && carriage_move.is_none()
                            {
                                let speed =
                                    m.velocities.iter().map(|v| v.abs()).fold(0.0_f64, f64::max);
                                match contact.observe(crate::contact::ContactObservation {
                                    effort_n: carriage.effort_n,
                                    position_m: carriage.position_m,
                                    target_m,
                                    arm_speed_rad_s: speed,
                                    aligning: motion_until.is_some()
                                        || !pending.is_empty()
                                        || speed >= 0.3,
                                    effort_assessable: carriage_contact && transfer_until.is_none(),
                                }) {
                                    Ok(e) => {
                                        state.contact = Some(e);
                                        state.contact_at = Some(clock.now());
                                        if e.trip {
                                            trip = Some(format!(
                                                "carriage_contact_cap: contact_n={} cap_n={} deflection_m={} limit_m={} effort_n={} position_m={} target_m={} baseline_n={:?}",
                                                e.contact_n,
                                                contact.cap_n,
                                                e.deflection_m,
                                                contact.deflect_m,
                                                carriage.effort_n,
                                                carriage.position_m,
                                                target_m,
                                                e.baseline_n
                                            ));
                                        }
                                    }
                                    Err(e) => trip = Some(e.to_string()),
                                }
                            }
                        }
                        if let Some(reason) = trip {
                            pending.clear();
                            latched = true;
                            state.completed = true;
                            let hold = control.backend.hold();
                            guiding = guiding && hold.is_err();
                            state.fault = Some(format!("{reason}; hold={hold:?}"));
                            state.recovery_fault = hold.is_ok().then(|| {
                                (state.fault.clone().unwrap(), RecoveryFaultCategory::Trip)
                            });
                            // A trip retract never outranks the physical stop atomic.
                            if control.estop.load(Ordering::SeqCst) == estop::OK
                                && !emergency.load(Ordering::Acquire)
                                && carriage_contact
                            {
                                match control.backend.retract_carriage(0.032, 0.6) {
                                    Ok(()) => {
                                        retract_started = Some(clock.now());
                                        state.completed = false;
                                        state.retract_verified = None;
                                    }
                                    Err(e) => {
                                        state.retract_verified = Some(false);
                                        state.fault =
                                            Some(format!("{reason}; retract failed: {e}"));
                                    }
                                }
                            }
                        }
                        if let Some((started, target_m, goal_time_s)) = carriage_move
                            && clock.since(started).as_secs_f64() >= goal_time_s + 0.3
                        {
                            carriage_move = None;
                            motion_until = None;
                            match &m.carriage {
                                Some(carriage)
                                    if (carriage.position_m - target_m).abs()
                                        <= CARRIAGE_MOVE_TOLERANCE_M =>
                                {
                                    state.completed = true;
                                    if let Err(error) = control.backend.hold() {
                                        latched = true;
                                        state.fault = Some(format!(
                                            "hold after carriage move failed: {error}"
                                        ));
                                    }
                                }
                                other => {
                                    latched = true;
                                    state.completed = true;
                                    state.fault = Some(format!(
                                        "carriage did not reach {target_m} m: measured {:?}; hold={:?}",
                                        other.as_ref().map(|c| c.position_m),
                                        control.backend.hold()
                                    ));
                                }
                            }
                        }
                        if let Some(started) = retract_started {
                            let target_retract =
                                state.target_abort.as_ref().is_some_and(|receipt| {
                                    receipt.retract_commanded && receipt.completed_wall_ns.is_none()
                                });
                            if let Some(carriage) = &m.carriage
                                && (carriage.position_m - 0.032).abs() <= 0.002
                                && (!target_retract
                                    || (m.mode == crate::Mode::Position
                                        && m.error.is_empty()
                                        && m.joints.len() == 6
                                        && m.joints.iter().all(|q| q.is_finite())))
                            {
                                state.retract_verified = Some(true);
                                state.completed = true;
                                retract_started = None;
                                if target_retract && let Some(receipt) = &mut state.target_abort {
                                    receipt.outcome = TargetAbortOutcome::Retracted;
                                    receipt.completed_wall_ns = Some(wall_ns());
                                    receipt.final_measured = Some(m.clone());
                                    receipt.reason =
                                        "qualified target retract verified by carriage readback"
                                            .into();
                                }
                            } else if clock.since(started) > Duration::from_millis(800) {
                                state.retract_verified = Some(false);
                                state.completed = true;
                                retract_started = None;
                                state.fault = Some(format!(
                                    "{}; PEN NOT RETRACTED",
                                    state.fault.as_deref().unwrap_or("trip")
                                ));
                                if target_retract && let Some(receipt) = &mut state.target_abort {
                                    receipt.outcome = TargetAbortOutcome::Uncertain;
                                    receipt.completed_wall_ns = Some(wall_ns());
                                    receipt.final_measured = Some(m.clone());
                                    receipt.reason =
                                        "target retract not verified before 800 ms deadline".into();
                                }
                            }
                        }
                        state.measured_started_wall_ns = measured_started_wall_ns;
                        state.measured_wall_ns = wall_ns();
                        state.measured_at = Some(clock.now());
                        state.measured_simulation_ns = clock.timestamp_ns();
                        if let Some(sender) = &telemetry
                            && sender
                                .try_send(TelemetrySample {
                                    tick,
                                    wall_ns: state.measured_wall_ns,
                                    since_start: clock.since(start),
                                    measured: m.clone(),
                                    estop: control.estop.load(Ordering::SeqCst),
                                    guiding,
                                    latched,
                                })
                                .is_err()
                        {
                            state.telemetry_dropped += 1;
                        }
                        state.measured = Some(m);
                    }
                    Err(e) => {
                        pending.clear();
                        latched = true;
                        retract_started = None;
                        if let Some(receipt) = &mut state.target_abort
                            && receipt.retract_commanded
                            && receipt.completed_wall_ns.is_none()
                        {
                            receipt.outcome = TargetAbortOutcome::Uncertain;
                            receipt.completed_wall_ns = Some(wall_ns());
                            receipt.reason = format!("target retract feedback failed: {e}");
                        }
                        let hold = control.backend.hold();
                        guiding = guiding && hold.is_err();
                        state.fault = Some(format!("measurement: {e}; hold={hold:?}"));
                        state.completed = true;
                        if let Clock::Offline(clock) = &clock {
                            state.watchdog_ok = false;
                            *published.lock().unwrap() = state.clone();
                            clock.close(state.fault.as_ref().unwrap().clone());
                            break;
                        }
                    }
                }
                // A target abort's measured retract owns the backend until
                // its receipt is final. Even a queued recovery request waits;
                // it cannot hide an incomplete retract behind a new sequence.
                let request = if state.target_abort.as_ref().is_some_and(|receipt| {
                    receipt.retract_commanded && receipt.completed_wall_ns.is_none()
                }) {
                    Err(TryRecvError::Empty)
                } else {
                    receiver.try_recv()
                };
                match request {
                    Ok(request) => {
                        let previous_sequence = state.sequence;
                        state.stream_seed = None;
                        state.stream_progress = None;
                        state.stream_start_guard_refused = false;
                        state.sequence = request.sequence;
                        state.injection_result = None;
                        match request.primitive {
                            // While hand guiding only the stop, freeze, trip and
                            // mock-injection primitives are operations of this
                            // mode. Anything else is a conductor error: latch and
                            // take the ordered effort-to-position freeze.
                            ref other
                                if guiding
                                    && !matches!(
                                        other,
                                        Primitive::TripRetract
                                            | Primitive::Inject(_)
                                            | Primitive::ReadPayload
                                            | Primitive::Hold
                                            | Primitive::Freeze
                                            | Primitive::GuideStop
                                    ) =>
                            {
                                pending.clear();
                                latched = true;
                                state.completed = true;
                                let hold = control.backend.hold();
                                if hold.is_ok() {
                                    guiding = false;
                                }
                                state.fault = Some(format!(
                                    "primitive refused while hand guiding; hold={hold:?}"
                                ));
                            }
                            Primitive::TripRetract => {
                                motion_until = None;
                                pending.clear();
                                latched = true;
                                state.completed = true;
                                if control.estop.load(Ordering::SeqCst) != estop::OK
                                    || emergency.load(Ordering::Acquire)
                                {
                                    state.fault = Some("e-stop prevents retract".into());
                                    state.retract_verified = Some(false);
                                } else if !carriage_contact {
                                    state.fault = Some(format!(
                                        "trip hold without retract ({:?} tool, carriage_qualified={}); hold={:?}",
                                        control.backend.contact_policy(),
                                        control.backend.carriage_qualified(),
                                        control.backend.hold()
                                    ));
                                    state.retract_verified = None;
                                } else {
                                    let _ = control.backend.hold();
                                    match control.backend.retract_carriage(0.032, 0.6) {
                                        Ok(()) => {
                                            retract_started = Some(clock.now());
                                            state.completed = false;
                                            state.retract_verified = None;
                                        }
                                        Err(e) => {
                                            state.fault = Some(e.to_string());
                                            state.retract_verified = Some(false);
                                        }
                                    }
                                }
                            }
                            Primitive::Reconnect(config) => {
                                motion_until = None;
                                state.recovery_targets = None;
                                parked = false;
                                guiding = false;
                                pending.clear();
                                contact = crate::contact::ContactCap::default();
                                state.contact = None;
                                state.contact_at = None;
                                state.completed = true;
                                state.fault = control
                                    .backend
                                    .connect(&config)
                                    .err()
                                    .map(|e| e.to_string());
                                state.connect_wait = control.backend.connect_wait();
                                if state.fault.is_none() {
                                    watchdog.reset();
                                    commanded = None;
                                    state.watchdog_ok = true;
                                }
                            }
                            Primitive::LoadConfig(path) => {
                                state.completed = true;
                                let result = (|| {
                                    if control.estop.load(Ordering::SeqCst) != estop::OK
                                        || emergency.load(Ordering::Acquire)
                                        || control.backend.measured()?.mode != crate::Mode::Idle
                                    {
                                        return Err(Error(
                                            "profile loading requires a released stop and idle arm"
                                                .into(),
                                        ));
                                    }
                                    control.backend.load_config(&path)
                                })();
                                state.fault = result.err().map(|error| error.to_string());
                            }
                            Primitive::ClearError => {
                                pending.clear();
                                state.completed = true;
                                state.fault =
                                    control.backend.clear_error().err().map(|e| e.to_string());
                                state.connect_wait = control.backend.connect_wait();
                            }
                            Primitive::Inject(faults) => {
                                state.completed = true;
                                let result = control
                                    .backend
                                    .inject_faults(faults)
                                    .map_err(|e| e.to_string());
                                state.fault = result.as_ref().err().cloned();
                                state.injection_result = Some(result);
                            }
                            Primitive::ReadPayload => {
                                state.completed = true;
                                match control.backend.payload_readback() {
                                    Ok(payload) => state.payload = payload,
                                    Err(e) => state.fault = Some(format!("payload readback: {e}")),
                                }
                            }
                            Primitive::PrepareRecovery { staged } => {
                                let busy = !pending.is_empty() || motion_until.is_some();
                                state.completed = true;
                                state.recovery_targets = None;
                                let result = (|| {
                                    if control.estop.load(Ordering::SeqCst) != estop::OK
                                        || emergency.load(Ordering::Acquire)
                                    {
                                        return Err(Error(
                                            "e-stop prevents recovery preparation".into(),
                                        ));
                                    }
                                    if busy {
                                        return Err(Error(
                                            "busy during recovery preparation".into(),
                                        ));
                                    }
                                    let axes = |m: Measured| -> Result<[f64; 7]> {
                                        if !m.error.is_empty() || m.joints.len() != 6 {
                                            return Err(Error(
                                                "unhealthy recovery measurement".into(),
                                            ));
                                        }
                                        let carriage = m.carriage.ok_or_else(|| {
                                            Error("recovery carriage unavailable".into())
                                        })?;
                                        let mut q = [0.0; 7];
                                        q[..6].copy_from_slice(&m.joints);
                                        q[6] = carriage.position_m;
                                        Ok(q)
                                    };
                                    let mut measured = axes(control.backend.measured()?)?;
                                    if control.backend.recovery_needs_configuration(&measured)? {
                                        // Native clear_error applies its golden then reconnects.
                                        // Re-read both pose and limits; never retain boot limits.
                                        control.backend.clear_error()?;
                                        measured = axes(control.backend.measured()?)?;
                                    }
                                    let limits = control.backend.recovery_limits()?;
                                    if control.estop.load(Ordering::SeqCst) != estop::OK
                                        || emergency.load(Ordering::Acquire)
                                    {
                                        return Err(Error(
                                            "e-stop during recovery preparation".into(),
                                        ));
                                    }
                                    crate::recovery::Targets::from_measured(
                                        measured,
                                        staged,
                                        &limits,
                                        carriage_rest(&control.backend, &staged),
                                    )
                                })();
                                match result {
                                    Ok(targets) => {
                                        // Preparation may reload the golden and reconnect
                                        // in idle. No ordinary motion is admitted until
                                        // Takeover explicitly verifies position control.
                                        latched = true;
                                        commanded = None;
                                        watchdog.reset();
                                        state.recovery_targets = Some(targets);
                                        state.fault = None;
                                        state.recovery_fault = None;
                                    }
                                    Err(error) => {
                                        pending.clear();
                                        motion_until = None;
                                        state.fault = Some(format!(
                                            "{error}; hold={:?}",
                                            control.backend.hold()
                                        ));
                                        latched = true;
                                    }
                                }
                            }
                            Primitive::Takeover => {
                                parked = false;
                                guiding = false;
                                pending.clear();
                                motion_until = None;
                                state.completed = true;
                                let result = (|| {
                                    if control.estop.load(Ordering::SeqCst) != estop::OK
                                        || emergency.load(Ordering::Acquire)
                                    {
                                        return Err(Error("e-stop prevents takeover".into()));
                                    }
                                    let prepared =
                                        state.recovery_targets.as_ref().ok_or_else(|| {
                                            Error("prepare recovery before takeover".into())
                                        })?;
                                    let staged = prepared.staged;
                                    // The prepared Sleep carriage is the profile's rest
                                    // for a qualified carriage (its staged pose carries
                                    // the measured value); an unqualified one is re-read.
                                    let rest = control
                                        .backend
                                        .carriage_qualified()
                                        .then_some(prepared.sleep[6]);
                                    let measured = control.backend.measured()?;
                                    if !measured.error.is_empty() || measured.joints.len() != 6 {
                                        return Err(Error("unhealthy takeover measurement".into()));
                                    }
                                    let mut q = [0.0; 7];
                                    q[..6].copy_from_slice(&measured.joints);
                                    q[6] = measured
                                        .carriage
                                        .ok_or_else(|| Error("takeover carriage missing".into()))?
                                        .position_m;
                                    let limits = control.backend.recovery_limits()?;
                                    let targets = crate::recovery::Targets::from_measured(
                                        q, staged, &limits, rest,
                                    )?;
                                    if !control.envelope.is_finite()
                                        || control.envelope <= 0.0
                                        || !control.max_velocity.is_finite()
                                        || control.max_velocity <= 0.0
                                        || targets.takeover[..6].iter().zip(&q[..6]).any(
                                            |(target, current)| {
                                                target.abs() > control.envelope
                                                    || 2.0 * (target - current).abs()
                                                        / crate::recovery::TAKEOVER_S
                                                        > control.max_velocity
                                            },
                                        )
                                    {
                                        return Err(Error(
                                            "takeover violates control envelope/velocity".into(),
                                        ));
                                    }
                                    if control.estop.load(Ordering::SeqCst) != estop::OK
                                        || emergency.load(Ordering::Acquire)
                                    {
                                        return Err(Error(
                                            "e-stop during takeover preparation".into(),
                                        ));
                                    }
                                    control.backend.takeover(&targets.takeover)?;
                                    Ok(targets)
                                })();
                                match result {
                                    Ok(targets) => {
                                        commanded = Some(targets.takeover[..6].to_vec());
                                        state.recovery_targets = Some(targets);
                                        latched = false;
                                        guard.reset();
                                        watchdog.reset();
                                        state.watchdog_ok = true;
                                        state.fault = None;
                                        state.recovery_fault = None;
                                        state.commands += 1;
                                        state.completed = false;
                                        motion_until = Some(TimedHold::Measured(
                                            clock.now()
                                                + Duration::from_secs_f64(
                                                    crate::recovery::TAKEOVER_S,
                                                ),
                                        ));
                                    }
                                    Err(error) => {
                                        latched = true;
                                        state.fault = Some(format!(
                                            "{error}; hold={:?}",
                                            control.backend.hold()
                                        ));
                                    }
                                }
                            }
                            Primitive::Reseed => {
                                motion_until = None;
                                parked = false;
                                guiding = false;
                                pending.clear();
                                state.completed = true;
                                let result = (|| {
                                    if control.estop.load(Ordering::SeqCst) != estop::OK
                                        || emergency.load(Ordering::Acquire)
                                    {
                                        return Err(Error("e-stop".into()));
                                    }
                                    let measured = control.backend.measured()?;
                                    if !measured.error.is_empty() {
                                        return Err(Error("controller unhealthy".into()));
                                    }
                                    let duration = control
                                        .backend
                                        .reseed_hold(control.max_velocity, control.envelope)?;
                                    if duration > Duration::from_secs(5) {
                                        return Err(Error(
                                            "re-seed hold interval exceeds five seconds".into(),
                                        ));
                                    }
                                    let measured = control.backend.measured()?;
                                    // The backend seeded all axes. Validate readback
                                    // without treating tolerated encoder feedback
                                    // beyond the envelope as a commanded target.
                                    let envelope = control.envelope;
                                    control.check_sample(&Sample {
                                        joints: measured
                                            .joints
                                            .iter()
                                            .map(|q| q.clamp(-envelope, envelope))
                                            .collect(),
                                        dt_s: period.as_secs_f64(),
                                        contact: 0.0,
                                    })?;
                                    Ok(duration)
                                })();
                                match result {
                                    Ok(duration) => {
                                        latched = false;
                                        guard.reset();
                                        watchdog.reset();
                                        commanded = None;
                                        state.watchdog_ok = true;
                                        state.fault = None;
                                        state.recovery_fault = None;
                                        state.commands += 1;
                                        if !duration.is_zero() {
                                            state.completed = false;
                                            motion_until =
                                                Some(TimedHold::Commanded(clock.now() + duration));
                                        }
                                    }
                                    Err(e) => {
                                        latched = true;
                                        state.fault = Some(e.to_string());
                                    }
                                }
                            }
                            Primitive::Hold | Primitive::Freeze => {
                                motion_until = None;
                                pending.clear();
                                commanded = None;
                                watchdog.reset();
                                state.completed = true;
                                match control.backend.hold() {
                                    Ok(()) => guiding = false,
                                    Err(e) => {
                                        state.fault = Some(e.to_string());
                                        latched = true;
                                    }
                                }
                            }
                            _ if latched => {
                                state.completed = true;
                                state.fault = Some("Recover with measured re-seed required".into());
                            }
                            Primitive::CarriageTo {
                                target_m,
                                goal_time_s,
                            } => {
                                pending.clear();
                                commanded = None;
                                state.completed = true;
                                let result = (|| {
                                    if control.estop.load(Ordering::SeqCst) != estop::OK
                                        || emergency.load(Ordering::Acquire)
                                    {
                                        return Err(Error("e-stop prevents carriage move".into()));
                                    }
                                    if !target_m.is_finite() || !(1.0..=5.0).contains(&goal_time_s)
                                    {
                                        return Err(Error("unqualified carriage move".into()));
                                    }
                                    let measured = control.backend.measured()?;
                                    if measured.mode != crate::Mode::Position
                                        || !measured.error.is_empty()
                                    {
                                        return Err(Error(format!(
                                            "carriage move needs a healthy position-mode arm: {:?} {}",
                                            measured.mode, measured.error
                                        )));
                                    }
                                    control.backend.move_carriage(target_m, goal_time_s)
                                })();
                                match result {
                                    Ok(()) => {
                                        state.completed = false;
                                        state.fault = None;
                                        state.recovery_fault = None;
                                        state.commands += 1;
                                        carriage_move = Some((clock.now(), target_m, goal_time_s));
                                        // The moving carriage is not a contact; the cap
                                        // treats it as alignment until it settles. The
                                        // readback check clears this itself; the expiry
                                        // only backs it up.
                                        motion_until = Some(TimedHold::Measured(
                                            clock.now()
                                                + Duration::from_secs_f64(goal_time_s + 0.5),
                                        ));
                                    }
                                    Err(error) => {
                                        latched = true;
                                        state.fault = Some(format!(
                                            "{error}; hold={:?}",
                                            control.backend.hold()
                                        ));
                                    }
                                }
                            }
                            Primitive::GuideStop => {
                                // Order: fresh measurement, all joints to position
                                // control, that measured pose as the target; then a
                                // fresh mode readback decides whether the arm is held.
                                motion_until = None;
                                pending.clear();
                                commanded = None;
                                watchdog.reset();
                                state.completed = true;
                                let result = (|| {
                                    if !guiding {
                                        return Err(Error("not hand guiding".into()));
                                    }
                                    let before = control.backend.measured()?;
                                    control.backend.hold()?;
                                    let after = control.backend.measured_fresh()?;
                                    if after.mode != crate::Mode::Position
                                        || !after.error.is_empty()
                                    {
                                        return Err(Error(format!(
                                            "position mode not confirmed after hand-guiding stop: {:?} {}",
                                            after.mode, after.error
                                        )));
                                    }
                                    let mut submitted = [0.0; 7];
                                    submitted[..6].copy_from_slice(&before.joints);
                                    submitted[6] =
                                        before.carriage.as_ref().map_or(f64::NAN, |c| c.position_m);
                                    Ok((submitted, after))
                                })();
                                if let Some(receipt) = &mut state.guide {
                                    receipt.stopped_wall_ns = Some(wall_ns());
                                    receipt.stop_error =
                                        result.as_ref().err().map(ToString::to_string);
                                    if let Ok((submitted, after)) = &result {
                                        receipt.stop_submitted = Some(*submitted);
                                        receipt.stop_measured = Some(after.clone());
                                    }
                                }
                                match result {
                                    Ok(_) => {
                                        guiding = false;
                                        state.guiding = false;
                                        state.fault = None;
                                        state.recovery_fault = None;
                                        state.commands += 1;
                                    }
                                    Err(error) => {
                                        // Mode unknown: keep the owner alive and latched.
                                        latched = true;
                                        state.fault = Some(format!(
                                            "{error}; hold={:?}",
                                            control.backend.hold()
                                        ));
                                    }
                                }
                            }
                            _ if !pending.is_empty() || motion_until.is_some() => {
                                // Never attach a new acknowledgement sequence to
                                // an old stream that continues moving invisibly.
                                pending.clear();
                                latched = true;
                                state.completed = true;
                                state.fault =
                                    Some(format!("busy; hold={:?}", control.backend.hold()));
                            }
                            Primitive::HandGuide { carriage_m } => {
                                state.completed = true;
                                let result = (|| {
                                    if control.estop.load(Ordering::SeqCst) != estop::OK
                                        || emergency.load(Ordering::Acquire)
                                    {
                                        return Err(Error("e-stop prevents hand guiding".into()));
                                    }
                                    let measured = control.backend.measured_fresh()?;
                                    let carriage = measured.carriage.as_ref().ok_or_else(|| {
                                        Error("carriage measurement missing".into())
                                    })?;
                                    if measured.mode != crate::Mode::Position
                                        || !measured.error.is_empty()
                                        || measured.joints.len() != 6
                                    {
                                        return Err(Error(format!(
                                            "hand guiding needs a healthy position-mode arm: {:?} {}",
                                            measured.mode, measured.error
                                        )));
                                    }
                                    if !carriage_m.is_finite()
                                        || (carriage.position_m - carriage_m).abs() > 0.0005
                                    {
                                        return Err(Error(format!(
                                            "carriage datum {carriage_m} differs from measured {}",
                                            carriage.position_m
                                        )));
                                    }
                                    if !state.contact.is_some_and(|c| c.armed) {
                                        return Err(Error(
                                            "carriage contact baseline not armed; rest the unloaded arm first".into(),
                                        ));
                                    }
                                    control.backend.enter_hand_guiding(carriage_m)?;
                                    let after = control.backend.measured_fresh()?;
                                    if after.mode != crate::Mode::HandGuiding
                                        || !after.error.is_empty()
                                    {
                                        return Err(Error(format!(
                                            "mixed hand-guiding mode not confirmed by readback: {:?} {}",
                                            after.mode, after.error
                                        )));
                                    }
                                    Ok(after)
                                })();
                                match result {
                                    Ok(after) => {
                                        guiding = true;
                                        commanded = None;
                                        watchdog.reset();
                                        feedback = FeedbackChange::default();
                                        state.guiding = true;
                                        state.guide = Some(GuideReceipt {
                                            carriage_datum_m: carriage_m,
                                            entered_wall_ns: wall_ns(),
                                            entered_measured: after,
                                            stopped_wall_ns: None,
                                            stop_submitted: None,
                                            stop_measured: None,
                                            stop_error: None,
                                        });
                                        state.fault = None;
                                        state.recovery_fault = None;
                                        state.commands += 1;
                                    }
                                    Err(error) => {
                                        latched = true;
                                        state.fault = Some(format!(
                                            "{error}; hold={:?}",
                                            control.backend.hold()
                                        ));
                                    }
                                }
                            }
                            Primitive::RecoveryMove(phase) => {
                                state.completed = true;
                                let result = (|| {
                                    if control.estop.load(Ordering::SeqCst) != estop::OK
                                        || emergency.load(Ordering::Acquire)
                                    {
                                        return Err(Error("e-stop prevents recovery move".into()));
                                    }
                                    let targets =
                                        state.recovery_targets.as_ref().ok_or_else(|| {
                                            Error("prepare recovery before move".into())
                                        })?;
                                    let target = phase.target(targets);
                                    let measured = control.backend.measured()?;
                                    if measured.mode != crate::Mode::Position
                                        || !measured.error.is_empty()
                                        || measured.joints.len() != 6
                                        || measured.joints.iter().any(|q| !q.is_finite())
                                    {
                                        return Err(Error(
                                            "unhealthy recovery move measurement".into(),
                                        ));
                                    }
                                    if crate::recovery::needs_golden(
                                        &target,
                                        &control.backend.recovery_limits()?,
                                    )? {
                                        return Err(Error(
                                            "recovery move outside live limits".into(),
                                        ));
                                    }
                                    if !control.envelope.is_finite()
                                        || control.envelope <= 0.0
                                        || !control.max_velocity.is_finite()
                                        || control.max_velocity <= 0.0
                                        || target[..6].iter().zip(&measured.joints).any(
                                            |(q, current)| {
                                                q.abs() > control.envelope
                                                    || current.abs() > control.envelope
                                                    || 2.0 * (q - current).abs() / phase.duration()
                                                        > control.max_velocity
                                            },
                                        )
                                    {
                                        return Err(Error(
                                            "recovery move violates control envelope/velocity"
                                                .into(),
                                        ));
                                    }
                                    // The carriage rides at its measured value through
                                    // every phase but a qualified carriage's return to
                                    // rest at Sleep: that is a timed carriage move under
                                    // the same bound as `CarriageTo`, judged by its
                                    // readback, with the contact estimator sitting it out.
                                    let carriage_m = measured
                                        .carriage
                                        .as_ref()
                                        .ok_or_else(|| {
                                            Error("recovery move carriage missing".into())
                                        })?
                                        .position_m;
                                    let carriage_travel_m = (target[6] - carriage_m).abs();
                                    let moves_carriage =
                                        carriage_travel_m > CARRIAGE_MOVE_TOLERANCE_M;
                                    if moves_carriage
                                        && (!control.backend.carriage_qualified()
                                            || carriage_travel_m / phase.duration()
                                                > CARRIAGE_MOVE_MAX_M_PER_S)
                                    {
                                        return Err(Error(format!(
                                            "recovery move carriage travel {carriage_travel_m:.4} m refused (carriage_qualified={})",
                                            control.backend.carriage_qualified()
                                        )));
                                    }
                                    if control.estop.load(Ordering::SeqCst) != estop::OK
                                        || emergency.load(Ordering::Acquire)
                                    {
                                        return Err(Error(
                                            "e-stop during recovery move preparation".into(),
                                        ));
                                    }
                                    control.backend.recovery_move(&target, phase)?;
                                    Ok((target, moves_carriage))
                                })();
                                match result {
                                    Ok((target, moves_carriage)) => {
                                        commanded = Some(target[..6].to_vec());
                                        watchdog.reset();
                                        state.commands += 1;
                                        state.completed = false;
                                        state.fault = None;
                                        state.recovery_fault = None;
                                        if moves_carriage {
                                            carriage_move =
                                                Some((clock.now(), target[6], phase.duration()));
                                            // The readback check completes the move; the
                                            // expiry only backs it up, as for `CarriageTo`.
                                            motion_until = Some(TimedHold::Measured(
                                                clock.now()
                                                    + Duration::from_secs_f64(
                                                        phase.duration() + 0.5,
                                                    ),
                                            ));
                                        } else {
                                            motion_until = Some(TimedHold::Measured(
                                                clock.now()
                                                    + Duration::from_secs_f64(phase.duration()),
                                            ));
                                        }
                                    }
                                    Err(error) => {
                                        latched = true;
                                        state.fault = Some(format!(
                                            "{error}; hold={:?}",
                                            control.backend.hold()
                                        ));
                                    }
                                }
                            }
                            Primitive::Idle => {
                                state.completed = true;
                                let result = (|| {
                                    if control.estop.load(Ordering::SeqCst) != estop::OK
                                        || emergency.load(Ordering::Acquire)
                                    {
                                        return Err(Error("e-stop prevents idle release".into()));
                                    }
                                    control.backend.set_mode(crate::Mode::Idle)?;
                                    // Mode changes may be acknowledged before feedback catches up.
                                    // Keep polling the physical stop while waiting for measured idle.
                                    let deadline = Instant::now() + Duration::from_millis(500);
                                    loop {
                                        if control.estop.load(Ordering::SeqCst) != estop::OK
                                            || emergency.load(Ordering::Acquire)
                                        {
                                            return Err(Error(
                                                "e-stop prevents idle release".into(),
                                            ));
                                        }
                                        let measured = control.backend.measured()?;
                                        if !measured.error.is_empty() {
                                            return Err(Error(format!(
                                                "idle release controller error: {}",
                                                measured.error
                                            )));
                                        }
                                        if measured.mode == crate::Mode::Idle {
                                            return Ok(());
                                        }
                                        if Instant::now() >= deadline {
                                            return Err(Error(format!(
                                                "idle mode not confirmed by controller: {:?}",
                                                measured.mode
                                            )));
                                        }
                                        thread::sleep(Duration::from_millis(2));
                                    }
                                })();
                                latched = true;
                                commanded = None;
                                watchdog.reset();
                                state.contact = None;
                                state.contact_at = None;
                                parked = result.is_ok();
                                state.fault = result.err().map(|e| e.to_string());
                                if !parked {
                                    let _ = control.backend.hold();
                                }
                            }
                            Primitive::StreamJoint {
                                seed,
                                expected_sequence,
                                ..
                            }
                            | Primitive::StreamCarriage {
                                seed,
                                expected_sequence,
                                ..
                            } => {
                                let mut receipt = StreamSeedReceipt {
                                    requested: seed,
                                    measured: None,
                                    expected_sequence,
                                    previous_sequence,
                                    accepted: false,
                                    error: None,
                                };
                                let result = (|| {
                                    if expected_sequence != previous_sequence {
                                        return Err(Error(format!(
                                            "stream preflight sequence changed: expected {expected_sequence}, actual {previous_sequence}"
                                        )));
                                    }
                                    let queue = request.joint_queue.ok_or_else(|| {
                                        Error("missing validated joint queue".into())
                                    })?;
                                    let first = match queue.front() {
                                        Some(QueuedSample::Joint(s, ..)) => s,
                                        _ => return Err(Error("missing joint seed sample".into())),
                                    };
                                    let measured = control.backend.measured()?;
                                    receipt.measured = Some(measured.clone());
                                    first.check_seed(&seed, &measured)?;
                                    if control.estop.load(Ordering::SeqCst) != estop::OK
                                        || emergency.load(Ordering::Acquire)
                                    {
                                        return Err(Error(
                                            "e-stop prevents stream dispatch".into(),
                                        ));
                                    }
                                    state.stream_progress = Some(StreamProgress {
                                        sequence: request.sequence,
                                        total: queue.len(),
                                        submitted: 0,
                                        last_pen: None,
                                        late_ticks: 0,
                                        max_late_us: 0,
                                    });
                                    pending = queue;
                                    Ok(())
                                })();
                                receipt.accepted = result.is_ok();
                                receipt.error = result.as_ref().err().map(ToString::to_string);
                                if result.is_ok()
                                    && matches!(
                                        pending.front(),
                                        Some(QueuedSample::Joint(_, _, _, true))
                                    )
                                {
                                    // The admitted air transfer starts now; every
                                    // executed sample extends the window.
                                    transfer_until = Some(clock.now() + Duration::from_millis(500));
                                }
                                state.stream_seed = Some(receipt);
                                state.completed = result.is_err();
                                state.fault = result
                                    .err()
                                    .map(|e| format!("{e}; hold={:?}", control.backend.hold()));
                                if state.fault.is_some() {
                                    latched = true;
                                    pending.clear();
                                }
                            }
                            Primitive::Stream(samples) => {
                                if samples.is_empty()
                                    || samples.len() > MAX_STREAM_SAMPLES
                                    || samples
                                        .iter()
                                        .any(|s| (s.dt_s - period.as_secs_f64()).abs() > 1e-9)
                                {
                                    state.completed = true;
                                    state.fault = Some("stream sample period mismatch".into());
                                } else {
                                    pending.extend(samples.into_iter().map(QueuedSample::Angular));
                                    state.completed = false;
                                    state.fault = None;
                                    state.recovery_fault = None;
                                }
                            }
                            Primitive::MoveJ {
                                target,
                                goal_time_s,
                            } => {
                                if !goal_time_s.is_finite()
                                    || goal_time_s <= 0.0
                                    || goal_time_s > 60.0
                                {
                                    state.completed = true;
                                    state.fault = Some("invalid MoveJ duration".into());
                                } else if let Some(m) = &state.measured {
                                    if target.len() != m.joints.len() {
                                        state.completed = true;
                                        state.fault = Some("MoveJ width".into());
                                    } else {
                                        let ticks =
                                            (goal_time_s / period.as_secs_f64()).ceil() as usize;
                                        for i in 1..=ticks {
                                            let t = i as f64 / ticks as f64;
                                            let blend = t * t * (3.0 - 2.0 * t);
                                            pending.push_back(QueuedSample::Angular(Sample {
                                                joints: m
                                                    .joints
                                                    .iter()
                                                    .zip(&target)
                                                    .map(|(a, b)| a + (b - a) * blend)
                                                    .collect(),
                                                dt_s: period.as_secs_f64(),
                                                contact: 0.0,
                                            }));
                                        }
                                        state.completed = false;
                                        state.fault = None;
                                        state.recovery_fault = None;
                                    }
                                }
                            }
                        }
                    }
                    Err(TryRecvError::Disconnected) => break,
                    Err(TryRecvError::Empty) => {}
                }
                joint_stream_tick |= state.stream_progress.is_some() && !state.completed;
                let awaiting_start = matches!(pending.front(),
                    Some(QueuedSample::Joint(_, Some(permit), index, _))
                    if (*index == 0).then_some(permit.starts_at).flatten()
                        .is_some_and(|start| clock.now() < start));
                if !latched
                    && !awaiting_start
                    && let Some(sample) = pending.pop_front()
                {
                    let authorization = match &sample {
                        QueuedSample::Joint(_, Some(permit), index, _) => {
                            let seed_check = if *index == 0 && permit.starts_at.is_some() {
                                match (&sample, &state.measured) {
                                    (QueuedSample::Joint(first, ..), Some(measured)) => {
                                        first.check_seed(&first.positions, measured).map(|_| ())
                                    }
                                    _ => Err(Error(
                                        "scheduled stream lacks fresh measured seed".into(),
                                    )),
                                }
                            } else {
                                Ok(())
                            };
                            seed_check.and_then(|_| permit.authorize(*index, &state))
                        }
                        _ => Ok(true),
                    };
                    let guarded_stop = matches!(authorization, Ok(false));
                    if guarded_stop {
                        pending.clear();
                        state.completed = true;
                        match control.backend.hold() {
                            Ok(()) => {
                                commanded = None;
                                watchdog.reset();
                                if let QueuedSample::Joint(_, Some(permit), index, _) = &sample {
                                    permit.stopped_at.store(*index, Ordering::Release);
                                }
                            }
                            Err(error) => {
                                latched = true;
                                state.fault = Some(format!("measured stop hold failed: {error}"));
                            }
                        }
                    } else if let Err(e) = authorization.and_then(|_| sample.execute(&mut control))
                    {
                        if let QueuedSample::Joint(_, Some(permit), 0, _) = &sample {
                            state.stream_start_guard_refused =
                                permit.start_guard_refused.load(Ordering::Acquire);
                        }
                        pending.clear();
                        latched = true;
                        state.fault = Some(format!("{e}; hold={:?}", control.backend.hold()));
                    } else {
                        commanded = Some(sample.joints());
                        state.commands += 1;
                        if let (QueuedSample::Joint(sample, ..), Some(progress)) =
                            (&sample, &mut state.stream_progress)
                        {
                            progress.submitted += 1;
                            progress.last_pen = Some(sample.pen);
                        }
                        if let QueuedSample::Joint(_, _, _, true) = &sample {
                            transfer_until = Some(clock.now() + Duration::from_millis(500));
                        }
                    }
                    state.completed = pending.is_empty();
                    if state.completed && !latched && !guarded_stop {
                        let result = match sample {
                            QueuedSample::Joint(..) => control.backend.finish_joint_stream(),
                            QueuedSample::Angular(..) if matches!(clock, Clock::Offline(_)) => {
                                control.backend.finish_joint_stream()
                            }
                            QueuedSample::Angular(..) => control.backend.hold(),
                        };
                        if let Err(error) = result {
                            latched = true;
                            state.fault = Some(format!(
                                "stream completion hold failed: {error}; hold={:?}",
                                control.backend.hold()
                            ));
                        }
                    }
                }
                if let (Clock::Offline(offline), Some(advance)) = (&clock, advance_world)
                    && let Err(error) =
                        advance(&mut control.backend, period).and_then(|()| offline.stepped())
                {
                    state.fault = Some(format!("offline world step: {error}"));
                    state.completed = true;
                    state.watchdog_ok = false;
                    *published.lock().unwrap() = state.clone();
                    offline.close(state.fault.as_ref().unwrap().clone());
                    break;
                }
                if latched {
                    motion_until = None;
                } else if motion_until.is_some_and(|hold| hold.due(clock.now())) {
                    let hold = motion_until.take().unwrap();
                    state.completed = true;
                    if let Err(error) = hold.finish(&mut control.backend) {
                        latched = true;
                        state.fault = Some(format!("timed recovery hold failed: {error}"));
                    }
                }
                // Completion includes a post-command measurement; acknowledgements
                // must never expose the pre-clear/pre-reseed controller snapshot.
                let measured_started_wall_ns = wall_ns();
                match control.backend.measured() {
                    Ok(m) => {
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
