hu-po/tatbot/ros/tatbot_session/tatbot_session/executor.py

"""One arm's executor: page setup and touches, the stroke loop, tool changes and palette dips, pauses, latches
and decisions, landing.

The next op is always the first op whose last ledger event is not done/skipped. Each stroke is planned by tatbot_motion
from the measured joints (the next stroke is pre-planned while the current one runs, then checked for drift at
dispatch) and sent as one FollowJointTrajectory goal. A riding pen's tattoo machine runs only inside the op loop: on
before each stroke goal, off whenever the loop waits for a decision, dips or ends, and at once when the arm latches
(the node). A tool change that needs a different cartridge lands the arm for the operator; resuming the run is the
acknowledgement. The operator's pen trim (the numpad) is added to every stroke goal as it is sent, and replaces the
running one ahead of now when it changes; a needle cartridge's goes no deeper than the skin read along the stroke
lets it (_cap_for). A dipping cartridge's charge (charge.py) adds, moves or skips dips around the program's, and the
numpad's + dips at once. ros/README.md 4.3, 4.4, 6, 8.
"""
from __future__ import annotations

import copy
import dataclasses
import functools
import itertools
import json
import queue
import threading
from concurrent.futures import ThreadPoolExecutor

import numpy as np
from tatbot_description import names

from tatbot_session import charge, closeup, config, curved, gauge, geometry, machine, ready, rules, track
from tatbot_session import ledger as ledger_mod
from tatbot_session.lease import in_cap, in_cap_refusal
from tatbot_session.ports import WALL, Event, Phase

P = Phase   # Draw.Feedback's PHASE_* numbers
# A flat page whose wrist gauge points stand farther than this off their plane is a curved skin: refused, never
# drawn flat (on 2026-10-13 a flat page on the curved holder rode high at its edges and deep in its middle).
CURVED_PAGE_M = 0.0015


def motion_result(status, text, activity, allowed=('ok',)):
    if status == 'cancelled':
        raise Cancelled()
    if status not in allowed:
        raise RuntimeError(f'{activity}: {status}: {text}')


def _rinses(resource: dict) -> bool:
    """The resource takes the cartridge from the last ink by a rinse in a cap of water, not a landing."""
    return (resource.get("activation") or {}).get("method") == "rinse"


class Landed(Exception):  # noqa: N818 - control flow, not an error
    """The arm landed (a decision, a Land request, or the resume timeout); the goal ends."""


class Cancelled(Exception):  # noqa: N818 - control flow, not an error
    """The goal was cancelled; the arm holds where it is."""



def _median_pose(base: np.ndarray, poses) -> np.ndarray:
    """The median of page poses about `base`: their centres' displacement and turn in base's own page frame, each
    the median (sheet_slide's way), as a pose."""
    moves = [inv @ pose for inv in [np.linalg.inv(base)] for pose in poses]
    turn, local = float(np.median([_yaw(m) for m in moves])), np.eye(4)
    local[:2, :2] = [[np.cos(turn), -np.sin(turn)], [np.sin(turn), np.cos(turn)]]
    local[:2, 3] = np.median([m[:2, 3] for m in moves], axis=0)
    return base @ local

def _yaw(m: np.ndarray) -> float:
    """The turn of a pose (or a motion) about its z axis, rad."""
    return float(np.arctan2(m[1, 0], m[0, 0]))


def _median_move(moves) -> tuple[float, float, int, float] | None:
    """(slide m, turn rad, readings, rise m): the medians of geometry.marks_moved's moves; None without one."""
    if not moves:
        return None
    return (float(np.median([m[0] for m in moves])), float(np.median([m[1] for m in moves])), len(moves),
            float(np.median([m[3] for m in moves])))


def _unconfirmed(page: dict) -> bool:   # a page row its holds moved past the curved limit, no check holds confirming it
    return bool((holds := page.get("holds") or {}).get("confirm")) and not holds.get("stands")


# Where a page row's holds placed the page, in its plane, from the wrist's own page then (its locate's prior moved by the
# wrist's estimate): the gauge tip's offset across the pen axis among it. Eye when its wrist read no print. With the
# turn of the row's ready heading in that page (None without one): the offset turns with the pen (_turn_carried).
def _held_off(page: dict) -> tuple[np.ndarray, float | None]:
    if not (w := (locate := page.get("locate") or {}).get("wrist")) or locate.get("overhead") is None:
        return np.eye(4), None
    seen = geometry.rpy_matrix([w["tx_m"], w["ty_m"], 0.0], [0.0, 0.0, w["theta_rad"]])   # inspect.correction_matrix
    own = np.asarray(locate["overhead"], float) @ np.linalg.inv(seen)
    d = np.linalg.inv(own) @ np.asarray(page["camera_at_setup"], float) @ np.asarray(page["correction"], float)
    held = (page.get("ready") or {}).get("heading")
    return (geometry.rpy_matrix([d[0, 3], d[1, 3], 0.0], [0.0, 0.0, float(np.arctan2(d[1, 0], d[0, 0]))]),
            None if held is None else ready.heading_yaw(own, np.asarray(held, float)))


def _dense(polylines, step: float = 0.001) -> np.ndarray:
    """The polylines' points (page metres) no farther than `step` apart along them."""
    out = []
    for p in polylines:
        p = np.asarray(p, float).reshape(-1, 2)
        out += [a + (b - a) * np.linspace(0.0, 1.0, max(1, int(np.ceil(np.linalg.norm(b - a) / step))),
                                          endpoint=False)[:, None] for a, b in zip(p[:-1], p[1:], strict=True)] + [p[-1:]]
    return np.concatenate(out)


def _past(moved, translation_m: float, rotation_rad: float) -> bool:
    """Whether a sheet's move (_median_move) is past a limit: its slide and rise along the page's normal together
    (a skin lifted toward the overhead reads ~0.7 of the lift as a slide), or its turn."""
    return float(np.hypot(moved[0], moved[3])) > translation_m or abs(moved[1]) > rotation_rad


class Ask:
    """One Decide call handed to a waiting executor. It answers only the wait it was made for: an Ask
    left over from an earlier wait, or one its caller gave up on, is never applied."""

    def __init__(self, decision: int, wait_id: int):
        self.decision, self.wait_id = decision, wait_id
        self.reply: queue.Queue = queue.Queue()
        self.taken = self.abandoned = False


class ArmExecutor:
    def __init__(self, node, io, kin, motion: dict, stack: dict, repo, *, clock=None, sensing=None, planner=None):
        """node, io: ports.NodePort and ArmPort; clock: ports.Clock (the wall clock by default); sensing: ports.Sensing
        (by default stack.yaml sensing.wrist's at each use, gauge.sensing); planner: where the next stroke is pre-planned (an
        executor with submit(), one worker thread by default)."""
        self.node, self.io, self.kin, self.motion, self.stack, self.repo = node, io, kin, motion, stack, repo
        gauge.wrist(stack)   # a sensing.wrist this hardware cannot take refuses here, as the node starts, not mid-draw
        self.clock = clock or WALL
        self.ride_base = float(motion["pen"]["ride"]["fraction"])   # motion.yaml's, which draw() reloads
        self.arm = io.arm
        self.busy = threading.Lock()
        self._lock = threading.Lock()  # guards waiting/_wait_id/goal_active/land_requested and every Ask hand-off
        self.decisions: queue.Queue = queue.Queue()
        self.waiting: str | None = None
        self._wait_id = 0
        self.goal_active = False
        self.land_requested = False
        self.cancelled = lambda: False
        self.feedback = lambda **_: None
        self.run_dir = None   # set by the node per goal: where locate views are saved
        self.tracker = None   # stencil tracking (track.py) while a draw's ops run
        self._chain_snap = None   # the print correction a pen-down chain is planned with (track.Tracker.snapshot)
        self._stop_why = None   # why the stroke drawing now stops: the sheet moved under it (_moved_under)
        self._correction = None   # (mean, largest) correction of the op last dispatched, m
        self._goal_touch = False   # the draw goal's touch flag, for a page set up again mid-draw
        # the next setup_page sets the page up again mid-draw (_reacquire): _kept_page; and when _new_page set one up
        # again, its start (clock utc): the track's seed is that set-up's holds
        self._again, self.seed_since = False, 0.0
        self.tool_id = ""
        self.machine = None   # the tattoo machine's switch (tatbot_session.machine), set by the node; None: none
        self.pen = None       # the draw's tatbot_motion.PenDown; None: motion.yaml's press
        self._snag = None     # the snag guard level this executor last wrote (snag_guard); None: not yet written
        self.camera: np.ndarray | None = None
        self.overhead: np.ndarray | None = None   # the overhead's own pose of the page at setup, before any locate
        self.overhead_at = 0.0                    # when (self.clock) setup took it
        self.marks = None     # where the overhead read the print's markers at setup (_mark_reference); None: its pose
        self.marked_at = 0.0  # when (self.clock) it read them so: the sheet watch's start (_sheet_watch)
        self._moved = (None, None, {})   # _timed_moves' cache: its reference, the page's normal, reading id -> move
        self._printed = None  # the print's markers' printed corners, id -> (4, 2) page metres (_layout)
        self.inked_at = 0.0                       # when (self.clock) the last stroke's goal ended
        self.placed = None   # {"page", "overhead"}: the last page the gauge holds placed, and the overhead's pose then
        self._resumed = None  # the goal's retained page row (_retained_page): a blind resume starts there (_last_page)
        self.slid = np.eye(4)   # the sheet's slide the page has followed since setup, in the arm base (_follow_sheet)
        self.surface_field = None   # a curved page's height field over the page in use (page.surface.mode fitted)
        self._surface_chart = None  # its chart, unfolded once per field
        self._patches: dict[int, np.ndarray] = {}   # each gauge hold's surface points in the base (curved.hold_patch)
        self._hold_frame = None   # the page a curved page's gauge holds were made on: its check holds are made on it
        self._hold_low = 0.0      # how far under touch.start_above_m over that page a curved page's holds stand
        self._provisional = None  # a curved page's skin from its first hold: the others stand along its normals
        self._start = None        # (that skin, its patch's hull over the page) when firm: the others start over it
        self._hop_from = None     # (touch, the commanded tip in the base) of the gauge hold the pen was last held at
        self._marks_seen: list = []   # the overhead's marker readings as a first setup began (_marks_over)
        self._over_skin: list = []    # the setup's over-centre locate views' depth, tip and tcp (_skin_seen, _skin_over)
        self._located_heading = None  # the heading those views went at, searched for the ready move (_ready_for)
        self.anchor_offset = None     # the skin under the last setup's first curved hold less those markers' height
        self.rigid_total = (np.eye(3), np.eye(3))   # a curved page's rigid follows since its holds (plane, print mm)
        self._skin_off = 0.0        # the side the last curved hover read the skin past skin_stop_m (_skin_watch)
        self._skins: list = []      # the page in use's curved hover readings: (clock, page xy, skin over the field, op)
        self._ride = ("", 0.0)      # (op id, m): how much higher than its plan that stroke rides (_ride_over)
        self._ridden = None         # (chain op ids, print points, m over the ride): its skin's profile along it
        self._preplan_ridden = None  # the profile the pre-plan was planned on
        self._set_up_for = ""       # the stroke whose skin along its path set the page up again (_skin_watch)
        self._skin_floor: dict = {}   # side -> net: the skin a fresh page's first hover read past its stop (_skin_watch)
        self._fresh = False         # the page was set up and its first hover has not read the skin yet
        self._skin_only = False     # hover stops read the skin alone: the wrist reads the print nowhere (_hover_stop)
        self._unread = 0            # hovers in a row that read no print (_unread_hover)
        self._track_since = 0.0     # the clock utc the tracker took its gauge holds from (_track_lift starts it again)
        self.correction = np.eye(4)
        self._carried_yaw = None    # the heading (turn in its page) of the last page whose holds' offset is carried
        # The last touched correction, carried into the next setup as its starting page: the
        # fixed-camera height sat 23-27 mm above the touched paper on the pink arm (bench
        # 2026-09-26), which made every slow 0.5 mm/s touch leg ~60 s long.
        self.prior_correction = np.eye(4)
        self.carried: dict | None = None   # where the last accepted page touches found the paper (_carry_paper)
        self.page_record: dict = {}
        self.resource: dict | None = None   # the program resource installed now (tool, ink, supply)
        self.charged: set[str] = set()      # dipping resources dipped during this goal; a resume dips again
        self.drawn: dict[str, list[list]] = {}
        self.trims: dict[str, float] = {}   # resource id -> the operator's pen trim (m), kept in the run's ledger
        self.trim_end = 0.0                 # the trim the last stroke goal left the arm at
        self._trim_cap = None               # the deepest trim the stroke in hand takes (_cap_for); None: any
        self._fold = 0.0                    # the ride the stroke goal's pre-plan was sent by (_ride_fold)
        self.ledger = None                  # the running draw's, where trims are written
        self.dip_scales: dict[str, float] = {}   # resource id -> the operator's dip scale (charge.py), in the ledger
        self.inked_m = 0.0                  # the line drawn since the last dip in this goal
        self.dip_asked = False              # the numpad's + asked for a dip that has not begun
        self.dipping = False                # a dip runs (dip)
        self.op_now = ""                    # the op the draw's loop runs
        self._arc_now = 0.0                 # the planned arc the running stroke goal has reached
        self._planner = planner or ThreadPoolExecutor(max_workers=1)
        self._preplan = None
        self._next_hold = None   # the next gauge hold's stand, as its loop will ask it (_plan_ahead)
        self._ahead = None       # (that stand, the hop to it planned while this hold read) (_ahead_for)
        self._land_hold = None   # (joints, snag, told a person) of a landing refused: no lift off the skin (_lift_clear)
        self._cam = None      # the wrist D405 a goal's setup reads by (setup_camera)
        self._writes, self._later = ThreadPoolExecutor(max_workers=1), []   # a setup's frames written, prints read
        self._reads = ThreadPoolExecutor(max_workers=self.READ_WORKERS)     # (_settle), each camera's print apart
        self.knot_rate = float(stack["session"]["knot_rate_hz"])
        self._sensing, self._stack_sensing = sensing, None

    # --- plumbing ------------------------------------------------------------------------------
    def event(self, kind: str, text: str = "", op_id: str = "") -> None:
        if kind == Event.KIND_OP_SENT:
            self.io.op_id = op_id   # tags the goals it sends on /tatbot/goals, for the bag
        elif kind in (Event.KIND_OP_DONE, Event.KIND_OP_ABORTED):
            self.io.op_id = ""
        self.node.event(kind, arm=self.arm, op_id=op_id, text=text)

    @property
    def sensing(self):
        """The wrist's sensing of the page (ports.Sensing): the one given, else the stack's as it reads now."""
        if self._sensing is not None:
            return self._sensing
        if self._stack_sensing is None or self._stack_sensing.wrist != gauge.wrist(self.stack):
            self._stack_sensing = gauge.sensing(self.stack, self)
        return self._stack_sensing

    def stopping(self) -> bool:
        return self.land_requested or self.cancelled()

    def used(self) -> np.ndarray:
        if self.camera is None:
            raise RuntimeError("no page pose known")
        trim = self.stack["page"].get("trim", {}).get(self.arm, [0.0, 0.0])
        return geometry.page_used(self.camera, self.correction, trim)

    def tcp(self, q=None) -> np.ndarray:
        return self.kin.fk(self.io.measured() if q is None else q)

    def _curved(self) -> bool:
        """page.surface.mode fitted with a wrist that senses the page: fitted as a surface from the gauge holds (curved.py)."""
        return curved.config(self.stack)["mode"] == "fitted" and self.sensing.wrist != "none"

    def surface(self):
        """The curved page in use (tatbot_motion.surface.PageSurface over used()), or None: the flat page."""
        from tatbot_motion.surface import PageSurface, unfold

        if self.surface_field is None or self.camera is None:
            return None
        if self._surface_chart is None:
            self._surface_chart = unfold(self.surface_field)
        return PageSurface(self.used(), self.surface_field, self._surface_chart)

    def _on_surface(self, op: dict | None = None) -> dict:
        """The planners' surface keywords on a curved page (page.surface.turn_pen: the pen turned to each normal,
        else square to the page as the gauge holds measured it); nothing on a flat one, whose calls stay as they were.
        A stroke riding its skin along its path (_ride_over) is planned on it (curved.Ridden)."""
        surface, ridden, turned = self.surface(), self._ridden_for(op), self._turned()
        if surface is not None and turned:
            surface = curved.Turned(surface, [r["xy"] for r in turned], [r["lift_m"] for r in turned])
        if surface is not None and ridden is not None:
            surface = curved.Ridden(surface, ridden[1], ridden[2])
        return {} if surface is None else {"surface": surface, "turn_pen": bool(curved.config(self.stack)["turn_pen"])}

    def _ridden_for(self, op: dict | None):
        """(its chain's op ids, print points, offsets) when `op` rides its skin's profile (_ride_over), else None."""
        return self._ridden if op is not None and self._ridden is not None and op.get("id") in self._ridden[0] else None

    def knots(self, traj):
        from tatbot_motion import to_knots

        return to_knots(traj, self.knot_rate)

    # --- decisions -----------------------------------------------------------------------------
    def refusal(self) -> str | None:
        """Why the arm takes no Draw or Touch goal whatever it asks, or None: a landed arm idles until the stack
        restarts, and every move would report success with the arm at rest."""
        return rules.landed_refusal(self.arm) if self.io.flag("landed") else None

    def begin_goal(self) -> bool:
        """Take the arm for a Draw or Touch goal; False when it is busy."""
        with self._lock:
            if not self.busy.acquire(blocking=False):
                return False
            # a draw's own (_last_page); a landing held before it is held again once its goal moved the arm
            self.goal_active, self.land_requested, self._resumed, self._land_hold = True, False, None, None
            return True

    def end_goal(self) -> None:
        """Release the arm; a LAND accepted while the goal ran but not yet carried out lands now."""
        try:   # the setup's background work waited for and its camera closed, whatever the goal did
            for done in (self._settle, self._close_camera):
                try:
                    done()
                except Exception as error:   # a frame not written, a print not read, a camera that would not stop
                    self.event(Event.KIND_ERROR, f"setup: {error}")
            if self.land_requested and (landed := self._land_now())[0]:
                self.node.event(Event.KIND_LANDED, arm=self.arm, text=landed[1])
        finally:
            with self._lock:
                self.goal_active = self.land_requested = False
                self.busy.release()

    def decide(self, decision: int, timeout: float = 15.0, asked: bool = False) -> tuple[bool, str]:
        """Called from the Decide service thread (`asked`, a person's) and the Land action's. Hands the decision to the
        waiting executor, or acts directly on an idle arm (CONTINUE unlatches, LAND lands)."""
        with self._lock:
            ask = Ask(decision, self._wait_id) if self.waiting is not None else None
            if ask is not None:
                self.decisions.put(ask)
            elif decision == rules.LAND and self.goal_active:
                self.land_requested = True
                return True, "landing after the current goal stops"
        if ask is not None:
            try:
                return ask.reply.get(timeout=timeout)
            except queue.Empty:
                with self._lock:
                    if not ask.taken:
                        ask.abandoned = True
                        return False, "the executor did not answer"
                return ask.reply.get()  # taken: the executor answers once it has acted
        why = rules.check(None, decision)
        if why:
            return False, why
        if not self.busy.acquire(blocking=False):
            return False, "the arm is busy with another decision"
        try:
            if decision == rules.CONTINUE:
                if not self.io.latched:
                    return False, "nothing waits for continue"
                why = self.continue_refusal(self.io.measured())
                return (False, why) if why else self.io.unlatch()
            return self._land_now(asked)
        finally:
            self.busy.release()

    def continue_refusal(self, q_latched) -> str | None:
        joint, tip = geometry.pose_moved(q_latched, self.io.measured(), self.kin.fk)
        tool_changed = bool(self.tool_id) and config.fitted_tool(self.repo, self.arm) != self.tool_id
        return rules.continue_refusal(estop_ok=self.io.estop_ok, controller_error=self.io.flag("controller_error"),
                                      joint_moved_rad=joint, tip_moved_m=tip, tool_changed=tool_changed)

    def wait_decision(self, kind: str, op_id: str = "", index: int = 0, ledger=None) -> int:
        """Block until an accepted Decide. Returns the decision; LAND also comes from a Land request or
        the resume timeout. Raises Cancelled when the goal is cancelled. Only a Decide made during this
        wait answers it; one left in the queue when the wait ends is refused, never kept for the next."""
        self.machine_off()
        with self._lock:
            self._wait_id += 1
            wait_id, self.waiting = self._wait_id, kind
            self._drain("nothing waits for that decision now")
        self.feedback(phase=P.PHASE_LATCHED if kind == "latched" else P.PHASE_PAUSED, op_id=op_id, index=index)
        watch = {"q": self.io.measured() if kind == "latched" or self.io.latched else None,
                 "released": self.clock.now() if self.io.estop_ok else None}
        try:
            while True:
                if self.cancelled():
                    raise Cancelled()
                if self.land_requested or self._resume_expired(watch, op_id):
                    return rules.LAND
                if kind == "latched" and self.io.flag("controller_error"):
                    self.event(Event.KIND_DECISION, "the controller reports an error: no decision can move the arm "
                               "until the stack restarts; ending the run", op_id)
                    return rules.LAND
                try:
                    ask = self.decisions.get(timeout=0.1)
                except queue.Empty:
                    continue
                with self._lock:
                    if ask.abandoned or ask.wait_id != wait_id:
                        ask.reply.put((False, "nothing waits for that decision now"))
                        continue
                    ask.taken = True
                why = "the executor failed while acting on it"
                try:
                    why = self._refusal(kind, ask.decision, watch["q"])
                finally:
                    ask.reply.put((why is None, why or ""))
                name = rules.NAMES.get(ask.decision, str(ask.decision))
                self.event(Event.KIND_DECISION, f"{name} refused: {why}" if why else name, op_id)
                if why is None:
                    if ledger is not None:
                        ledger.append("decision", self.arm, op=op_id or None, index=index if op_id else None,
                                      decision=name)
                    return ask.decision
        finally:
            with self._lock:
                self.waiting = None
                self._drain("nothing waits for that decision now")

    def _drain(self, why: str) -> None:
        """Refuse every queued Ask (called with _lock held)."""
        while True:
            try:
                ask = self.decisions.get_nowait()
            except queue.Empty:
                return
            ask.reply.put((False, why))

    def _resume_expired(self, watch: dict, op_id: str) -> bool:
        """Track the latch and its release; True once a released latch waited past resume_timeout_s, or at once when
        it is an e-stop's and session.estop_release is land (_estop_released)."""
        if watch["q"] is None and self.io.latched:
            watch["q"] = self.io.measured()
        if watch["q"] is None:
            return False
        if not self.io.estop_ok:
            watch["released"] = None
        elif watch["released"] is None:
            watch["released"] = self.clock.now()
        timeout_s = float(self.stack["session"]["resume_timeout_s"])
        if self._estop_released():
            self.event(Event.KIND_DECISION, "e-stop released: landing (session.estop_release)", op_id)
            return True
        if rules.resume_expired(watch["released"], self.clock.now(), timeout_s):
            self.event(Event.KIND_DECISION, f"no decision {timeout_s:.0f} s after release: landing", op_id)
            return True
        return False

    def _estop_released(self) -> bool:
        """An e-stop's latch (pressed, or its heartbeat silent) with the e-stop reading released again, and
        session.estop_release land: held while pressed, the arm lands once it is released (owner, 2026-10-24)."""
        return ((self.stack.get("session") or {}).get("estop_release", "decide") == "land" and self.io.latched
                and self.io.estop_ok and self.io.latch_reason in (names.LATCH_ESTOP, names.LATCH_ESTOP_STALE))

    def _refusal(self, kind: str, decision: int, q_latched) -> str | None:
        """Why a decision is refused now, or None; an accepted CONTINUE on a latched arm has unlatched."""
        why = rules.check(kind, decision)
        if why is None and decision == rules.CONTINUE and (q_latched is not None or self.io.latched):
            why = self.continue_refusal(q_latched if q_latched is not None else self.io.measured())
            if why is None:
                ok, text = self.io.unlatch()
                why = None if ok else text
        return why

    def snag_guard(self, on: bool) -> None:
        """The driver's snag guard (ros/README.md 8) armed while a riding needle may be in the work: from a riding
        draw's first stroke goal through every lift and travel after it, until a dip, a page setup, a landing or the
        goal's end disarms it. Never for a pen that does not ride."""
        level = names.GUARD_SNAG if on and self.pen is not None and self.pen.machine else names.GUARD_NONE
        if level == self._snag:
            return
        self.io.write(guard_mode=level)
        self._snag = level
        if level:
            self.io.wait(lambda: self.io.latched or self.io.safety.get("guard_mode") == level, 1.0)

    def machine_off(self) -> None:
        """Ask for the tattoo machine off (the module docstring says when). The Pi powers it off by itself on the
        e-stop and when the session goes silent."""
        if self.machine is not None and self.machine.on:
            self.machine.set(False)
            self.event(Event.KIND_MACHINE, "machine off")

    def machine_running(self, op_id: str, index: int, ledger, again: bool = True) -> bool:
        """The tattoo machine on, as its switch reports it within machine.confirm_s, before a riding goal: True. Else the
        run pauses: land lands; continue asks again, or with again=False returns False (off): a stroke re-measures first."""
        was = self.machine.on
        while not self.machine.wait(True, self._confirm_s()):
            why = self.machine.why_off()
            self.machine.set(False)
            self.event(Event.KIND_PAUSE, f"the tattoo machine did not start: {why}; continue asks again, land lands",
                       op_id)
            if self.wait_decision("pause", op_id, index, ledger) == rules.LAND:
                self.land()
            if not again:
                return False
            was = False
        if not was:
            self.event(Event.KIND_MACHINE, "machine on", op_id)
        return True

    def _confirm_s(self) -> float:
        return float((self.stack.get("machine") or {}).get("confirm_s", 1.0))

    def require_off(self, activity):
        """The machine off, as its switch reports it, before motion that must not run it (a dip)."""
        self.machine_off()
        powered = bool(self.resource and self.resource['tool'].get('stroke_mm')) or (self.pen.machine if self.pen else False)
        machine.require_off(self.machine, powered, self._confirm_s(), activity)

    def prepare_pen(self, program: dict) -> None:
        """Before any motion: the program must be for the fitted tool, and a riding pen needs the tool's stroke
        and a switch that answers. Sets self.pen and says how the pen meets the page."""
        import tatbot_motion

        fitted, prepared = config.fitted_tool(self.repo, self.arm), (program.get("tool") or {}).get("id")
        if prepared and prepared != fitted:
            raise RuntimeError(f"the program was prepared for {prepared}, but config/workspace.yaml fits {fitted} on "
                               f"the {self.arm} arm: compile it for the fitted tool")
        riding = self.motion["pen"]["mode"] == tatbot_motion.RIDE
        self.pen = tatbot_motion.pen_down(self.motion, config.tool_datasheet(self.repo, fitted) if riding else None)
        self._pen_height()
        if riding and self.machine is None:
            raise RuntimeError(f"motion.yaml pen.mode ride runs the tattoo machine, and stack.yaml machine switches "
                               f"none on the {self.arm} arm")
        if riding and not self.machine.wait(False, self._confirm_s()):
            raise RuntimeError(f"the tattoo machine's switch does not answer: {self.machine.why_off()}")
        self.event(Event.KIND_PAGE, f"pen down: {self.pen.describe()}")

    def land(self, why: str = "") -> None:
        self.feedback(phase=P.PHASE_LANDING)
        self.event(Event.KIND_DECISION, "landing")
        ok, text = self._land_now()
        if ok:
            self.event(Event.KIND_LANDED, text)
        raise Landed(why if ok and why else text)

    def _land_now(self, asked: bool = False) -> tuple[bool, str]:
        """Lift clear of the page first when the pen may be on it (the driver's staged move would drag it
        sideways), then the driver's landing; `asked`: a person's decide (_hold_unlifted). Why not goes on
        /tatbot/events whichever way the land came: a Land action's or a decide's on an idle arm too."""
        why = in_cap_refusal(self.arm)
        if not why and self.io.flag("controller_error"):
            why = ("the controller reports an error, so the driver moves nothing: `tatbot ros up` restarts the stack, "
                   "whose configure clears it, then withdraws the pen and lands")
        why = why or self._lift_clear(asked)
        with self._lock:
            self.land_requested = False
        if not why:
            self.snag_guard(False)
            ok, why = self.io.land(self.stack["safety"]["landing"]["budget_s"])
            if ok:
                return ok, why
        self.event(Event.KIND_ERROR, why)
        return False, why

    def _height(self, q=None, page=None) -> float | None:
        """Tip height over the page in use (m), or None before a page is known."""
        return None if self.camera is None else self._over(self.tcp(q)[:3, 3], page)

    def _over(self, point, page=None) -> float:
        """How far a base point stands over the page in use (m), over its surface when curved; over `page`'s plane."""
        surface = self.surface() if page is None else None
        if surface is not None:
            return float(surface.height_over(np.asarray(point, float))[0])
        page = self.used() if page is None else page
        return float(page[:3, 2] @ (np.asarray(point, float) - page[:3, 3]))

    def lift_plan(self, distance, direction=None):
        from tatbot_motion import plan_lift

        if direction is None:
            direction = self._up(self.tcp()[:3, 3])
        return self.knots(plan_lift(q_seed=self.io.seed(), direction=direction, distance_m=distance, kin=self.kin,
                                   motion=self.motion))

    def _up(self, point) -> np.ndarray:
        """The page's normal at a base point, which a lift rises along: the curved page's there, else the page in use's."""
        surface = self.surface()
        return self.used()[:3, 2] if surface is None else surface.height_over(np.asarray(point, float))[1]

    # the landing's staged move turns the wrist: from 10 mm over the skin the needles nearly scraped across it
    # (operator, 2026-10-13), so the tip first rises this far along the skin's normal
    LAND_CLEAR_M = 0.040
    LAND_HOLD_M = 0.020   # a tip no lift took this far over the skin holds (_hold_unlifted): twice that near-scrape
    AT_REST_RAD = 0.2   # within this of the sleep pose on every arm joint the arm is at rest: no pen to withdraw

    def _lift_clear(self, asked: bool = False) -> str | None:
        """Before landing: a tip under LAND_CLEAR_M over the page lifts along the normal, unlatching with the
        hold goal when the e-stop is released. With no page known (a stack restarted after a controller drop: on
        2026-10-06 the controller closed its connection 49 s into a stroke and the 3RL's needles stayed in the
        half-skin) an arm away from rest withdraws the pen approach.withdraw_m along its own axis: the idled
        controller let the tip sag 9-13 mm into the skin before the restart (2026-10-08), so the standoff alone
        left it there; not a tip the cameras' page puts clear of the skin (_skin_height): on 2026-10-21 one 0.51 m over
        it and 0.25 m beside the print held, its withdraw needing joint_1 past its stop. A needle the snag guard stopped
        (its landing held since too: _land_hold) withdraws a standoff along the pen from wherever it stands, under the
        guard: on 2026-10-08 the work held it after the lift had reached the standoff; then, still guarded, it rises
        LAND_CLEAR_M along the skin's normal like any landing's (from the standoff the sweep nearly scraped the skin,
        2026-10-13). In steps when it must be (_lift_steps); then why the arm must not land (its landing would sweep
        the work along): the snag guard held the lift, the tip is left near the skin, the driver keeps its latch (it
        lands from the latched pose: a needle the work dragged off it, 2026-10-21 review), or anything here failed. A
        person's land (`asked`) lands from a hold they were told."""
        held, self._land_hold = self._land_hold, None
        told = held is not None and held[2] and float(np.max(np.abs(self.io.measured()[:6] - held[0][:6]))) < 0.01
        snag = (self.io.latched and self.io.latch_reason == names.LATCH_GUARD_SNAG) or (held is not None and held[1])
        said = []

        def hold(within: bool, failed: str) -> str | None:
            if not (within and asked and told):
                return self._hold_unlifted(within, failed, snag, asked or told)
            if not said:
                self.event(Event.KIND_DECISION, "landing from the hold as a person decided: no lift planned off the skin")
                said.append(True)
            return None
        try:
            if not self.io.estop_ok:
                return None
            lift = self._clearing_lift(snag)
            if lift is None:
                return None
            if self.io.latched and not (unlatched := self.io.unlatch())[0]:
                return hold(self._left_near(lift[1], True), unlatched[1])
            if snag:
                self.snag_guard(True)
            why = self._lift_steps(*lift, hold)
            if why is None and snag and self.camera is not None and self.io.estop_ok and (
                    lift := self._clearing_lift(False)) is not None:
                why = self._lift_steps(*lift, hold)
            return why
        except Exception as exc:  # noqa: BLE001 - where the tip is unknown: it holds as one near the skin
            self.event(Event.KIND_ERROR, f"lift before landing: {exc}")
            return hold(True, str(exc))

    LIFT_STEP_M, LIFT_STEPS = 0.005, 10   # _lift_steps' steps along the pen, at most this many

    def _lift_steps(self, distance, direction, where, hold) -> str | None:
        """_lift_clear's lifts: the first of _lift_plans, then LIFT_STEP_M steps along the pen, each planned from the
        measured joints (after one that failed too), until the tip clears (by its height, else all of `distance` along
        the pen). `hold` (_lift_clear's) decides."""
        from tatbot_motion.clik import PlanError

        lifted, failed = 0.0, ""
        for attempt in range(1 + self.LIFT_STEPS):
            # still to lift: along the pen by what it lifted, along the normal by the tip's height measured again
            need = distance - lifted if direction is not None else (self._clearing_lift(False) or [0.0])[0]
            if need <= 0.001:
                break
            step = min(need, self.LIFT_STEP_M)
            try:
                traj, length, how = (self._lift_plans(need, direction, where) if attempt == 0 else
                                     (self.lift_plan(step, -self.tcp()[:3, 2]), step, "along the pen"))
            except PlanError as exc:
                failed = str(exc)
                self.event(Event.KIND_ERROR, f"lift before landing: {exc}")
                if attempt:
                    break
                continue
            self.feedback(phase=P.PHASE_LIFT)
            status, _, text = self.io.execute(traj)
            if status == "latched" and self.io.latch_reason == names.LATCH_GUARD_SNAG:
                return ("not landing: the snag guard held the lift before landing, the needle held in the work. The arm "
                        "holds there: free the needle, then `tatbot ros decide land`")
            if status != "ok":
                failed = text
                self.event(Event.KIND_ERROR, f"lift before landing: {text}")
                if not self.io.estop_ok:   # pressed: it lands from where it stands, as when pressed before the lift
                    return None
                if self.io.latched and not self.io.unlatch()[0]:
                    break
                continue
            lifted += length
            self.event(Event.KIND_DECISION, f"lifted {length * 1000:.1f} mm {how} before landing")
        return hold(self._left_near(direction, lifted < distance - 0.001), failed)

    def _left_near(self, direction, short: bool) -> bool:
        """Whether a tip a lift before landing left holds (_hold_unlifted): under LAND_HOLD_M over the skin under it
        (_skin_height); one lifted along the pen (with no page in use, or a snag's needle) only `short` of the lift."""
        height = self._skin_height() if direction is None or self.camera is None else None
        return (direction is None or short) and (height is None or height < self.LAND_HOLD_M - 0.001)

    def _skin_height(self) -> float | None:
        """The tip's height over the skin a landing could sweep across (m): over the page in use (_height), else over
        the cameras' page measured within page.max_lost_s (a restarted stack knows none until a goal sets one up); inf
        past the print and LAND_CLEAR_M round it, where the page's plane runs on over no skin; None with no page."""
        tip, newest = self.tcp()[:3, 3], None if self.camera is not None else self.node.camera_page(self.arm)
        if self.camera is None and (newest is None or newest[0] is None or geometry.stale_page(
                newest[1], float(self.stack["page"].get("max_lost_s", 5.0)))):
            return None
        page = self.used() if self.camera is not None else np.asarray(newest[0], float)
        local = np.linalg.inv(page) @ [*tip, 1.0]
        if np.any(np.abs(local[:2]) > np.asarray(self.stack["page"]["size_m"], float) / 2 + self.LAND_CLEAR_M):
            return np.inf
        return self._height() if self.camera is not None else float(local[2])

    def _hold_unlifted(self, within: bool, failed: str, snag: bool, told: bool) -> str | None:
        """A tip _lift_steps left under LAND_HOLD_M over the skin (with no page or after a snag, short of its withdraw)
        holds there, the machine off, and why is returned: on 2026-10-21 the landing's wrist turn swept the needles from
        the skin after two lifts failed. Every land holds again but a person's at a hold `told` them (_lift_clear): an
        automatic land's hold (the draw wrapper's) is first said to a person whose land then holds."""
        if not within:
            return None
        self._land_hold = (self.io.measured(), snag, told)
        self.machine_off()
        return (f"not landing: no lift off the skin plans from here ({failed or 'none planned'}), and the landing's "
                "wrist turn would sweep the needles across it. The arm holds there, the machine off: " +
                (f"once the person is clear of the needles, `tatbot ros decide {self.arm} land` again lands from here"
                 if told else f"a person's `tatbot ros decide {self.arm} land` first says this to them; once they are "
                 "clear of the needles, their next lands from here"))

    def _clearing_lift(self, snag: bool):
        """The lift before landing (_lift_clear) as (distance, direction or None for the page normal, how), or None
        when the pen is clear of the skin (_skin_height) or, with no page known, at rest."""
        from tatbot_session import inspect as ins

        standoff = float(self.motion["approach"]["standoff_m"])
        height, clear = self._skin_height(), max(standoff, self.LAND_CLEAR_M)
        if self.camera is None:   # at rest, or clear of the cameras' page: nothing to withdraw
            if np.all(np.abs(self.io.measured()[:6] - ins.REST[:6]) < self.AT_REST_RAD) or (
                    height is not None and height >= clear - 0.001):
                return None
            return float(self.motion["approach"]["withdraw_m"]), -self.tcp()[:3, 2], "along the pen"
        if snag:   # the needle out the way it went in, from wherever it stands
            return standoff, -self.tcp()[:3, 2], "along the pen"
        return None if height >= clear - 0.001 else (clear - max(height, 0.0), None, "along the skin's normal")

    # --- moves ---------------------------------------------------------------------------------
    def move(self, make, phase: int, what: str, ledger=None) -> None:
        """Run a non-stroke motion (travel, lift); after a latch or failure wait for a decision and re-plan it from the
        measured joints on CONTINUE; after a snag-guard trip the needle comes out at once (_withdraw), and the first
        goes on by itself."""
        trips = 0
        while True:
            traj = make()
            self.feedback(phase=phase)
            status, _, text = self.io.execute(traj, should_stop=self.stopping)
            if status == "ok":
                return
            if status == "cancelled" and not self.land_requested:
                raise Cancelled()
            if status != "cancelled":
                self.event(Event.KIND_LATCHED if status == "latched" else Event.KIND_ERROR, f"{what}: {text}")
            trips += (snag := status == "latched" and self.io.latch_reason == names.LATCH_GUARD_SNAG)
            if not (snag and self._withdraw("", trips > 1) and trips < 2) and self.wait_decision(
                    "latched", ledger=ledger) == rules.LAND:
                self.land()

    def _lift_plans(self, distance, direction=None, where="along the skin's normal"):
        """(plan, length, how) of the first lift that plans: `distance` along `direction` (None: the page's normal)
        and along the pen, then half as far each way. PlanError when none does."""
        from tatbot_motion.clik import PlanError

        ways = [(direction, where)] + ([(-self.tcp()[:3, 2], "along the pen")] if direction is None else [])
        tries = [(length, way) for length in (distance, distance / 2) for way in ways]
        for i, (length, (way, how)) in enumerate(tries):
            try:
                return self.lift_plan(length, way), length, how
            except PlanError:
                if i == len(tries) - 1:
                    raise

    def lift(self, what: str, ledger=None) -> None:
        """Straight up along the page normal to the standoff (after a touch, before leaving the page); one the arm
        cannot follow there goes along the pen, then half as far (_lift_plans)."""
        distance = float(self.motion["touch"]["lift_m"])
        self.move(lambda: self._lift_plans(distance)[0], P.PHASE_LIFT, what, ledger)
        self._hop_from = None   # off any hold's stand (_hold_travel)

    def lift_off(self, what: str, ledger=None) -> None:
        """A tip within the standoff of the page in use lifts along its normal (lift) before it travels."""
        height = self._height()
        if height is not None and height < float(self.motion["approach"]["standoff_m"]) - 0.001:
            self.lift(what, ledger)

    BRANCH_RAD = 0.1         # a ready pose this far from the page's recorded one, on any joint, is another branch

    def _page_ready(self, record: dict | None = None) -> dict | None:
        """The page's ready pose ({"q", "heading"}): recorded by this run's first ready move, else carried with
        the paper from the last run on the same page (_carried_paper) unless its heading turns past 45 deg from the
        dips' (_dip_heading: a run before strokes went at it); of `record`, else the page record."""
        record = self.page_record if record is None else record
        own, carried = record.get("ready"), (record.get("carried") or {}).get("ready")
        if own or not carried or (dips := self._dip_heading()) is None:
            return own or carried
        turn = ready.heading_yaw(self.used(), np.asarray(carried["heading"], float)) - ready.heading_yaw(self.used(), dips)
        return carried if abs(np.angle(np.exp(1j * turn))) <= np.pi / 4 else None

    def _dip_heading(self) -> np.ndarray | None:
        """The rotation every dip of the fitted tool goes at (cap.py: the station touch's), when one speaks for it."""
        from tatbot_motion import station

        try:
            touch, fitted = station.load_touch(self.arm), config.fitted_tool(self.repo, self.arm)
        except (station.StaleStationError, OSError, ValueError, KeyError):
            return None
        same = touch.tool_id == fitted or station.same_machine(self.repo, touch.tool_id, fitted)
        return np.asarray(touch.rotation, float) if same else None

    def _ready_seed(self) -> np.ndarray:
        """Where every ready choice solves from: the page's recorded ready joints, else the landing rest pose,
        never the joints the arm happens to hold. The arm's tip height error depends on its IK branch (~5 mm per
        radian of joint 6), and on 2026-10-03 the same page reached from a locate view and from rest took
        branches with joint 6 at -0.10, +0.29 and +0.75 rad: the paper read 3.0, 4.7 and 7.0-7.9 mm."""
        from tatbot_session import inspect as ins

        recorded = (self._page_ready() or {}).get("q")
        seed = ins.REST.copy() if recorded is None else np.asarray(recorded, float).copy()
        seed[6] = self.io.seed()[6]   # the carriage holds where it is
        return seed

    def _ready_for(self, page: np.ndarray, pattern_id) -> tuple[np.ndarray, np.ndarray]:
        """The heading and IK seed the ready move will take on `page` before its record exists (pen_heading,
        _ready_seed): the carried paper's ready pose on the same print, else pen_heading's search from rest, kept for
        the ready move (_located_heading). The locate's over-centre views go at them, so the ready move only descends."""
        from tatbot_session import inspect as ins

        recorded = self._page_ready({"carried": self._carried_paper(page, {"pattern_id": pattern_id}, height=False)})
        seed = ins.REST.copy() if recorded is None else np.asarray(recorded["q"], float).copy()
        seed[6] = self.io.seed()[6]
        if recorded is not None:
            return np.asarray(recorded["heading"], float), seed
        self._located_heading = ready.pen_heading(self.kin, page, self.stack["page"]["clear_m"],
                                                  float(self.motion["approach"]["standoff_m"]), seed,
                                                  prefer=self._dip_heading())
        return (self.tcp() if self._located_heading is None else self._located_heading), seed

    def pen_heading(self) -> np.ndarray:
        """A tcp pose whose x axis is the pen heading (its turn about its own axis) that keeps every joint
        farthest from its limits over the clear centre. The ballpoint is round, so the heading is free,
        and every later plan keeps the ready pose's heading: the one the arm arrived with put joint_3
        0.04 rad from its limit over a page near the base line (2026-09-26) where
        another left 0.6 rad. The page's recorded heading when it has one (_page_ready: this run's, else the one
        carried from the last run on this page); else the search from _ready_seed, the first of the headings
        tied (ready.HEADING_TIE_RAD) with the best. The margins of several headings differ by less than a page height's
        few millimetres move them (45 and 60 deg trade places over 8 mm), and a bare best flipped between
        headings 23-49 deg apart from one resume to the next: only a new page searches, nearest the dips' heading
        first (ready.PREFER_MARGIN_RAD), so no dip turns the wrist round the pen and back. A setup's locate searches it
        first (_ready_for), and the ready move takes that one."""
        recorded = (self._page_ready() or {}).get("heading")
        if recorded is not None:
            return np.asarray(recorded, float)
        if self._located_heading is not None:
            return np.asarray(self._located_heading, float)
        heading = ready.pen_heading(self.kin, self.used(), self.stack["page"]["clear_m"],
                                    float(self.motion["approach"]["standoff_m"]), self._ready_seed(),
                                    prefer=self._dip_heading())
        return self.tcp() if heading is None else heading

    READY_HIGH_M = 0.060   # the tool over the page centre this high, when the direct ready move would dip
    REST_RAD = 0.05        # a pose this close to rest (the landing sleep pose) leaves the page to the cameras

    def clear_view(self, ledger=None) -> None:
        """Back to rest, holding, so the fixed cameras can measure a lost page again. A cancelled draw holds
        where it stopped, over the print, and the anchoring camera could not see it (2026-09-28); landing would
        restart the controller. A pen within the standoff lifts first; a path that would take it within half the
        standoff of the page is not taken, and the page wait then decides as before."""
        from tatbot_session import inspect as ins

        rest = ins.REST.copy()
        rest[6] = self.io.seed()[6]
        if float(np.max(np.abs(self.io.measured()[:6] - rest[:6]))) <= self.REST_RAD:
            return
        standoff = float(self.motion["approach"]["standoff_m"])
        self.lift_off("lift before clearing the cameras' view", ledger)
        # the lift ran under the snag guard, so a needle the work held has stopped it; the swing to rest is a travel
        # off the work, and at rest the joints lie ~1 deg off REST against their stops, the tip 4.4 mm off its
        # command: the guard latched there and the run ended (silicone practice, 2026-10-21)
        self.snag_guard(False)

        def make():
            return ready.pen_up_joint_move(self.kin, self.motion, self.io.seed(), rest, self.knot_rate, P.PHASE_TRAVEL)

        def high():
            q = self.io.seed()
            target = geometry.tool_down_pose(self.used(), [0.0, 0.0], self.READY_HIGH_M, self.tcp())
            return ready.pen_up_joint_move(self.kin, self.motion, q, ready.solve_ik_seeded(self.kin, target, q),
                                           self.knot_rate, P.PHASE_TRAVEL)

        floor = 0.5 * standoff
        if self.camera is not None and self.lowest_over_page(make()) < floor:
            # from a hold over a skin pinned on a raised holder the joint move to rest swept the pen back over it
            # 4 mm up (2026-10-08) and the arm, refusing, hid the page from the overhead until the run gave up:
            # over the page centre at READY_HIGH_M first, as the ready move goes, then to rest from there
            try:
                up = self.lowest_over_page(high())
            except Exception:   # a leg up that cannot be planned is not taken
                up = -np.inf
            if up < floor:
                self.event(Event.KIND_PAGE, "the move to rest would pass the pen within {:.0f} mm of the page; "
                           "not moving".format(floor * 1e3))
                return
            self.move(high, P.PHASE_TRAVEL, "over the page, high, clearing the cameras' view", ledger)
            if self.lowest_over_page(make()) < floor:
                self.event(Event.KIND_PAGE, "the move to rest from over the page would pass the pen within {:.0f} mm "
                           "of it; holding high".format(floor * 1e3))
                return
        self.move(make, P.PHASE_TRAVEL, "rest, clearing the cameras' view of the page", ledger)

    def lowest_over_page(self, traj, page=None) -> float:
        """The planned tip's lowest height over the page in use along its normal (m); +inf with no tip."""
        tip = np.asarray(getattr(traj, "tip", ()), float).reshape(-1, 3)
        tip = tip[np.isfinite(tip).all(axis=1)]
        if not len(tip):
            return float("inf")
        surface = self.surface() if page is None else None
        if surface is not None:
            return float(min(surface.height_over(p)[0] for p in tip[::max(1, len(tip) // 200)]))
        page = self.used() if page is None else page
        return float(np.min((tip - page[:3, 3]) @ page[:3, 2]))

    def go_ready(self, ledger=None) -> None:
        """Joint-space move to the tool over the page centre at the standoff (the arm rests on joint
        limits the Cartesian planner keeps clear of). A tip already below the standoff lifts first.

        A joint-space move keeps its ends clear of the page, not its path: from a locate view (the pen
        15 mm up, the camera tilted 50 deg) to the ready pose it swept the tip 5-12 mm through a page
        placed near the arm base (bench 2026-09-27). A planned tip that comes within half the standoff
        of the page goes up first (a straight lift, then the tool over the page centre at READY_HIGH_M)
        and down from there; a path that still dips is refused before the arm moves."""
        standoff = float(self.motion["approach"]["standoff_m"])
        floor = 0.5 * standoff
        self.lift_off("lift before the ready move", ledger)
        heading = self.pen_heading()

        seed = self._ready_seed()

        def joint_to(height_m):
            target = geometry.tool_down_pose(self.used(), [0.0, 0.0], height_m, heading)

            def make():
                q = self.io.seed()
                traj = ready.pen_up_joint_move(self.kin, self.motion, q, ready.solve_ik_seeded(self.kin, target, seed),
                                               self.knot_rate, P.PHASE_TRAVEL)
                low = self.lowest_over_page(traj)
                if low < floor:
                    raise RuntimeError("the ready move would take the pen {:+.1f} mm over the page (under {:.0f} mm); "
                                       "not moving".format(low * 1e3, floor * 1e3))
                return traj
            return make

        try:
            joint_to(standoff)()
        except RuntimeError as dip:
            self.event(Event.KIND_REPLAN, f"{dip}: over the page centre at {self.READY_HIGH_M * 1e3:.0f} mm first")
            self.lift("lift before the ready move", ledger)
            self.move(joint_to(self.READY_HIGH_M), P.PHASE_TRAVEL, "ready, high", ledger)
        self.move(joint_to(standoff), P.PHASE_TRAVEL, "ready", ledger)
        self._record_ready(heading)

    def _record_ready(self, heading) -> None:
        """The page's ready pose (joints and pen heading), which a resume and every later ready move of this page
        take again; a ready pose BRANCH_RAD off a recorded one is named: it measures and draws on another branch."""
        q = np.asarray(self.io.measured(), float)
        recorded = self._page_ready()
        self.page_record.setdefault("ready", {"q": q.tolist(), "heading": np.asarray(heading, float).tolist()})
        if recorded is None:
            return
        off = float(np.max(np.abs(q[:6] - np.asarray(recorded["q"], float)[:6])))
        if off > self.BRANCH_RAD:
            self.event(Event.KIND_PAGE, f"the ready pose is {off:.2f} rad from this page's recorded one: another IK "
                       "branch, whose tip heights differ by millimetres")

    # --- page ----------------------------------------------------------------------------------
    # The locate plans its views about the page tilted at most AIM_TILT_RAD from the base's z, its centre and turn kept;
    # each view reads the print on `prior` itself. About the overhead's page of a forearm print at 19.1 and 20.5 deg
    # (the chord plane of its markers in view, 2026-10-20) no view was reachable; about the bent layout's 14.5 and 12.6
    # deg (stencild since) 17 and 21 were, capped at 10 deg 22 and 24 (replayed without the self-collision test).
    AIM_TILT_RAD = np.radians(10.0)

    def wrist_locate(self, prior: np.ndarray, cfg: dict, ledger=None, program=None,
                     surface=None, alone: bool = False) -> tuple[np.ndarray, dict]:
        """Fuse overhead and wrist XY/yaw, recording page depth and replayable captures; `alone` (a prior no overhead
        pose placed, _blind_prior): the wrist's own, searched for over the overhead's skin when no view reads it
        (_overhead_skin).
        Each reachable view reads the print's markers on the page plane (inspect.view_fit) and samples native
        depth; see ros/README.md. On a curved page each marker corner is lifted by its own depth instead
        (track.print_read), and no depth plane gives a height: rectified onto the overhead's plane, 8.8 mm over a
        forearm's skin, a 50 deg view read no marker and the other a turn 0.5 deg off the holds' (2026-10-19). The
        corners go onto `prior` along its normal: at a first setup the overhead pose's plane, no field existing yet
        (the holds' own turn and shift then place the page); a kept page's (_kept_page) through `surface`'s chart.
        """
        from tatbot_session import inspect as ins

        # The view search solves hundreds of candidates, most unreachable: over a straight-down search's 576 (2026-10-22)
        # those that converged took 5 iterations median, 71 at most; the 274 that did not, 98% of its time at 400 each.
        solve_ik = functools.partial(ready.solve_ik, iterations=100)
        page, z, plan = self.stack["page"], prior[:3, 2], np.array(prior, float)
        tilt = min(float(np.arccos(np.clip(z[2], -1.0, 1.0))), self.AIM_TILT_RAD)   # its z turned the least onto it
        plan[:3, :3] = closeup._turn(z, [*z[:2] / max(np.hypot(*z[:2]), 1e-12) * np.sin(tilt), np.cos(tilt)]) @ prior[:3, :3]
        frame, ppm = ins.camera_frame(self.arm), 5.0
        extent = ins.page_extent(page["size_m"])
        tile = ins.print_artwork(page.get("pattern_id"))
        max_y = float(prior[1, 3]) - float(cfg.get("side_margin_m", 0.0))
        from tatbot_cli import ros_depth

        cam, clear = self.setup_camera(), float(cfg.get("clearance_m", 0.015))
        sols, views, further, best, curved_page = [], [], [], None, self._curved()
        hint = self._view_hint(plan, page.get("pattern_id"))

        def to_view(q_t):   # at a third of the pen-up speed joint_3 chattered at 5 Hz lowering, the tip 2.8-6.7 mm
            return ready.pen_up_joint_move(self.kin, self.motion, self.io.seed(), q_t, self.knot_rate, P.PHASE_TRAVEL)

        skin = self._overhead_skin(plan, ledger) if alone else None   # read at rest, the arm out of the overhead's view
        guard = getattr(self.node, "guard", None)
        self_gap = None if guard is None else (lambda q: guard.self_gap(self.arm, q))

        # The views over the print are chosen by the markers they see past the tool, straight down from as high as its
        # smallest keeps MARKER_PX and looking aside of it too; a search's (where the print may be) as before.
        see = None if tile is None else self._markers_seen(cam, plan, tile, frame)
        down = {} if see is None else {"see": see, "around": ins.AROUND,
                                       "distances_m": ins.top_down_distances(tile, cam.k[0, 0])}
        oblique = {} if see is None else {"see": see}

        def reach(n, page_n, xy):   # straight down on it first (inspect.top_down), else obliquely as before
            return self._reach_view(n, best, hint, to_view, clear, [functools.partial(
                how, self.kin, solve_ik, page_n, xy, self.io.measured(), frame=frame, clearance_m=clear, max_y=max_y,
                self_gap=self_gap, **(chosen if page_n is plan else {}))
                for how, chosen in ((ins.top_down, down), (ins.aim, oblique))], page=None if page_n is plan else page_n)
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
