hu-po/tatbot/(commit log)

2026-08-31 add community health files, CI, and repo hygiene basics
    CONTRIBUTING (explains the curated-export model and safety ground rules),
    SECURITY (private reporting, legacy repo out of scope), Contributor Covenant
    code of conduct, CITATION.cff, issue/PR templates, a Markdown link-check CI
    workflow, and a .gitignore. README gains a status note and contributing
    pointers.
2026-09-01 export 0.9.0
    source: 265da2b7a7b41aa6c23c08b174b81e981f0ebd69
    manifest: cd63945d01e6cbe18db660df72e199666fd6a760f226dae808f4930a908d5a5a
    [amcrest.stl, base_link.stl, camera_mount_d405.stl, carriage_left.stl, carriage_right.stl, d405.stl, ee_base.stl, ee_fiducial_cube.stl]
2026-09-02 export 20260902
    source: e47f976cebbc8a55ead1da6d45980f0ecbd586c8
    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
    [tatbot.urdf]
2026-10-06 export 0.10.0
    source: 42e17925603589568b456c93b45b143a00cd6b27
    [01_cradle_and_brace.stl, 01_leader_cradle.stl, 02_clamp_cap.stl, 02_oval_clamp_cap.stl, 03_mirrored_tag_carrier.stl, 03_raised_tag_carrier.stl, calibration_palette_v11.stl, complexity-debt.tsv]
